ETML-ES-SLO/PRJ_2126_AffichageMatriciel/doc/Rapports/PPT/2126_AffichageMatricielNomEtudiant_PresentationPreEtude.pptx

## Pré-étude

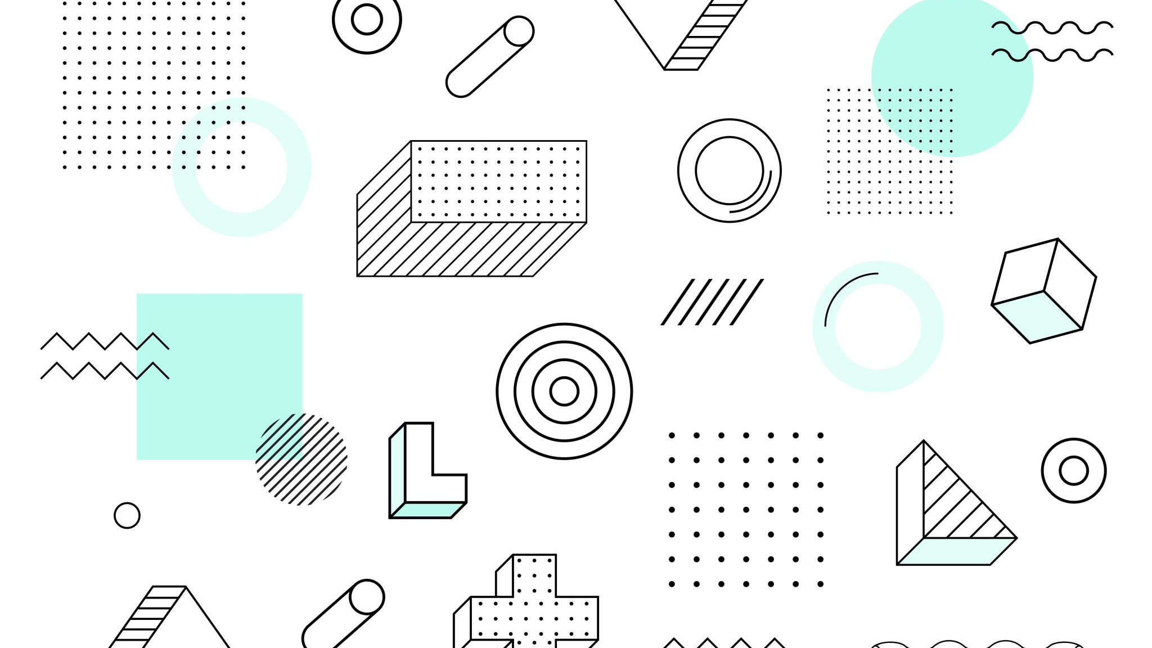
[picture p2: figure]

Projet n°2126
Affichage Matriciel Nom Etudiant

Ricardo Crespo

15 décembre 2021

## Table des matières

- But
- Schémas bloc
- Choix des technologies
- Estimation des coûts
- Conclusion
- Questions

## But du projet

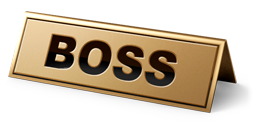
[picture p3: figure]
Download Boss Thank You Letter Templates | Text | Word | PDF

- Afficher le nom des élèves de première année
- Affichage connecté avec juste un câble USB
- Détection du nom automatique avec le compte de l’élève
- Contraintes de consommation

## Schéma bloc général

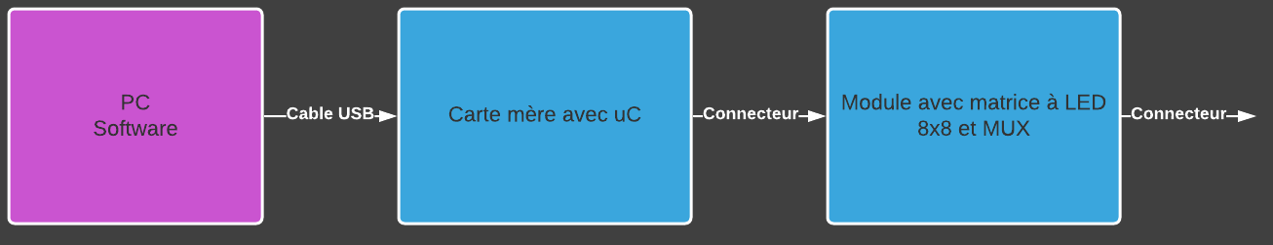
[picture p4: figure]
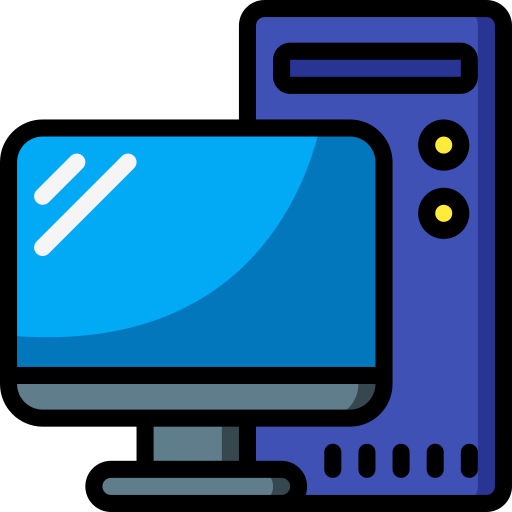
[picture p5: figure]
Pc free icon
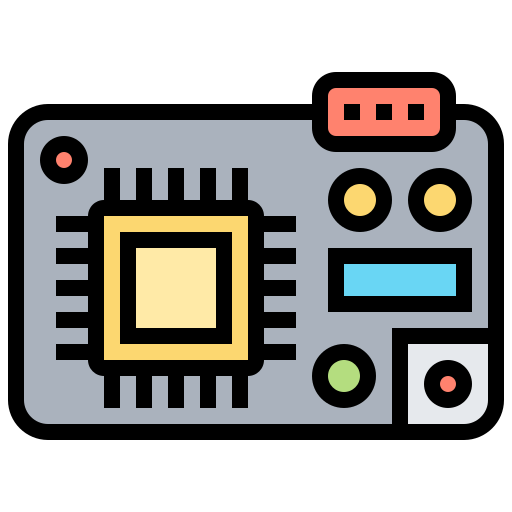
[picture p6: figure]
Microcontroller - Free electronics icons
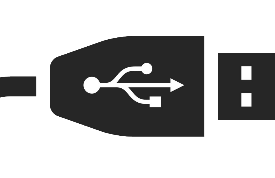
[picture p7: figure]
Computer, pc, ports, usb icon | Icon search engine
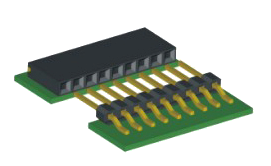
[picture p8: figure]
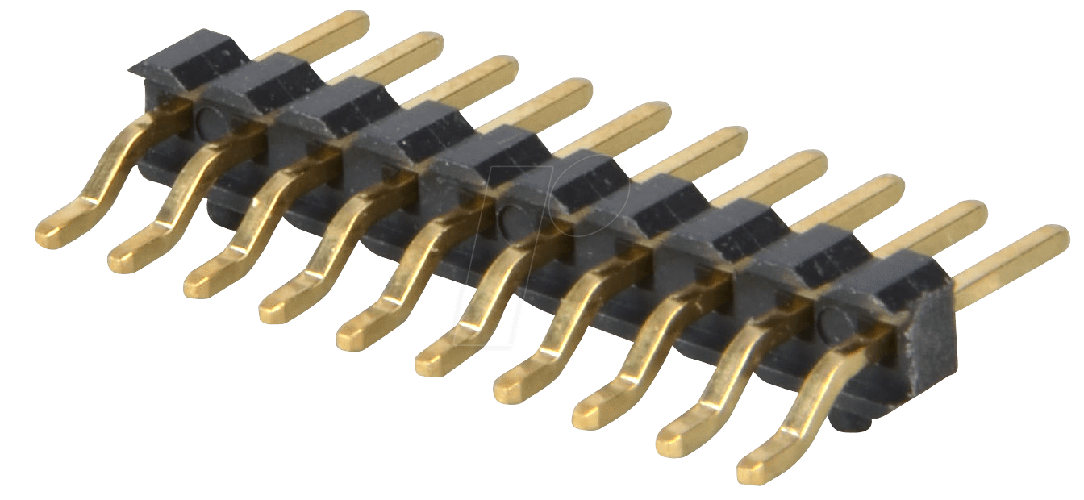
[picture p9: figure]
SL 1X10W SMD2,54: 10-pin SMD pin header, angled, pitch 2.54 at reichelt elektronik

## Schéma bloc général

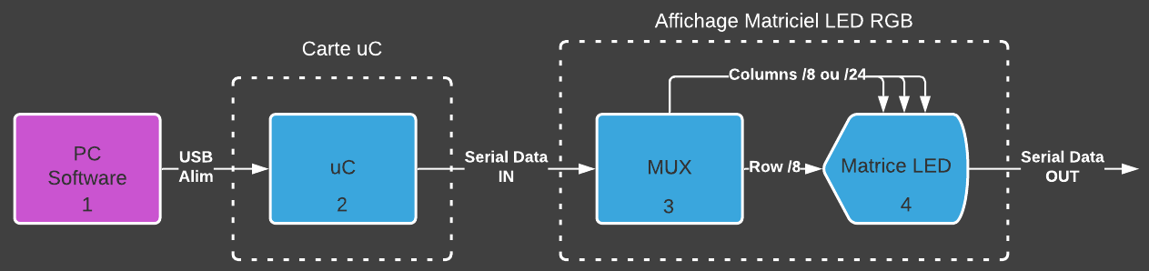
[picture p10: figure]

## Choix des technologies

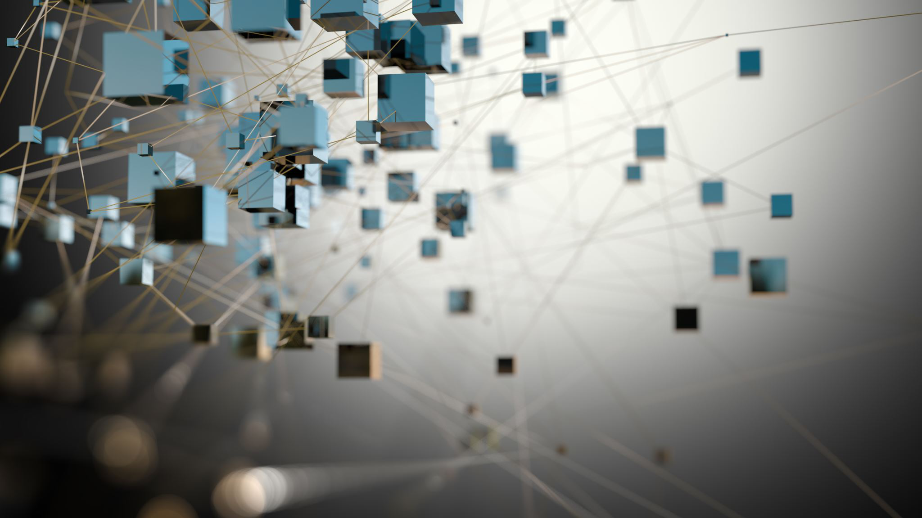
[picture p11: figure]
illustration d’un cube de cube bleu et or abstrait 3D

## LEDs

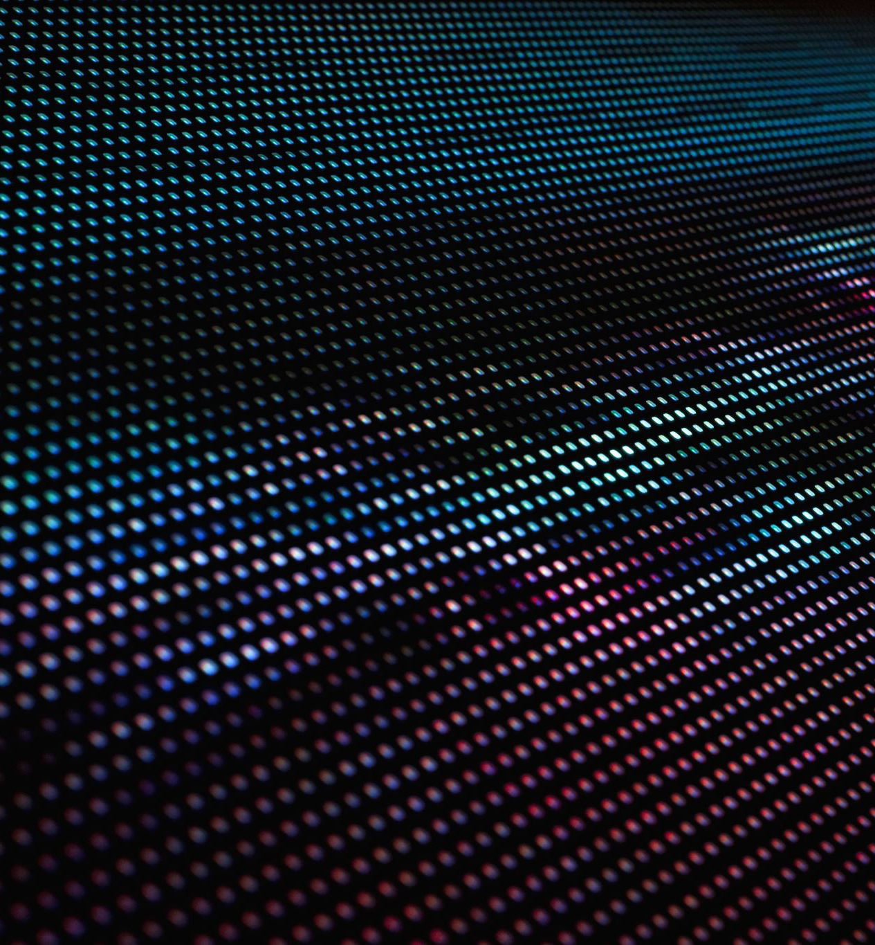
[picture p12: figure]
Vollbild-Nahaufnahme einer LED-Anzeige
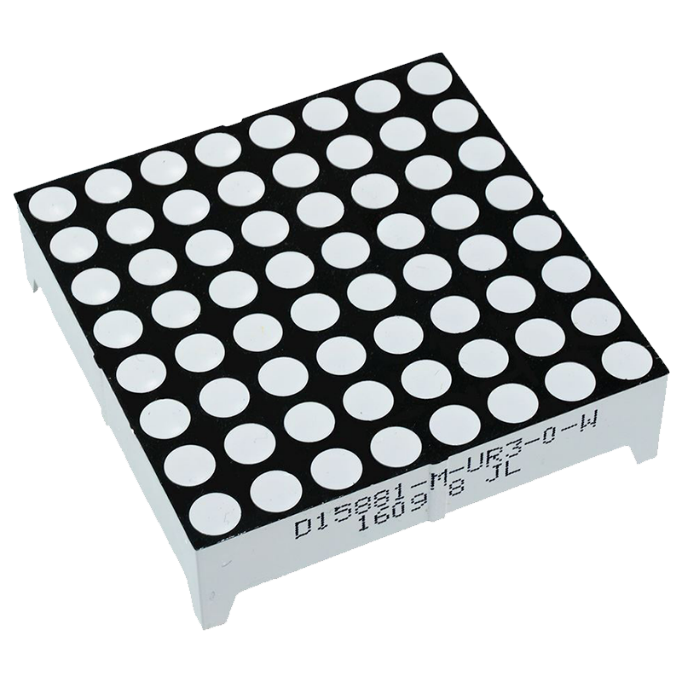
[picture p13: figure]
8X8 Mini Dot Matrix LED Display - Olelectronics

320mA

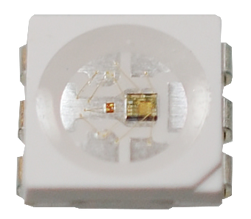
[picture p14: figure]
SML-LXR/SMD-LXR RGB Surface-Mount LEDs - Lumex | Mouser
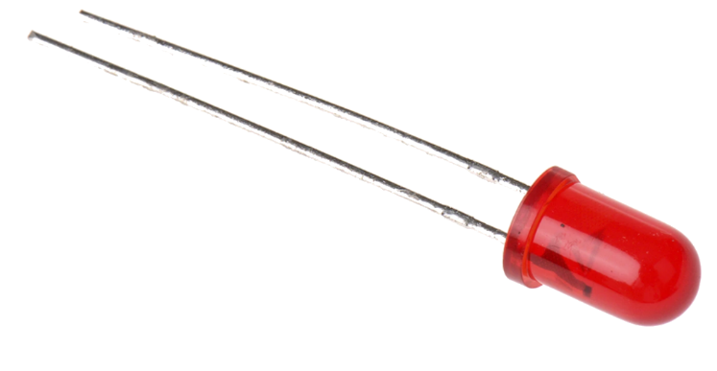
[picture p15: figure]

128mA

## Multiplexing

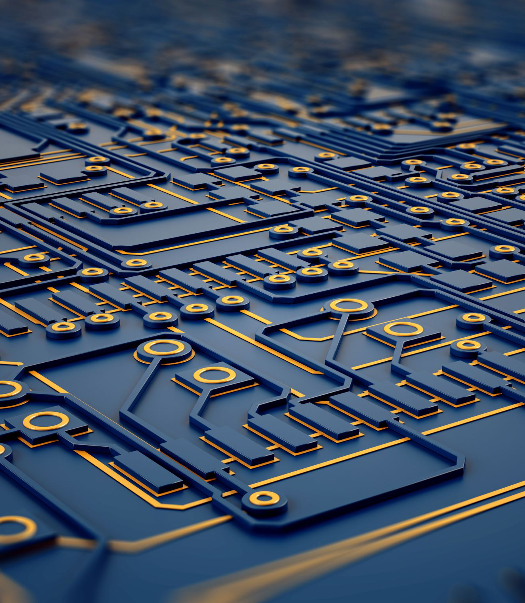
[picture p16: figure]
Microchips on a circuit board
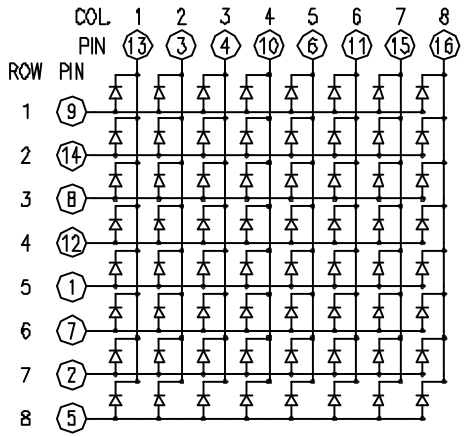
[picture p17: figure]
아두이노 &gt; Row-columm Scanning to control an 8x8 LED Matrix | Basic4MCU.com
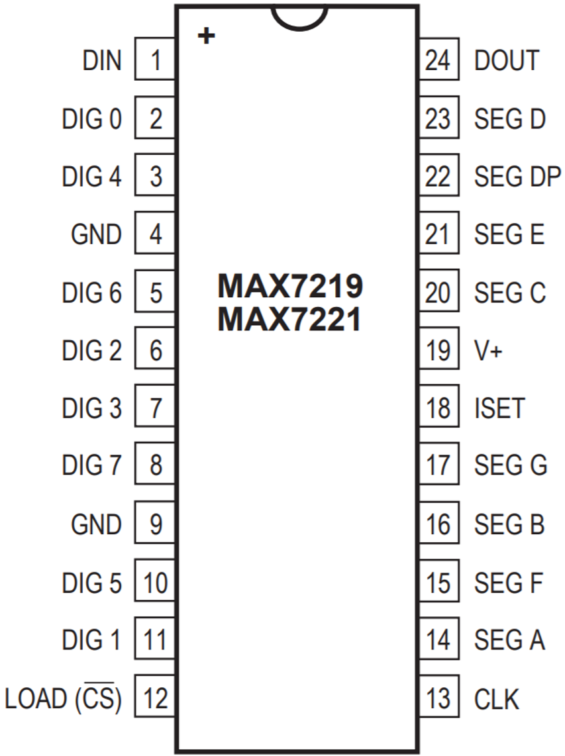
[picture p18: figure]

## Slide 9

PIC32MK0512MFC064

MCU

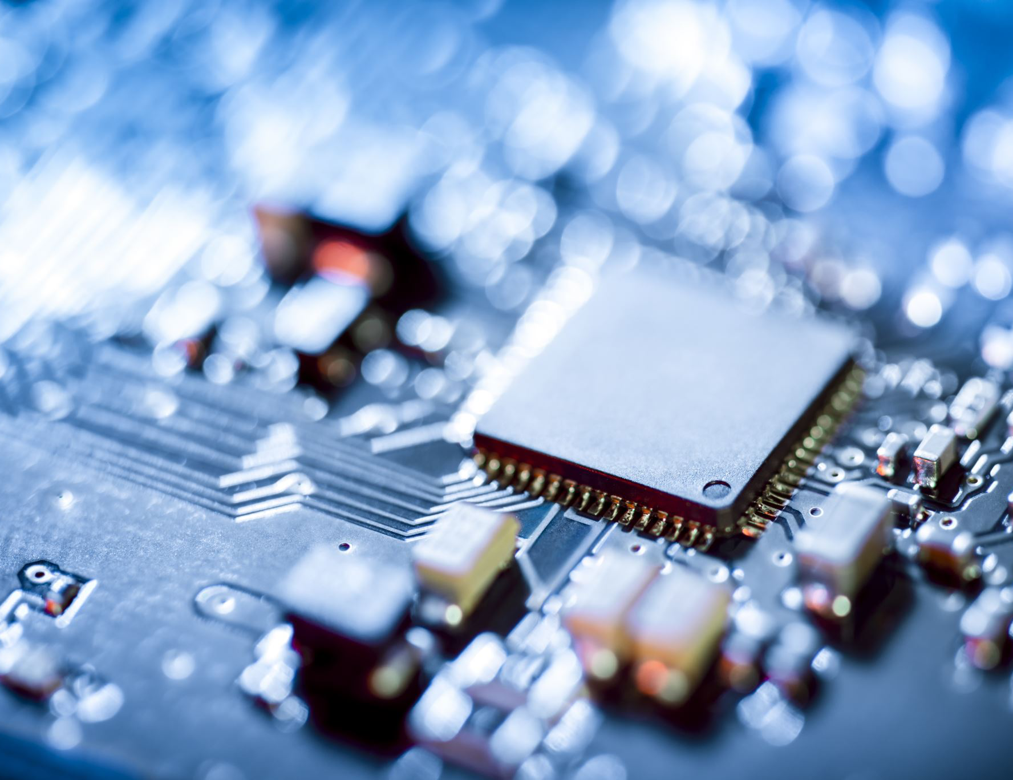
[picture p19: figure]
Circuit board
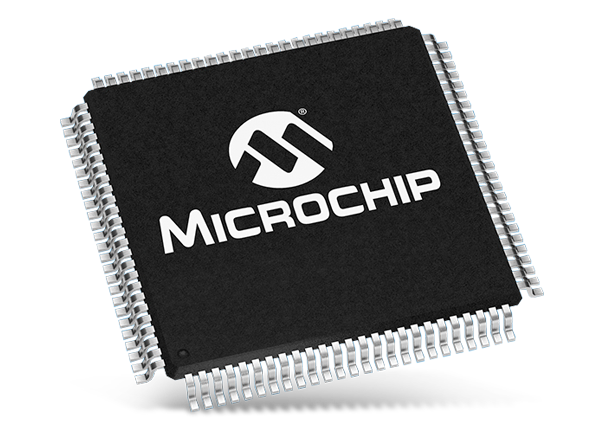
[picture p20: figure]
Microcontrôleurs 32 bits PIC32MZ - Microchip Technology | Mouser

## Estimation des coûts

UNIE | Quantité | Description | Supplier | Price unit | CHF | Price | CHF
| 144 | MAX7221 Serially Interfaced, 8-Digit LED Display Drivers | Aliexpress | 0,67 | CHF | 96,48 | CHF
| 10000 | LED RED DIFFUSED 5MM T/H | DigiKey | 0,10323 | CHF | 1032,3 | CHF
| 18 | PIC32MK0512MCF064T-I/PT | DigiKey | 7,79 | CHF | 140,22 | CHF
| 144 | PCB Matrix | Eurocircuit | 3 | CHF | 432 | CHF
| 18 | PCB MainBoard uC | Eurocircuit | 4 | CHF | 72 | CHF
| | | | Total | | 1773 | CHF
| | | | Unitaire | | 98,5 | CHF

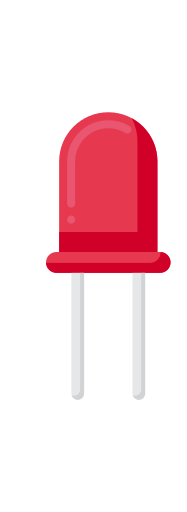
[picture p21: figure]
Rgb free icon
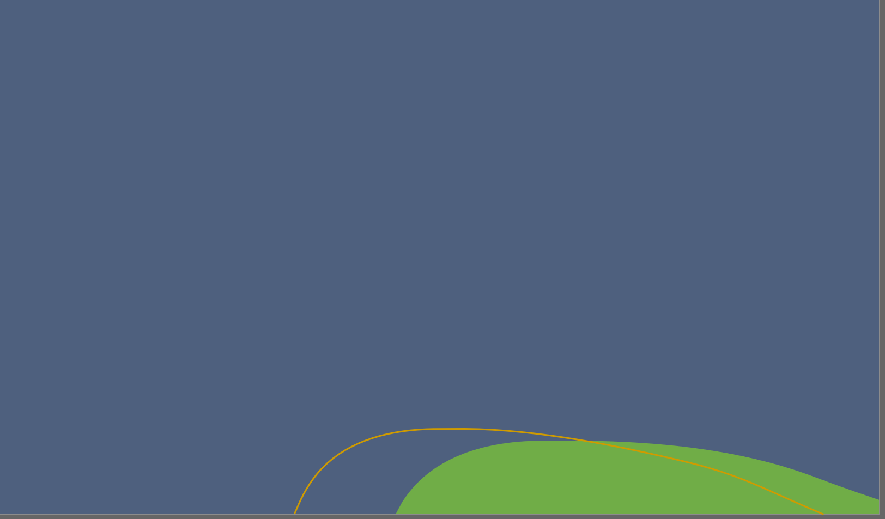
[picture p22: figure]

RGB | Quantité | Description | Supplier | Price unit | CHF | Price | CHF
| 432 | MAX7221 Serially Interfaced, 8-Digit LED Display Drivers | Aliexpress | 0,67 | CHF | 289,44 | CHF
| 10000 | LED standard - CMS RGB LED OSIRE E3635 | Mouser | 0,172 | CHF | 1720 | CHF
| 18 | PIC32MK0512MCF064T-I/PT | DigiKey | 7,79 | CHF | 140,22 | CHF
| 144 | PCB Matrix | Eurocircuit | 3 | CHF | 432 | CHF
| 18 | PCB MainBoard uC | Eurocircuit | 4 | CHF | 72 | CHF
| | | | Total | | 2653,66 | CHF
| | | | Unitaire | | 147,43 | CHF

880,66 CHF

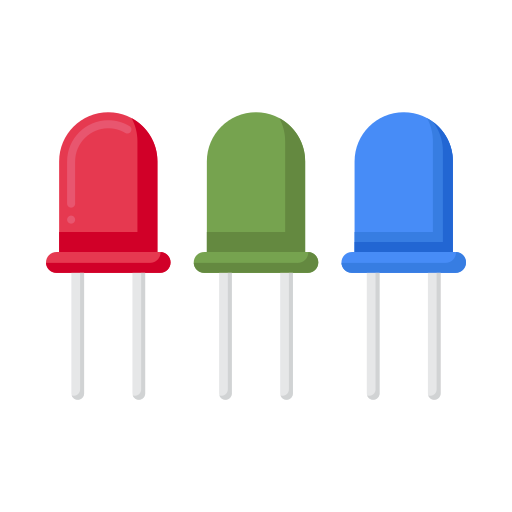
[picture p23: figure]
Rgb free icon

## Conclusion

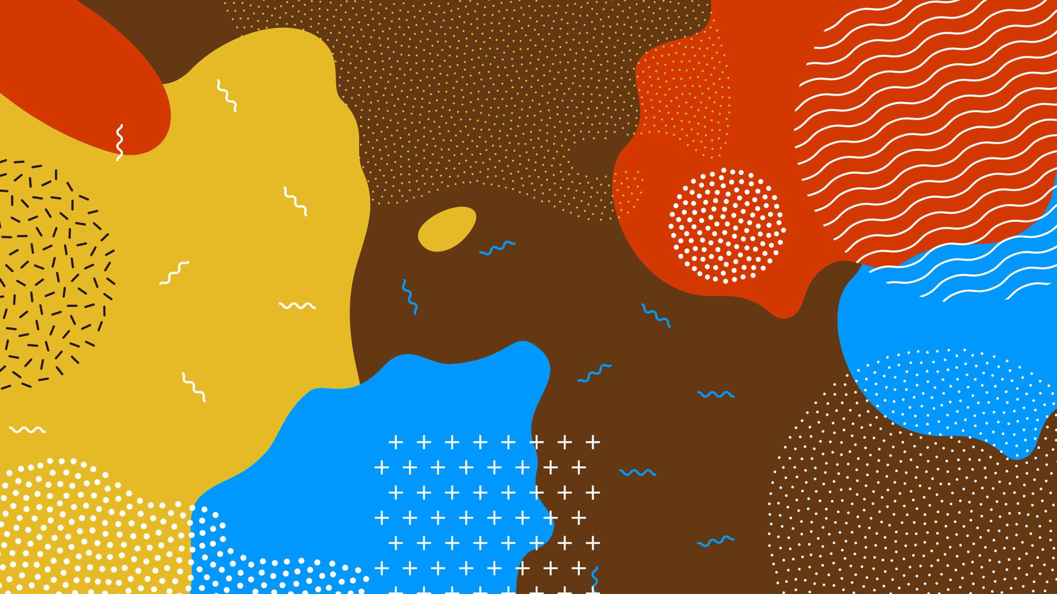
[picture p24: figure]

## Questions ?

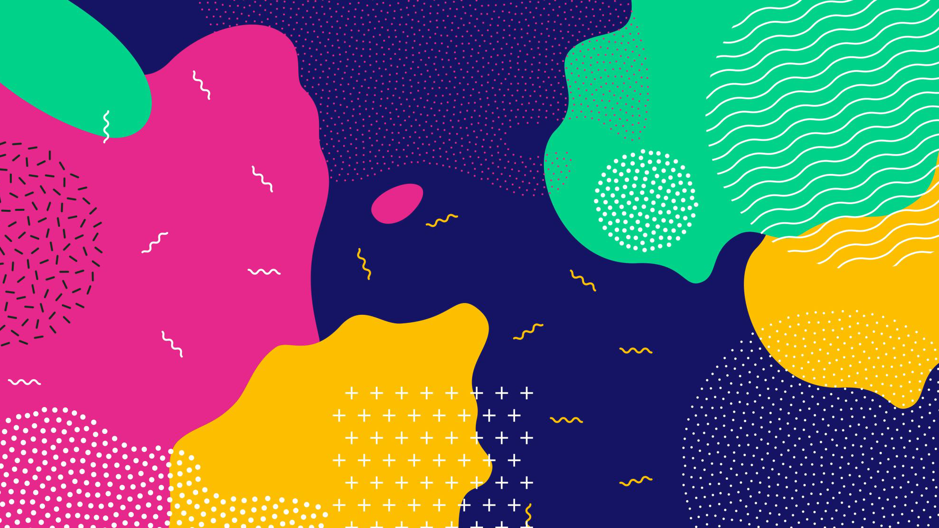
[picture p25: figure]

## Sources

https://www.flaticon.com/free-icon/pc_2292038?related_id=2292038&origin=search
https://icon-library.com/icon/usb-port-icon-0.html
https://www.flaticon.com/free-icon/microcontroller_2752878
https://usefulicons.com/useful/dot-matrix-display
https://www.alibaba.com/product-detail/8-position-90-180-degree-male_60619529074.html
https://www.reichelt.com/de/en/10-pin-smd-pin-header-angled-pitch-2-54-sl-1x10w-smd2-54-p51754.html
https://wikidownload.com/wiki/boss-thank-you-letter-templates/
https://www.olelectronics.in/product/88-mini-dot-matrix-led-display/
https://www.digikey.ch/fr/products/detail/vishay-semiconductor-opto-division/TLLR5401/4074719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
https://www.mouser.ch/new/lumex/lumex-sml-lx-smd-lx-leds/
https://www.tertiaryrobotics.com/led-bulbs.html
https://www.google.com/url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
https://www.flaticon.com/free-icon/rgb_4727120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
https://www.mouser.ch/new/microchip/microchip-pic32mz-mcus/
