ETML-ES-SLO/PRJ_2126_AffichageMatriciel/doc/ModeEmploi/ModedEmploi_2126.docx

Rapport de laboratoire

Ecole supérieure

Électronique

PROJ

SLO2

# Mode d’emploi

# 2126 Affichage Matriciel Nom Etudiant

Réalisé par :

Ricardo Crespo

A l’attention de :

Toute personne utilisant le projet

Dates :

Début : 16 juin 2022

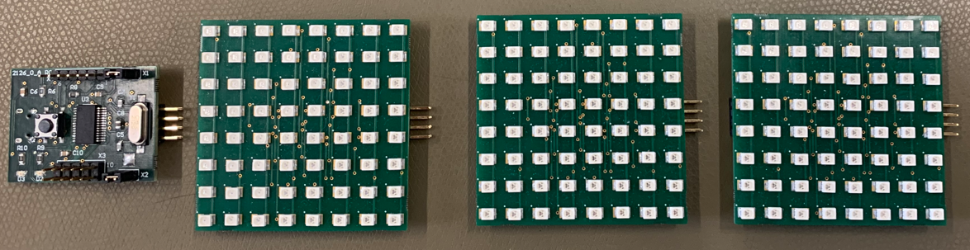
[picture p67: figure]

Commencez par choisir la configuration que vous voulez, et interconnecter le nombre de matrices que vous voulez.

Figure 1 Configuration avec trois Matrix

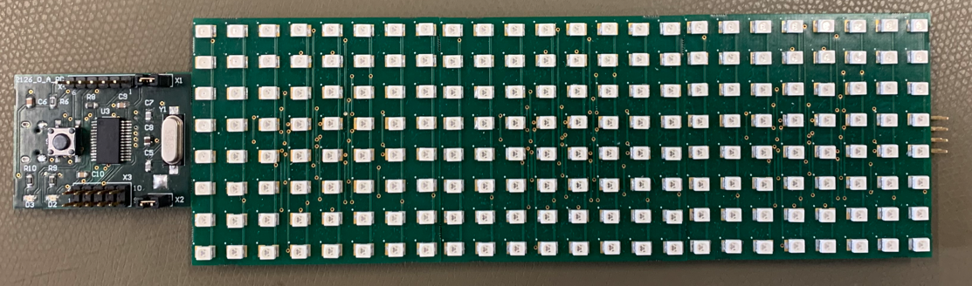
[picture p68: figure]

Puis connectés la Matrix entre elles, et celle de gauche à la MainBoard.

Figure 2 Trois Matrix connectées à la MainBoard

Puis il vous faudra compléter le tout en insérant le jumper de rebouclement.

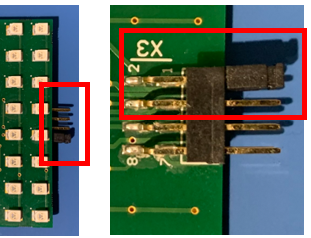
[picture p69: figure]

Figure 3 Connection du jumpet vue de dessus et de dessous

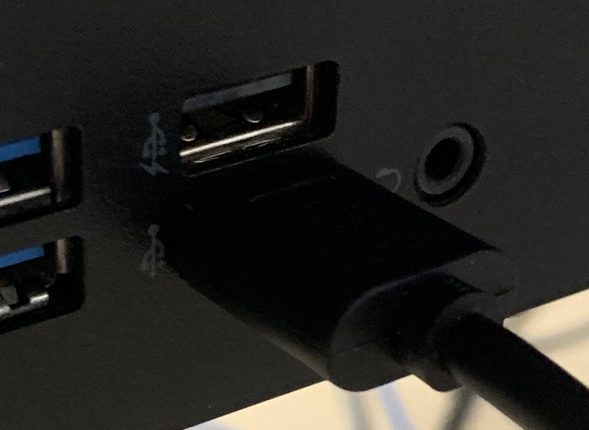
[picture p70: figure]
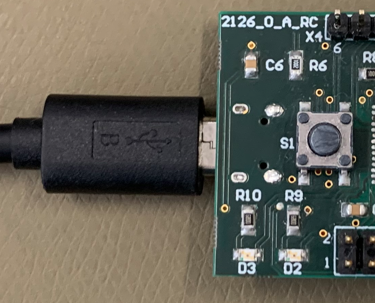
[picture p71: figure]

Enfin il ne vous reste plus qu’à connecter la system au PC via un câble micro-USB vers USB.

Figure 4 Connection USB au PC

Figure 5 Connection micro-USB à la MainBoard

La dernière étape qui vous reste à faire, est de lancer l’application sur le PC, via une session loguée.

Ricardo Crespo 2 | 2

Mode d’emploi PROJ
