ETML-ES-SLO/PRJ_2126_AffichageMatriciel/doc/Rapports/PDF/Plannification.pdf

ETML | Annexe 1 : Plannification | DIPLOME

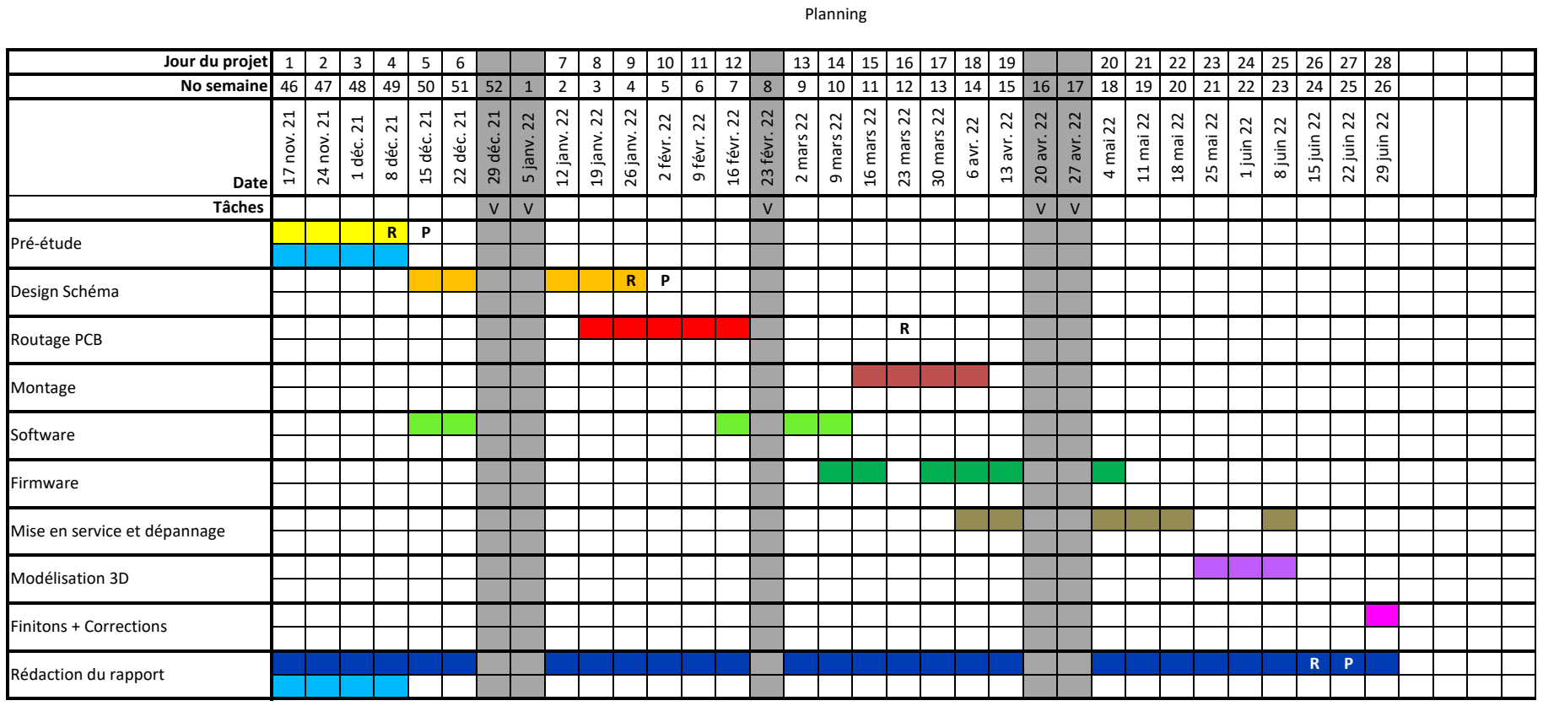
[picture p75: figure]
Jour du projet; No semaine; Date; 17 nov. 21; 24 nov. 21; 1 déc. 21; 8 déc. 21; 15 déc. 21; 22 déc. 21; 29 déc. 21; 5 janv. 22; 12 janv. 22; 19 janv. 22; 26 janv. 22; 2 févr. 22; 9 févr. 22; 16 févr. 22; 23 févr. 22; 2 mars 22; 9 mars 22; 16 mars 22; 23 mars 22; 30 mars 22; 6 avr. 22; 13 avr. 22; 20 avr. 22; 27 avr. 22; 4 mai 22; 11 mai 22; 18 mai 22; 25 mai 22; 1 juin 22; 8 juin 22; 15 juin 22; 22 juin 22; 29 juin 22; Tâches; Pré-étude; Rédaction du rapport; Modélisation 3D; Planning; Finitons + Corrections; Mise en service et dépannage; Design Schéma; Montage; Routage PCB; Software; Firmware

11.12.2021 | 1/1 | Dimitrijevic Nikola
