ETML-ES-SLO/PRJ_2126_AffichageMatriciel/doc/Rapports/EXCEL/Plannification.xlsx

 | Planning
Jour du projet | 1 | 2 | 3 | 4 | 5 | 6 |  |  | 7 | 8 | 9 | 10 | 11 | 12 |  | 13 | 14 | 15 | 16 | 17 | 18 | 19 |  |  | 20 | 21 | 22 | 23 | 24 | 25 | 26 | 27 | 28
No semaine | 46 | 47 | 48 | 49 | 50 | 51 | 52 | 1 | 2 | 3 | 4 | 5 | 6 | 7 | 8 | 9 | 10 | 11 | 12 | 13 | 14 | 15 | 16 | 17 | 18 | 19 | 20 | 21 | 22 | 23 | 24 | 25 | 26
Date | 2021-11-17 | 2021-11-24 | 2021-12-01 | 2021-12-08 | 2021-12-15 | 2021-12-22 | 2021-12-29 | 2022-01-05 | 2022-01-12 | 2022-01-19 | 2022-01-26 | 2022-02-02 | 2022-02-09 | 2022-02-16 | 2022-02-23 | 2022-03-02 | 2022-03-09 | 2022-03-16 | 2022-03-23 | 2022-03-30 | 2022-04-06 | 2022-04-13 | 2022-04-20 | 2022-04-27 | 2022-05-04 | 2022-05-11 | 2022-05-18 | 2022-05-25 | 2022-06-01 | 2022-06-08 | 2022-06-15 | 2022-06-22 | 2022-06-29
Tâches |  |  |  |  |  |  | V | V |  |  |  |  |  |  | V |  |  |  |  |  |  |  | V | V
Pré-étude |  |  |  | R | P
Design Schéma |  |  |  |  |  |  |  |  |  |  | R | P
Routage PCB |  |  |  |  |  |  |  |  |  |  |  |  |  |  |  |  |  |  | R
Montage
Software
Firmware
Mise en service et dépannage
Boitier
Finitons + Corrections
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
