ETML-ES-SLO/PRJ_2126_AffichageMatriciel/doc/Captures/Firmware/AppData.png

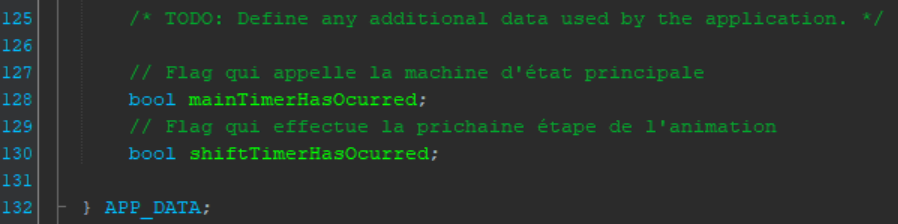
doc/Captures/Firmware/AppData.png
