ETML-ES-SLO/PRJ_2126_AffichageMatriciel/doc/Captures/Firmware/CallBacks.png

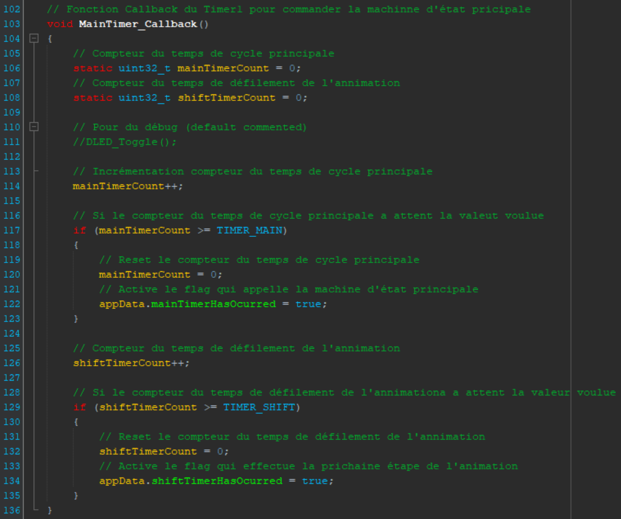
doc/Captures/Firmware/CallBacks.png
