ETML-ES-SLO/PRJ_2126_AffichageMatriciel/doc/Captures/Firmware/CanShifAnim.png

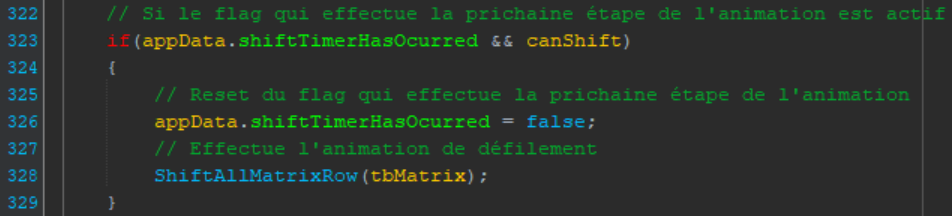
doc/Captures/Firmware/CanShifAnim.png
