ETML-ES-SLO/PRJ_2126_AffichageMatriciel/doc/Captures/Firmware/EndOfAddCharacter.png

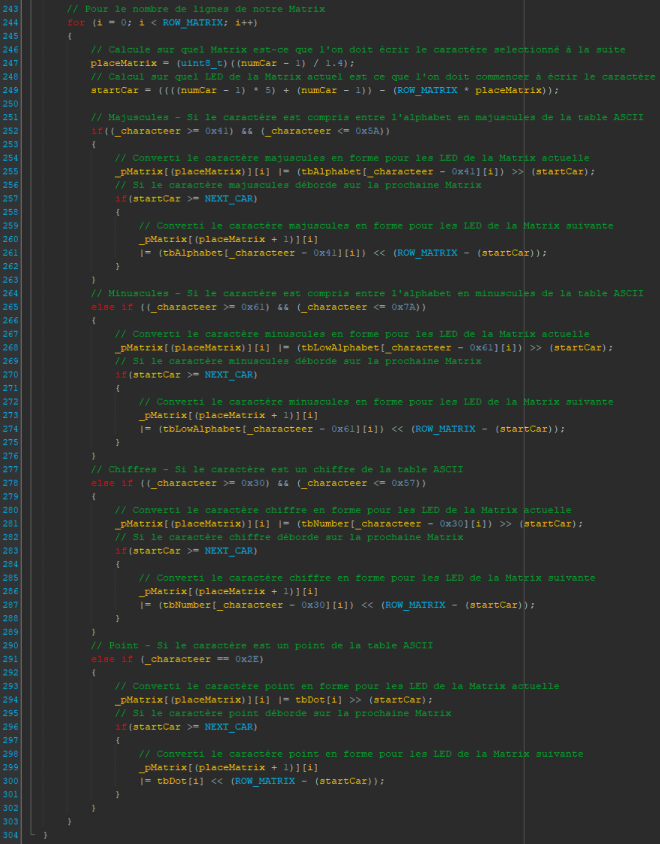
doc/Captures/Firmware/EndOfAddCharacter.png
