ETML-ES-SLO/PRJ_2126_AffichageMatriciel/doc/Captures/Firmware/EnvoyCle.png

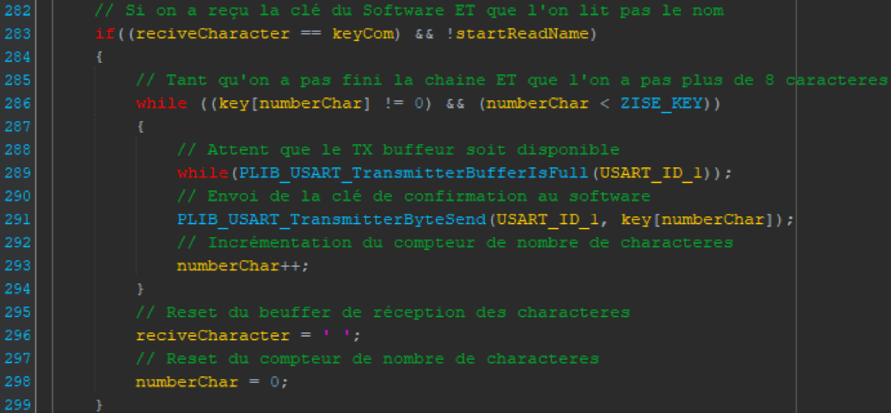
doc/Captures/Firmware/EnvoyCle.png
