ETML-ES-SLO/PRJ_2126_AffichageMatriciel/doc/Captures/Firmware/FoncReceptionUART.png

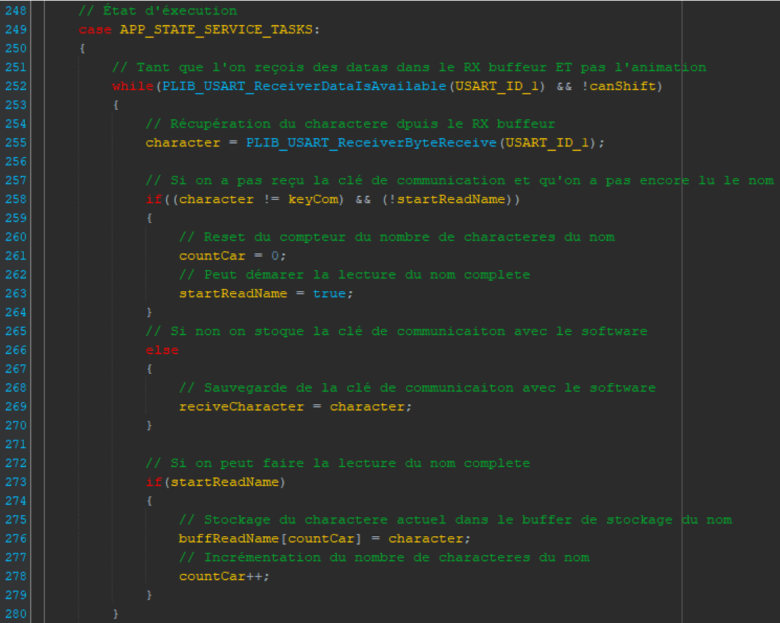
doc/Captures/Firmware/FoncReceptionUART.png
