ETML-ES-SLO/PRJ_2126_AffichageMatriciel/doc/Captures/Firmware/FoncSendAllMatrix.png

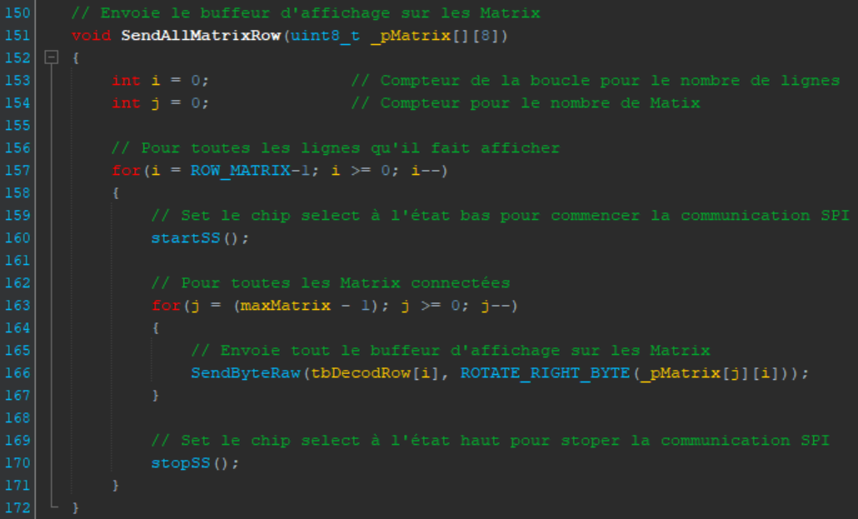
doc/Captures/Firmware/FoncSendAllMatrix.png
