ETML-ES-SLO/PRJ_2126_AffichageMatriciel/doc/Captures/Firmware/FonctionDetectionNumberMatrix.png

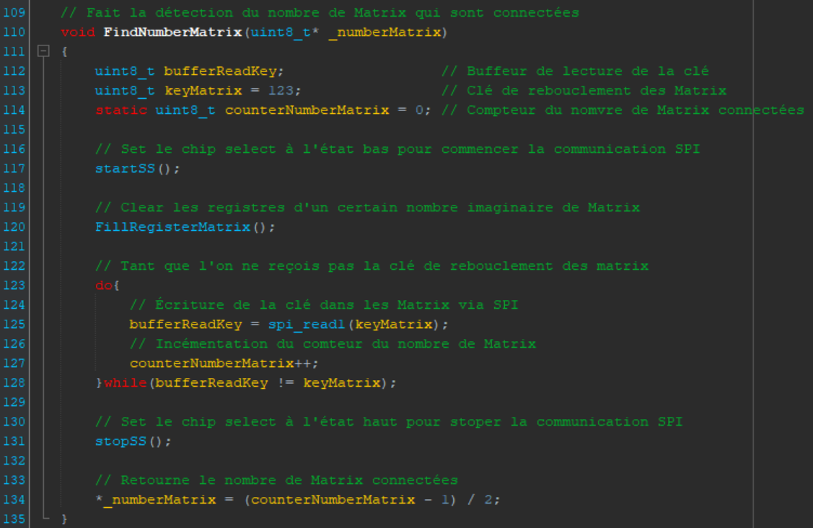
doc/Captures/Firmware/FonctionDetectionNumberMatrix.png
