ETML-ES-SLO/PRJ_2126_AffichageMatriciel/doc/Captures/Firmware/InitMatrix.png

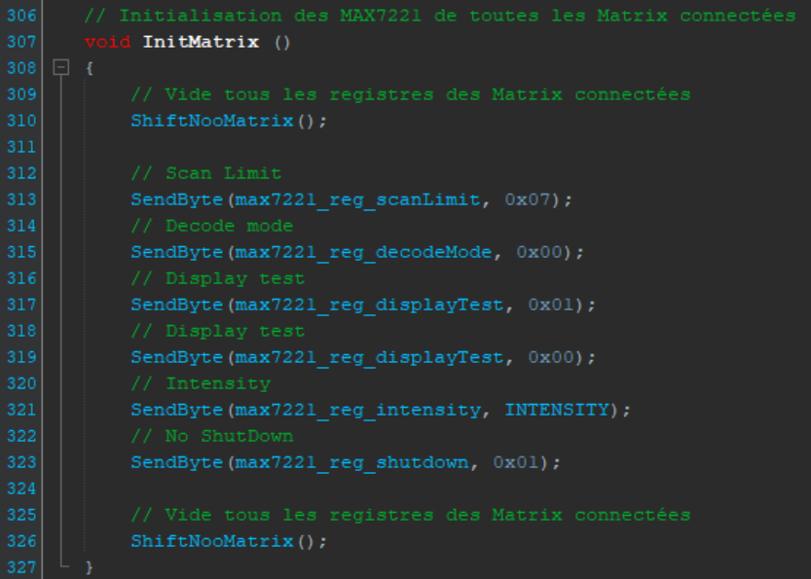
doc/Captures/Firmware/InitMatrix.png
