ETML-ES-SLO/PRJ_2126_AffichageMatriciel/doc/Captures/Firmware/ISRTimer1.png

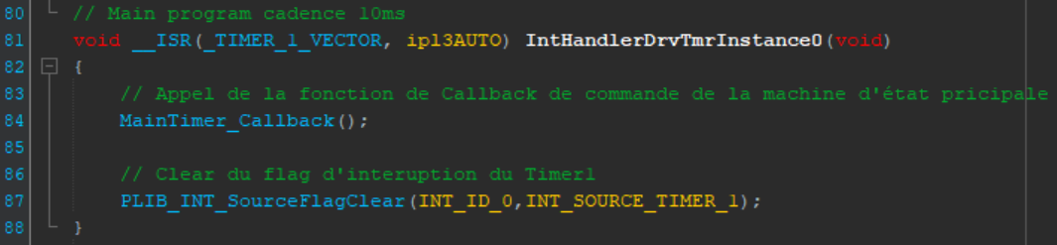
doc/Captures/Firmware/ISRTimer1.png
