ETML-ES-SLO/PRJ_2126_AffichageMatriciel/doc/Captures/Firmware/SendByte.png

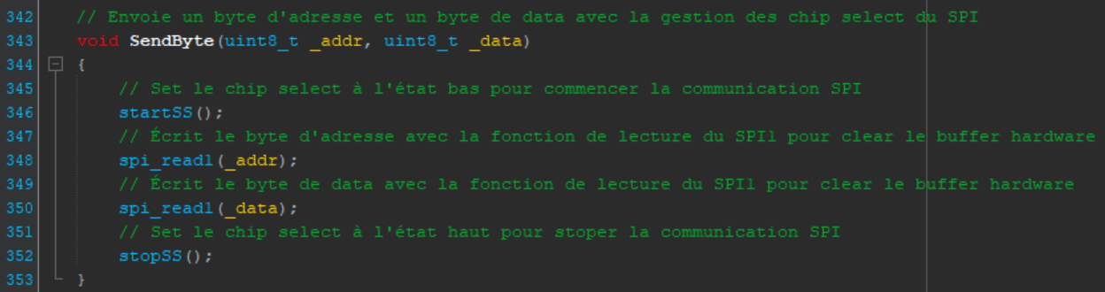
doc/Captures/Firmware/SendByte.png
