ETML-ES-SLO/PRJ_2126_AffichageMatriciel/doc/Captures/Firmware/SendText.png

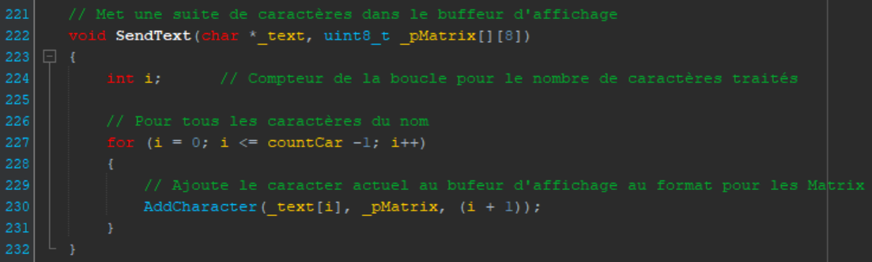
doc/Captures/Firmware/SendText.png
