ETML-ES-SLO/PRJ_2126_AffichageMatriciel/doc/Captures/Firmware/ShiftAnimation.png

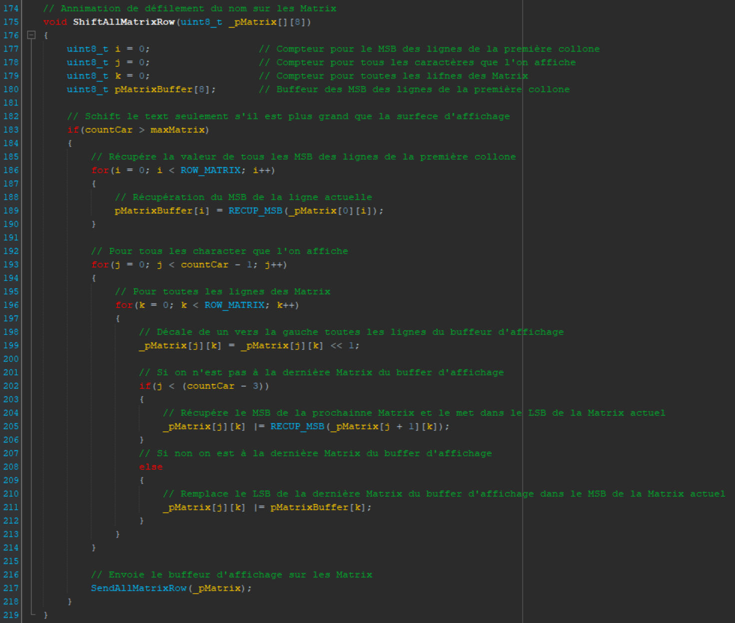
doc/Captures/Firmware/ShiftAnimation.png
