ETML-ES-SLO/PRJ_2126_AffichageMatriciel/doc/Captures/Firmware/SPI.png

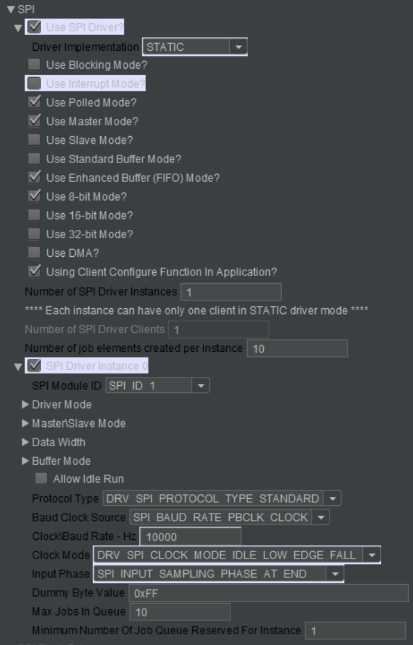
doc/Captures/Firmware/SPI.png
