ETML-ES-SLO/PRJ_2126_AffichageMatriciel/doc/Captures/Firmware/StartOfAddCharacter.png

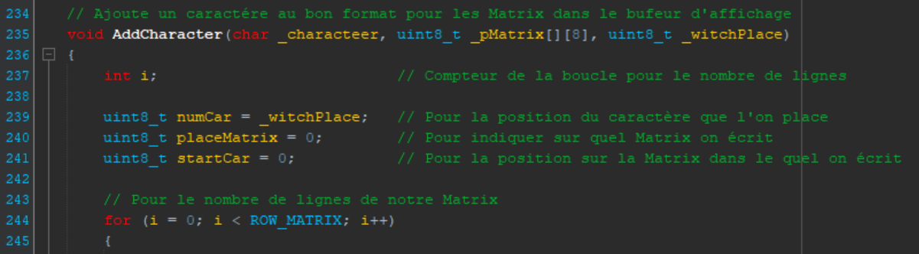
doc/Captures/Firmware/StartOfAddCharacter.png
