ETML-ES-SLO/PRJ_2126_AffichageMatriciel/doc/Captures/Firmware/Timer1.png

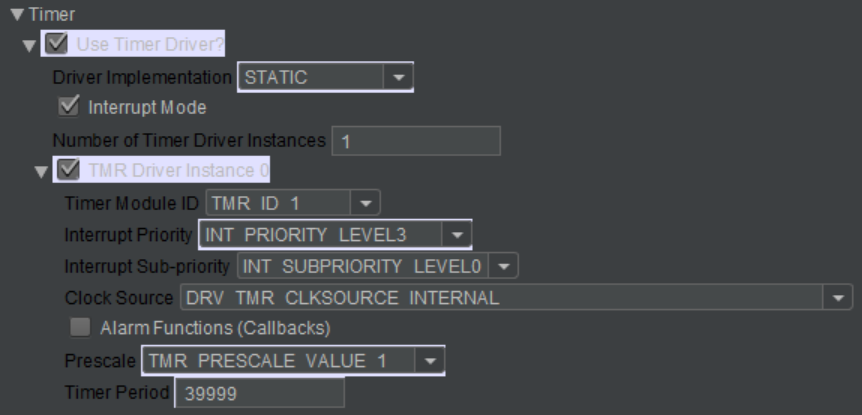
doc/Captures/Firmware/Timer1.png
