ETML-ES-SLO/PRJ_2126_AffichageMatriciel/doc/Captures/Firmware/TraitementNom.png

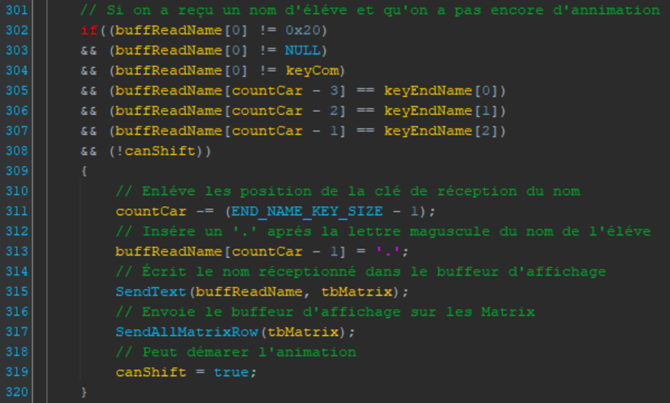
doc/Captures/Firmware/TraitementNom.png
