ETML-ES-SLO/PRJ_2126_AffichageMatriciel/doc/Captures/Firmware/UART.png

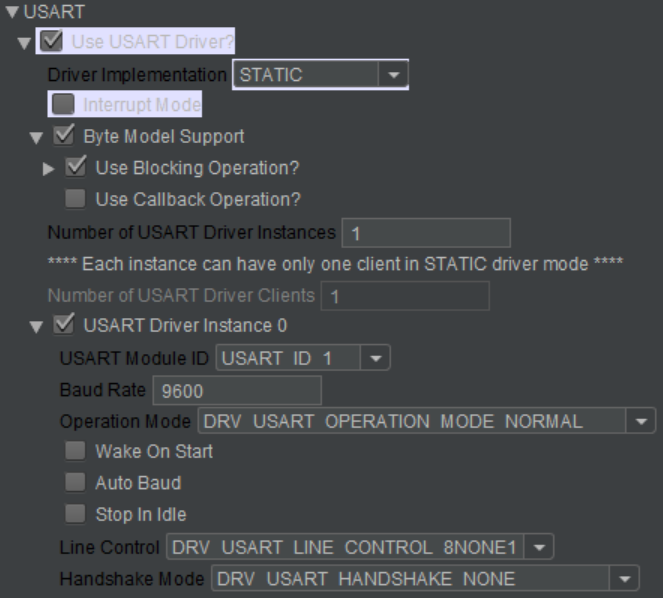
doc/Captures/Firmware/UART.png
