ETML-ES-SLO/PRJ_2126_AffichageMatriciel/doc/Captures/IMG_2670.jpg

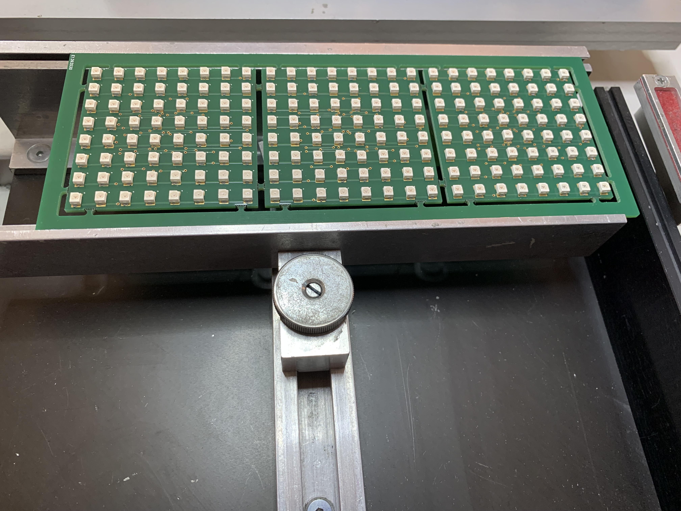
doc/Captures/IMG_2670.jpg
