ETML-ES-SLO/PRJ_2126_AffichageMatriciel/doc/Captures/IMG_3377.jpg

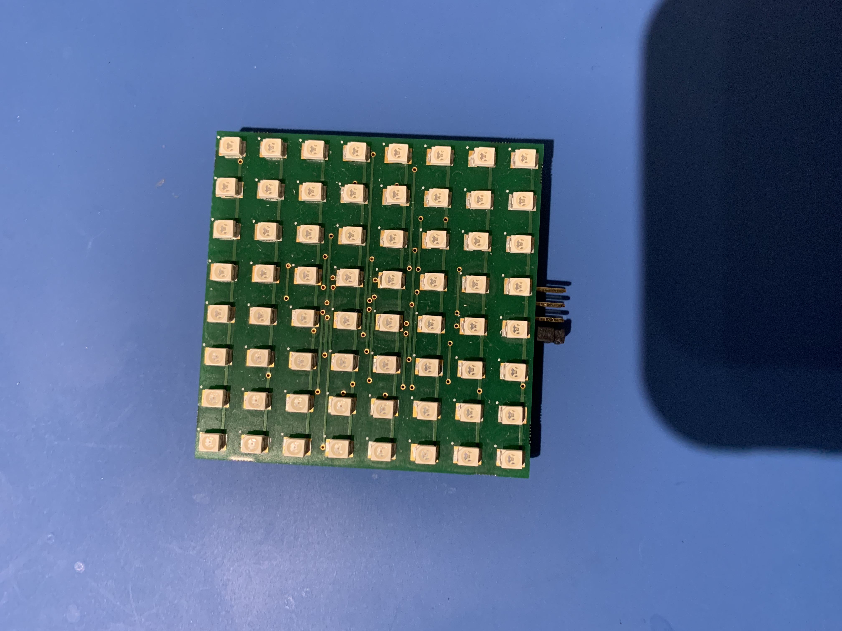
doc/Captures/IMG_3377.jpg
