ETML-ES-SLO/PRJ_2126_AffichageMatriciel/doc/Captures/IMG_3378.jpg

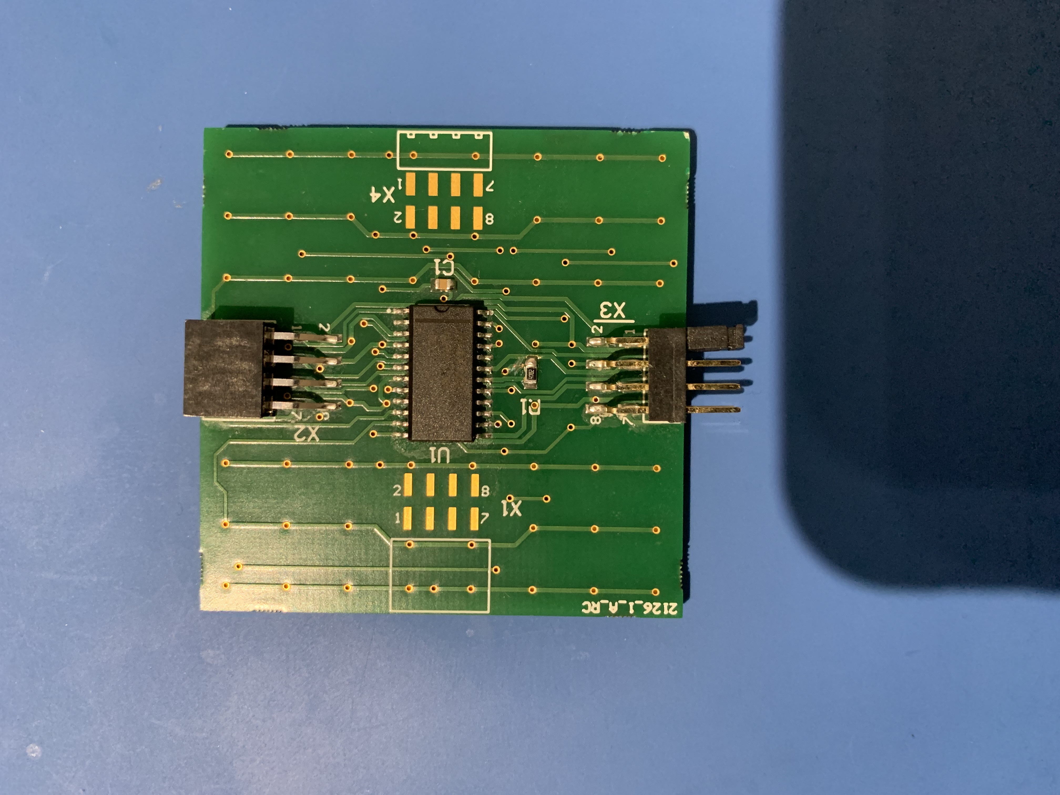
doc/Captures/IMG_3378.jpg
