ETML-ES-SLO/PRJ_2126_AffichageMatriciel/doc/Captures/IMG_3405.jpg

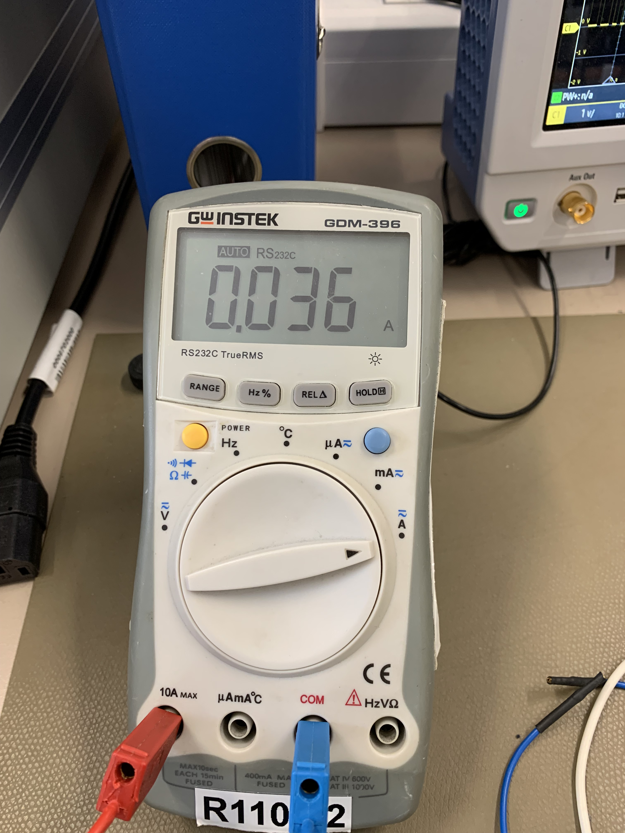
doc/Captures/IMG_3405.jpg
