ETML-ES-SLO/PRJ_2126_AffichageMatriciel/doc/Captures/Software/EndTryCom.png

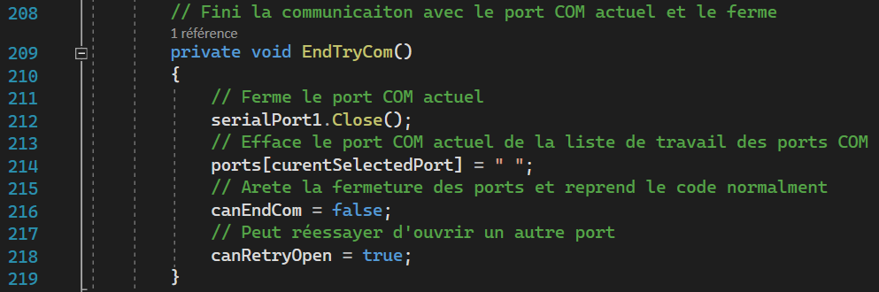
doc/Captures/Software/EndTryCom.png
