ETML-ES-SLO/PRJ_2126_AffichageMatriciel/doc/Captures/Software/EventTImer1.png

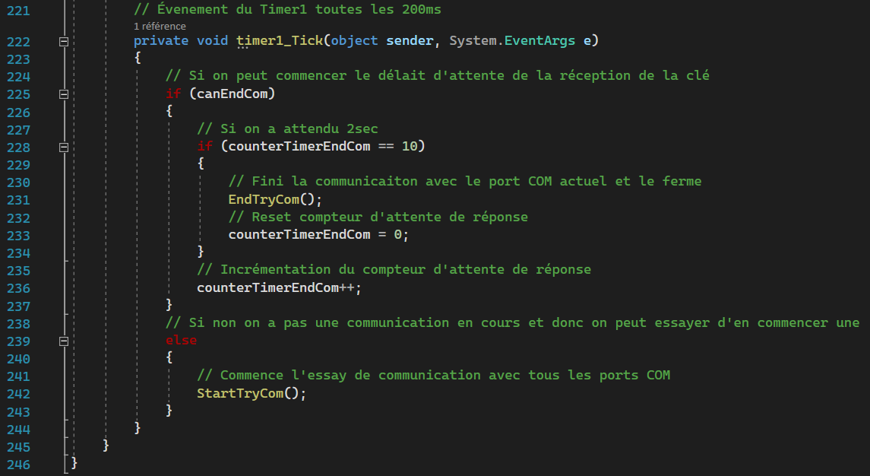
doc/Captures/Software/EventTImer1.png
