ETML-ES-SLO/PRJ_2126_AffichageMatriciel/doc/Captures/Software/Inits.png

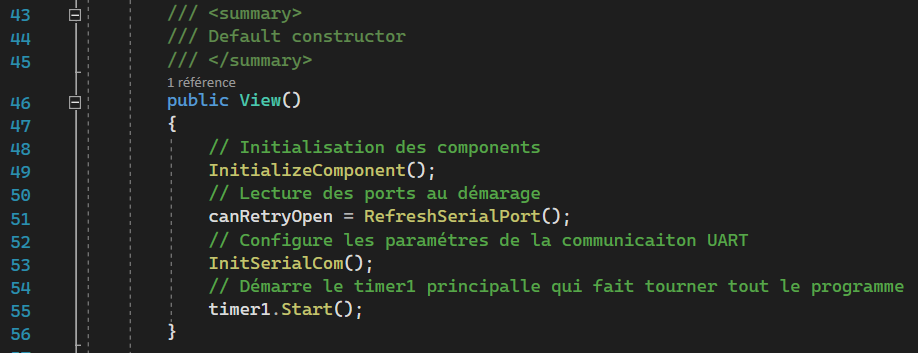
doc/Captures/Software/Inits.png
