ETML-ES-SLO/PRJ_2126_AffichageMatriciel/doc/Captures/Software/Refresh.png

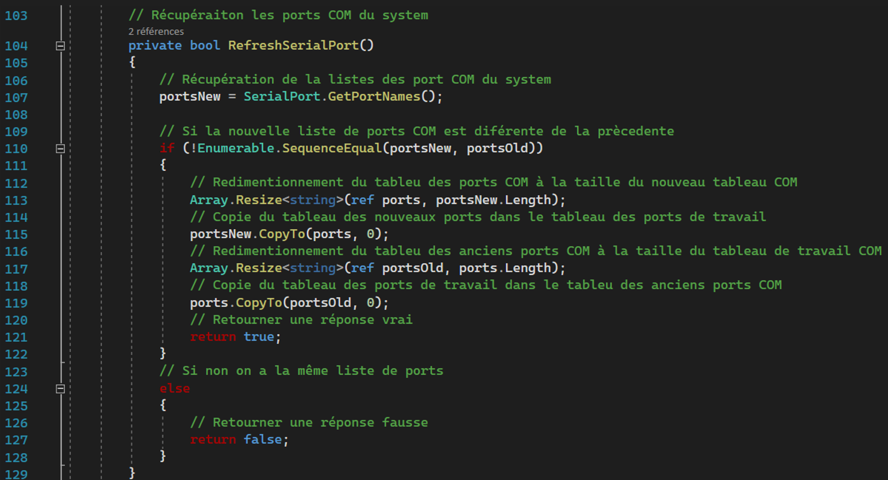
doc/Captures/Software/Refresh.png
