ETML-ES-SLO/PRJ_2126_AffichageMatriciel/doc/Captures/Software/SendMesageCom.png

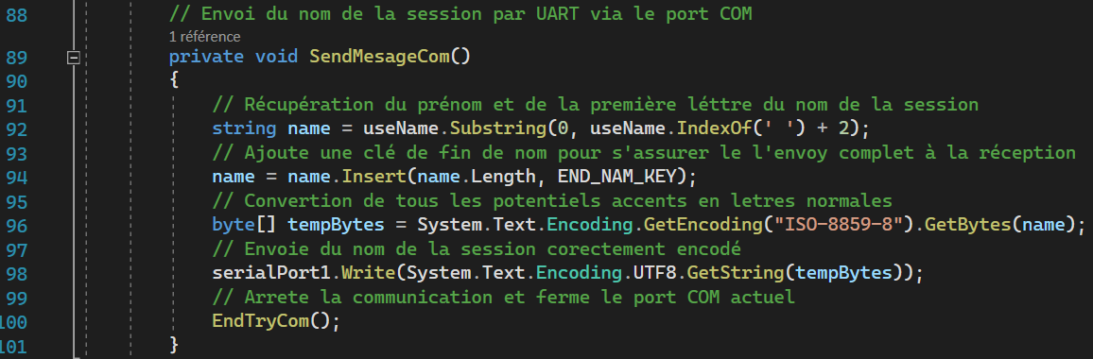
doc/Captures/Software/SendMesageCom.png
