ETML-ES-SLO/PRJ_2126_AffichageMatriciel/doc/Captures/Software/StartTryConnection.png

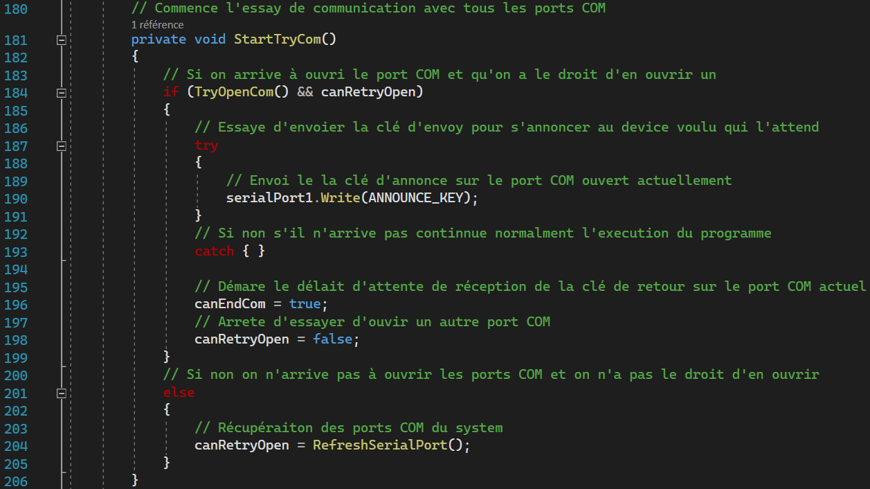
doc/Captures/Software/StartTryConnection.png
