ETML-ES-SLO/PRJ_2126_AffichageMatriciel/doc/Captures/Software/TryOpenCom.png

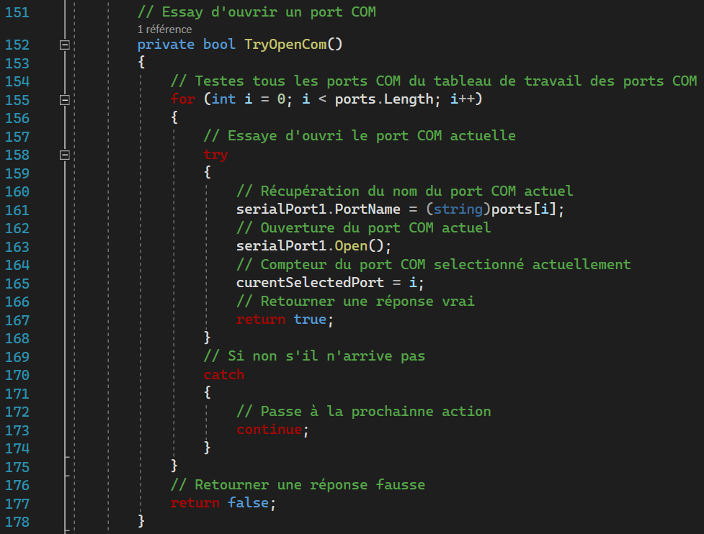
doc/Captures/Software/TryOpenCom.png
