ETML-ES-SLO/PRJ_2126_AffichageMatriciel/doc/Mesures/SPI/AnimationDisplay.png

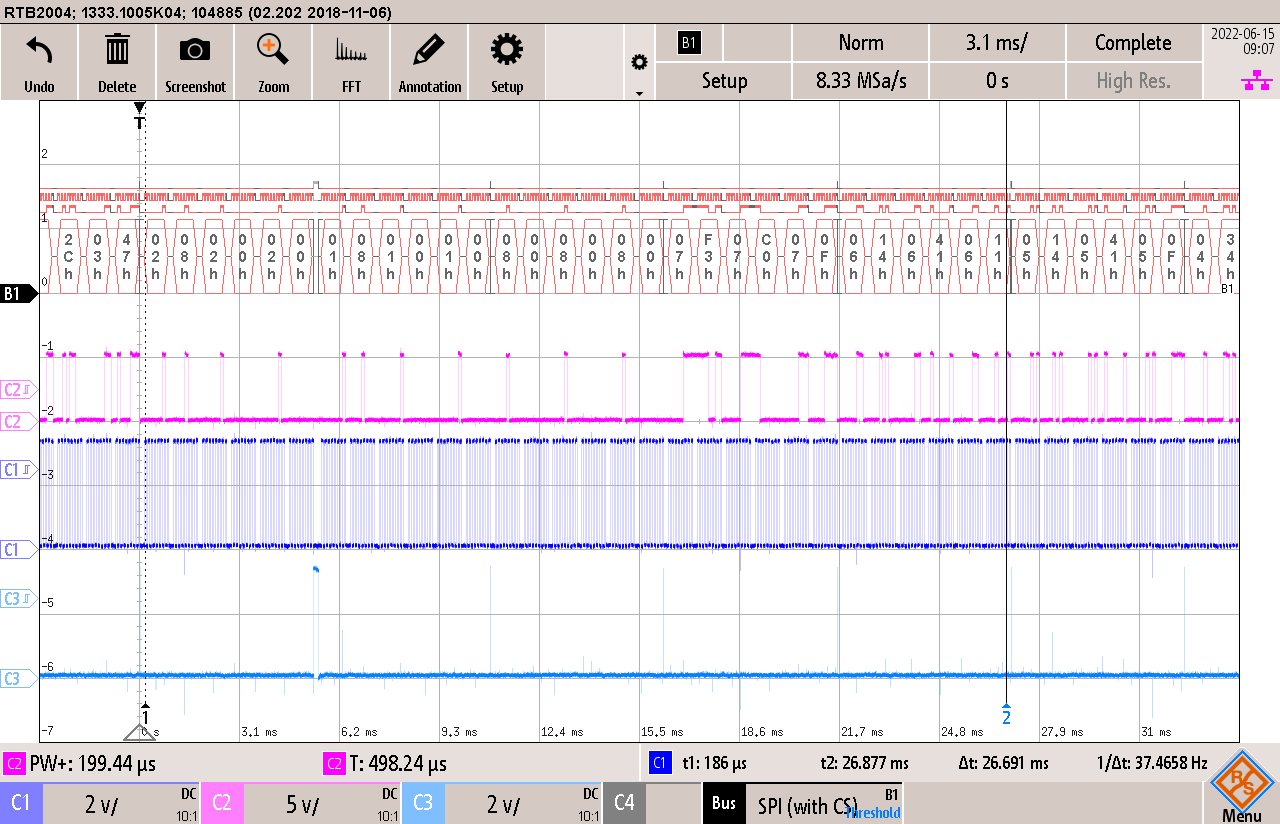
doc/Mesures/SPI/AnimationDisplay.png
