ETML-ES-SLO/PRJ_2126_AffichageMatriciel/doc/Mesures/SPI/Config1.png

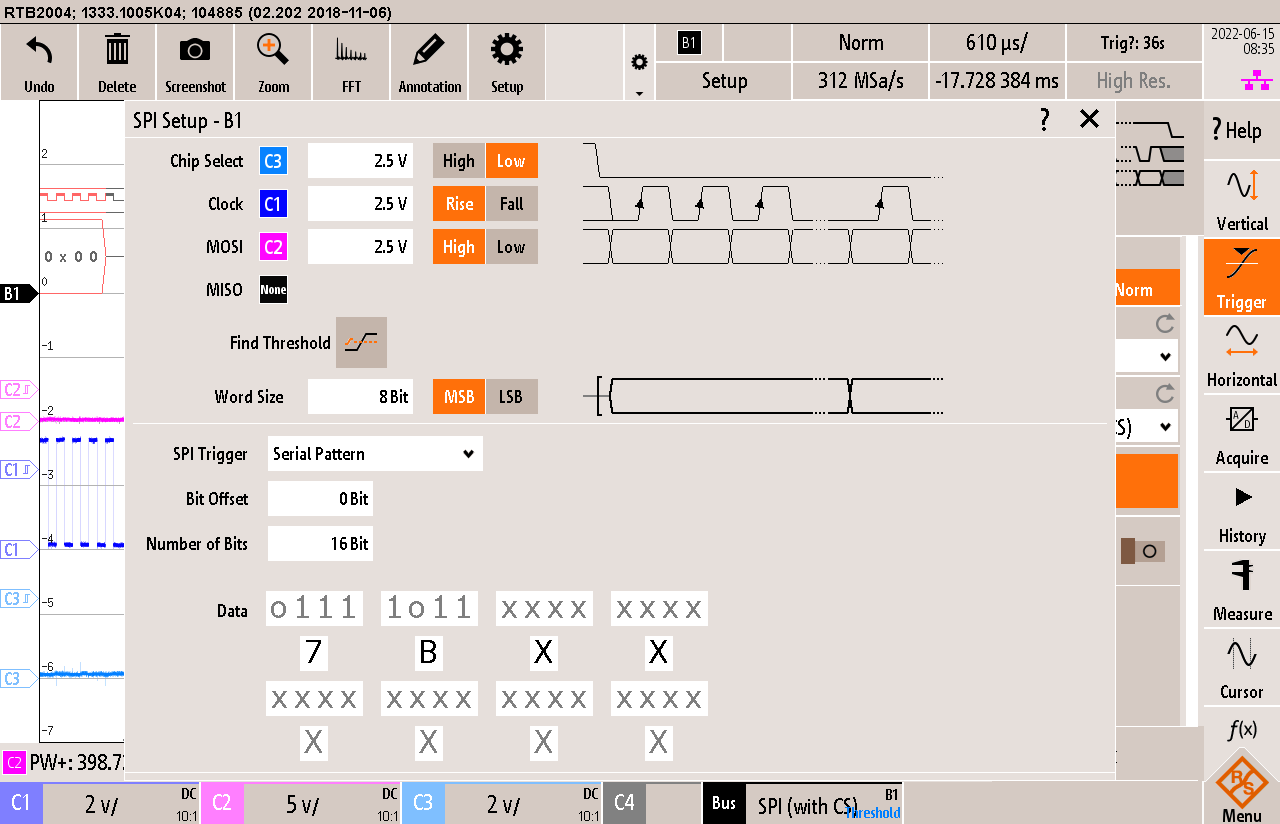
doc/Mesures/SPI/Config1.png
