ETML-ES-SLO/PRJ_2126_AffichageMatriciel/doc/Mesures/SPI/ConfigAnim.png

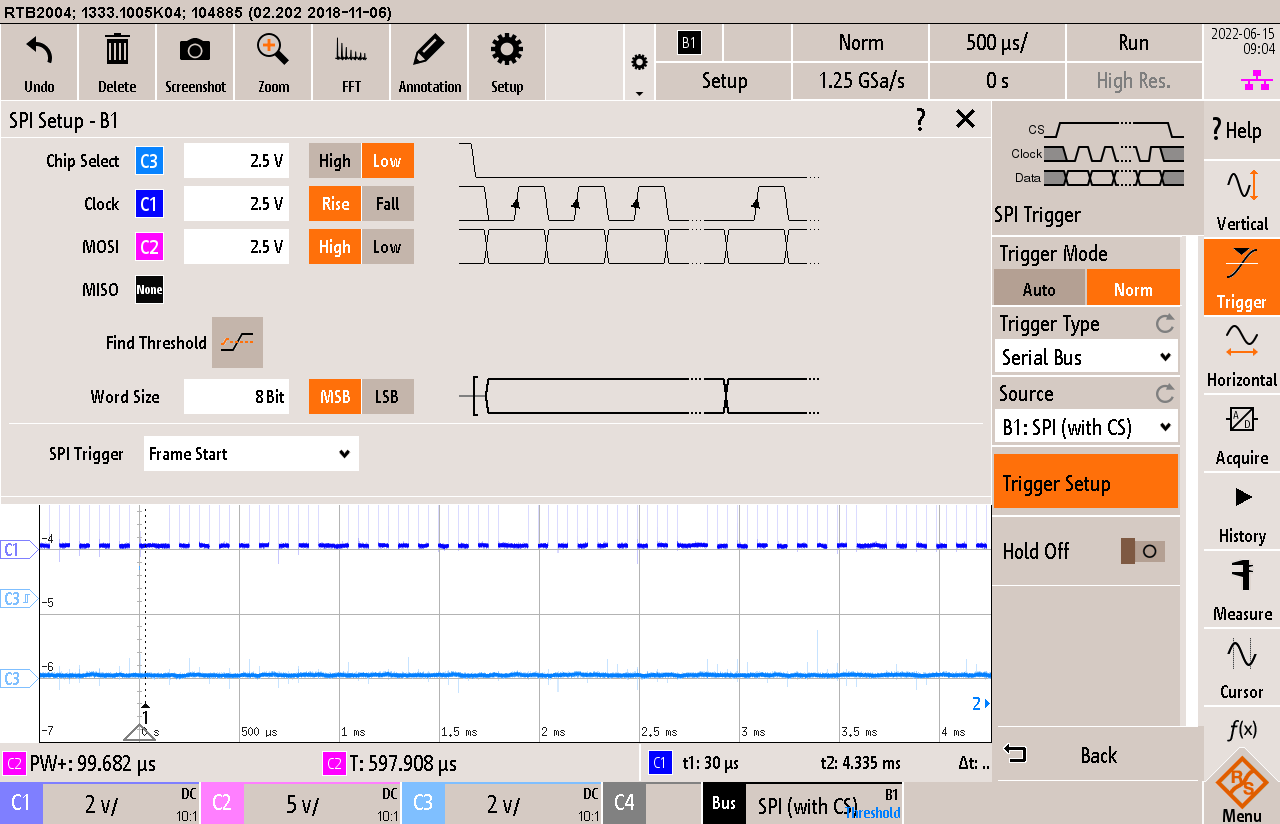
doc/Mesures/SPI/ConfigAnim.png
