ETML-ES-SLO/PRJ_2126_AffichageMatriciel/doc/Mesures/SPI/DebutName.png

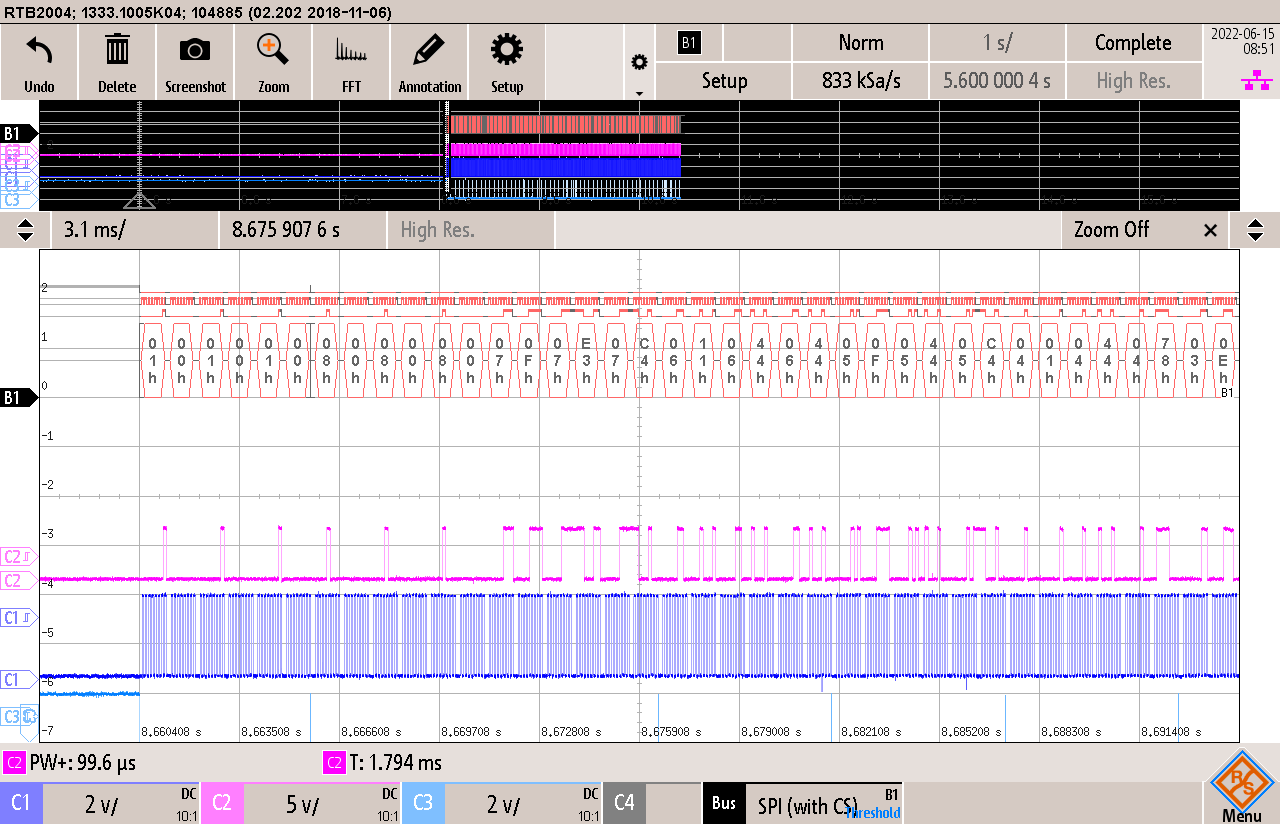
doc/Mesures/SPI/DebutName.png
