ETML-ES-SLO/PRJ_2126_AffichageMatriciel/doc/Mesures/SPI/DisplayLED.png

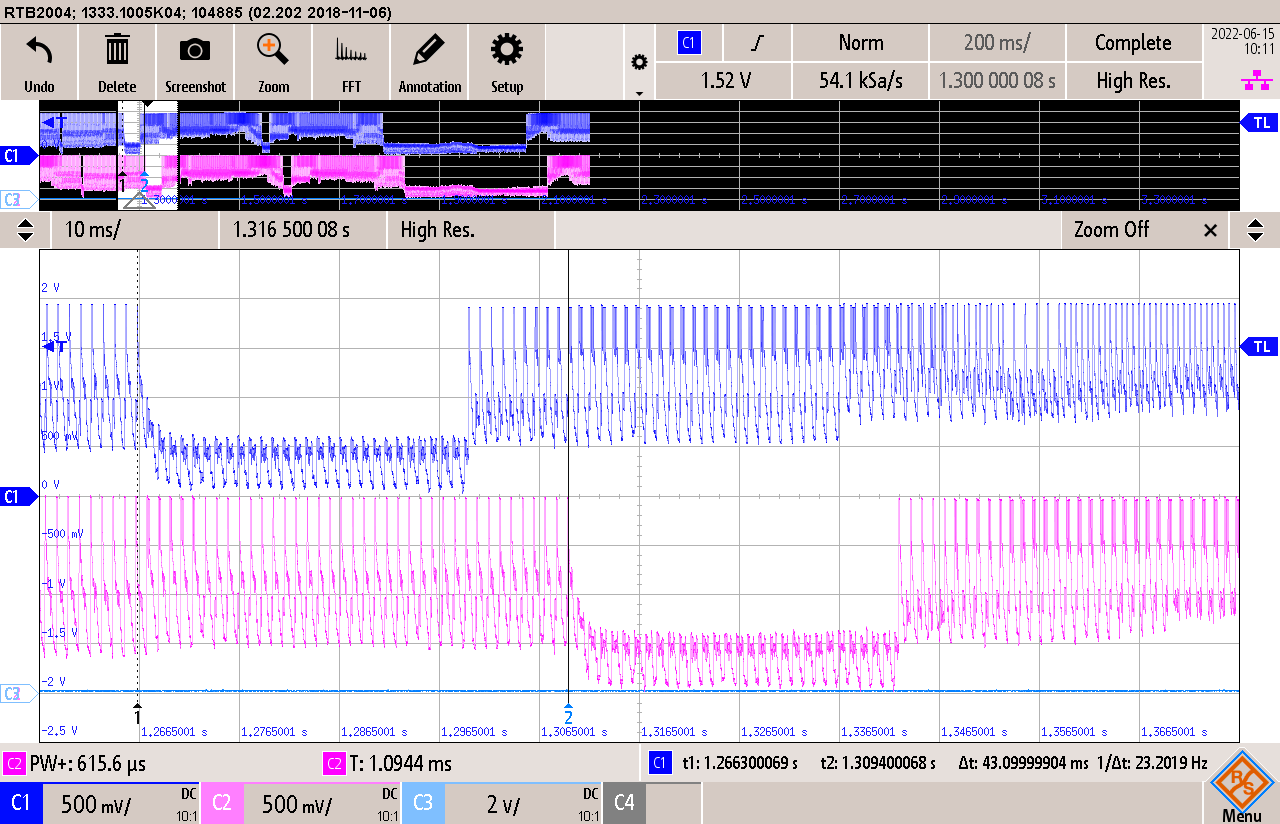
doc/Mesures/SPI/DisplayLED.png
