ETML-ES-SLO/PRJ_2126_AffichageMatriciel/doc/Mesures/SPI/InitMaxSPI.png

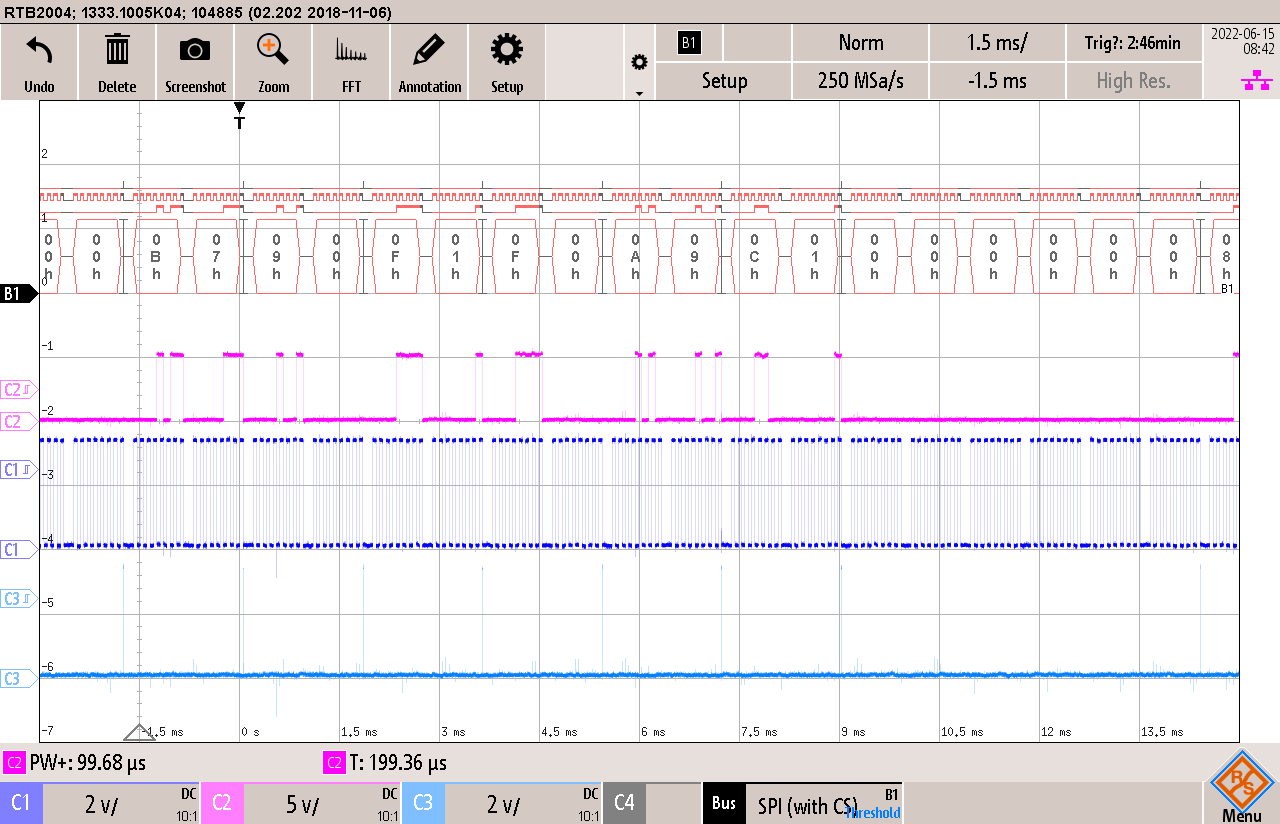
doc/Mesures/SPI/InitMaxSPI.png
