ETML-ES-SLO/PRJ_2126_AffichageMatriciel/doc/Mesures/SPI/KeyRebouclementSPIMatrix.png

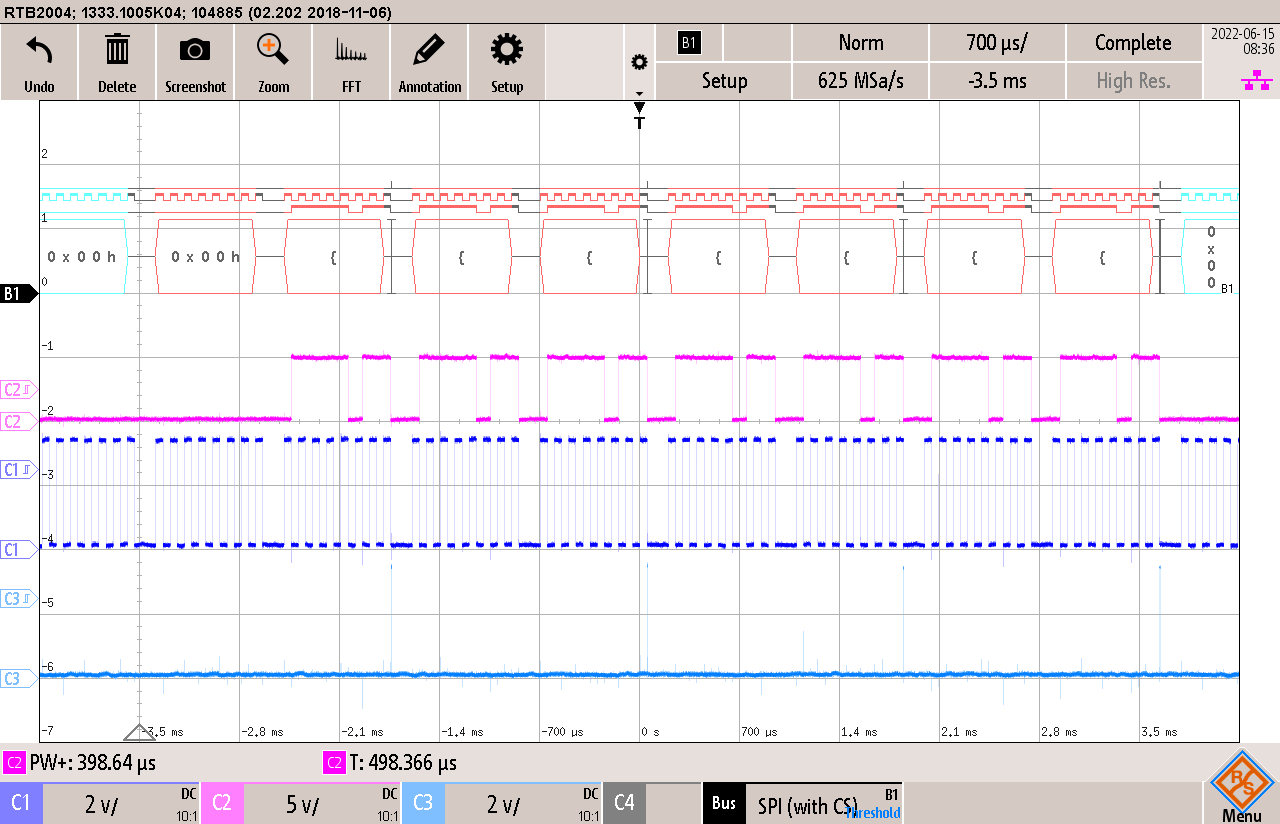
doc/Mesures/SPI/KeyRebouclementSPIMatrix.png
