ETML-ES-SLO/PRJ_2126_AffichageMatriciel/doc/Mesures/SPI/TimeRequestAndDisplayName.png

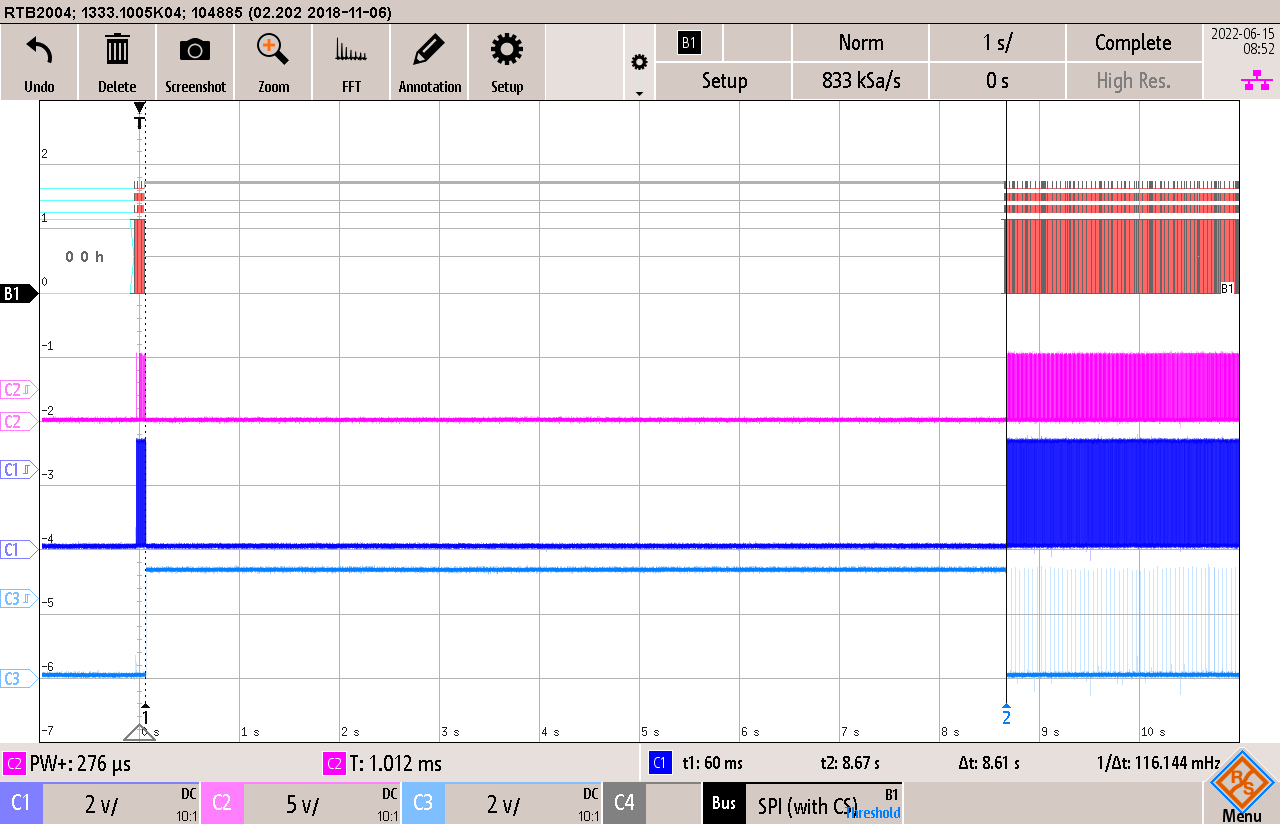
doc/Mesures/SPI/TimeRequestAndDisplayName.png
