ETML-ES-SLO/PRJ_2126_AffichageMatriciel/doc/Mesures/Timer/WhilleSPI.png

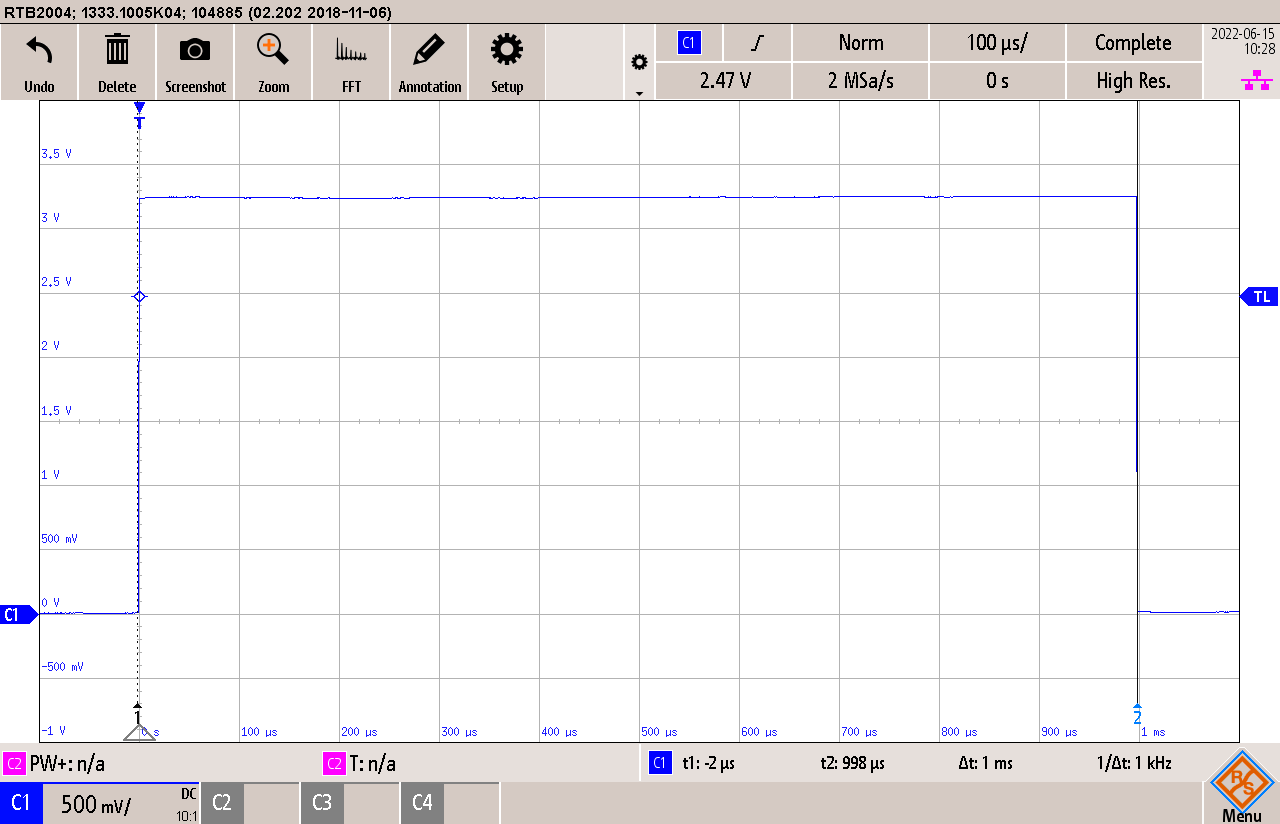
doc/Mesures/Timer/WhilleSPI.png
