ETML-ES-SLO/PRJ_2126_AffichageMatriciel/doc/Mesures/UART/Config1ET2.png

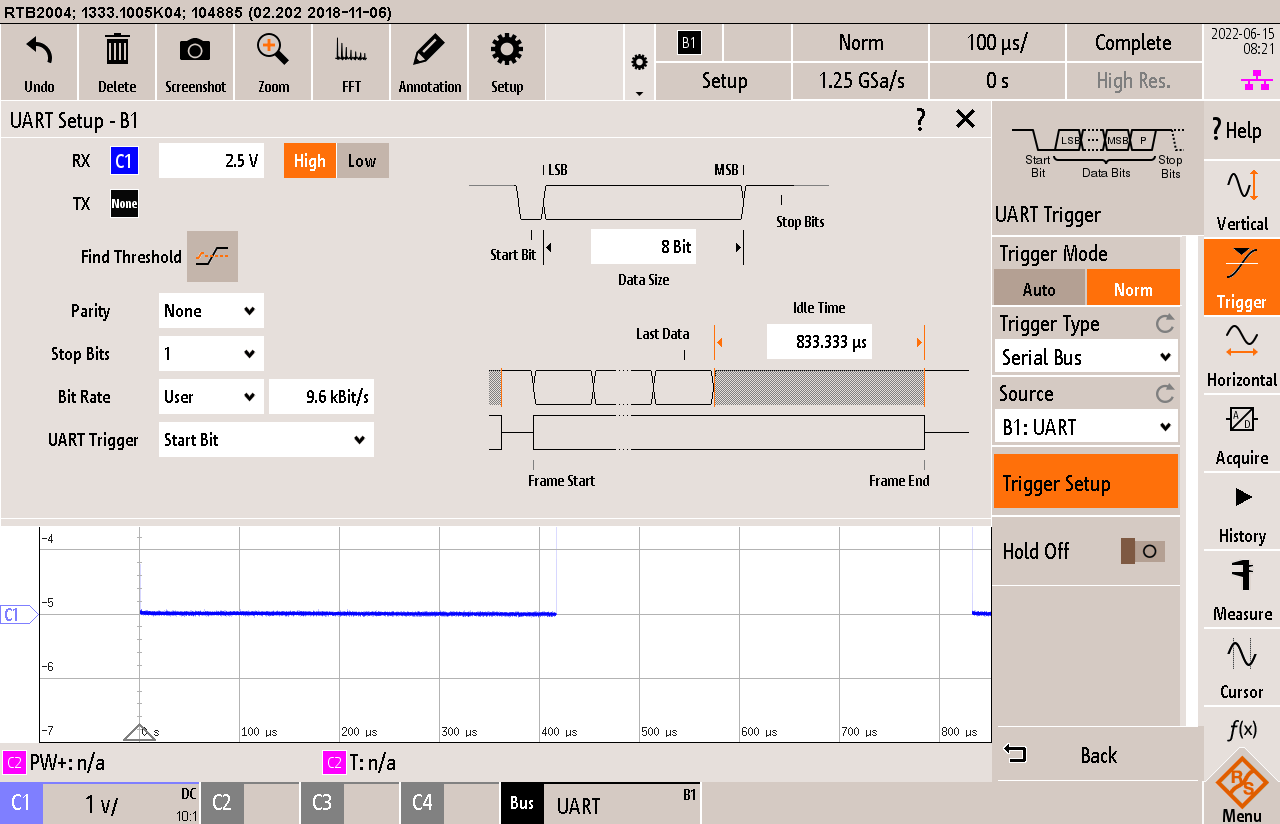
doc/Mesures/UART/Config1ET2.png
