ETML-ES-SLO/PRJ_2126_AffichageMatriciel/doc/Mesures/UART/Config3.png

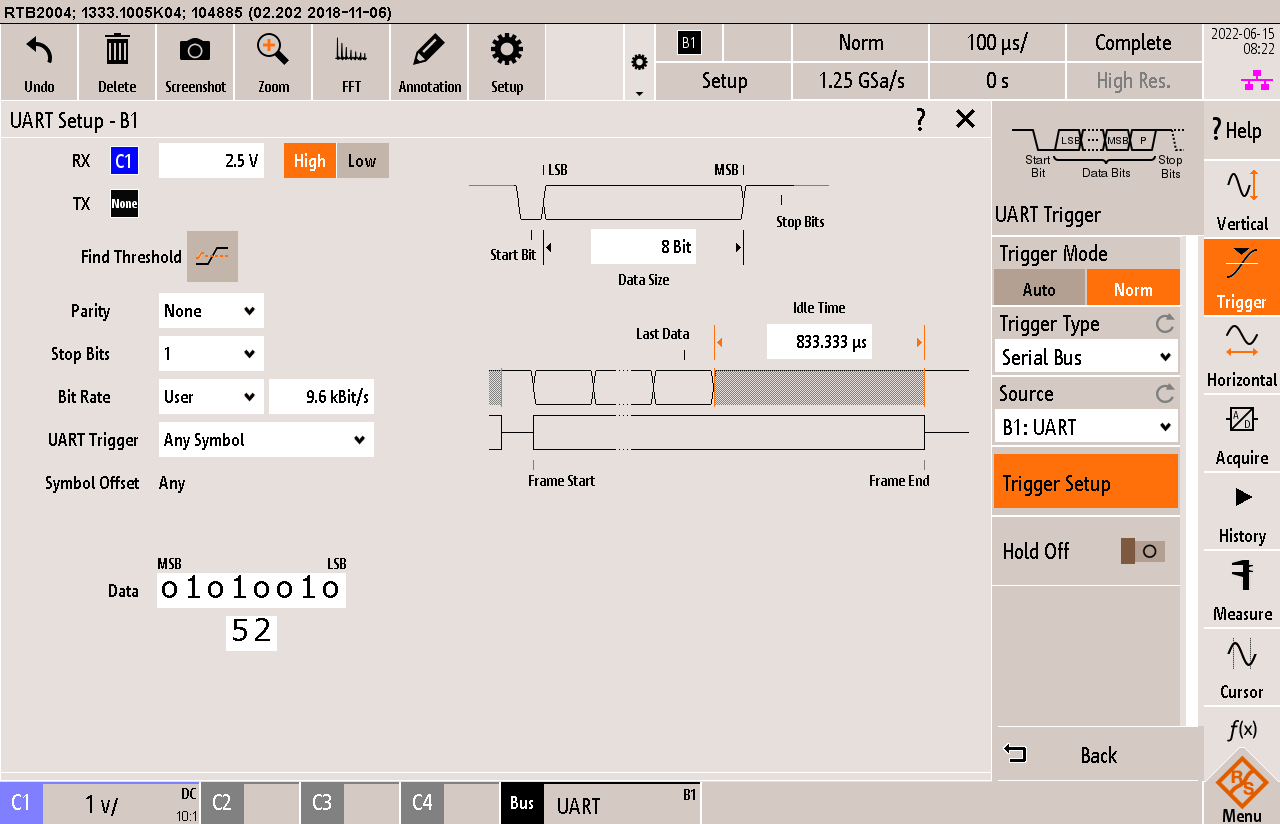
doc/Mesures/UART/Config3.png
