ETML-ES-SLO/PRJ_2126_AffichageMatriciel/doc/Mesures/UART/Cpin7.png

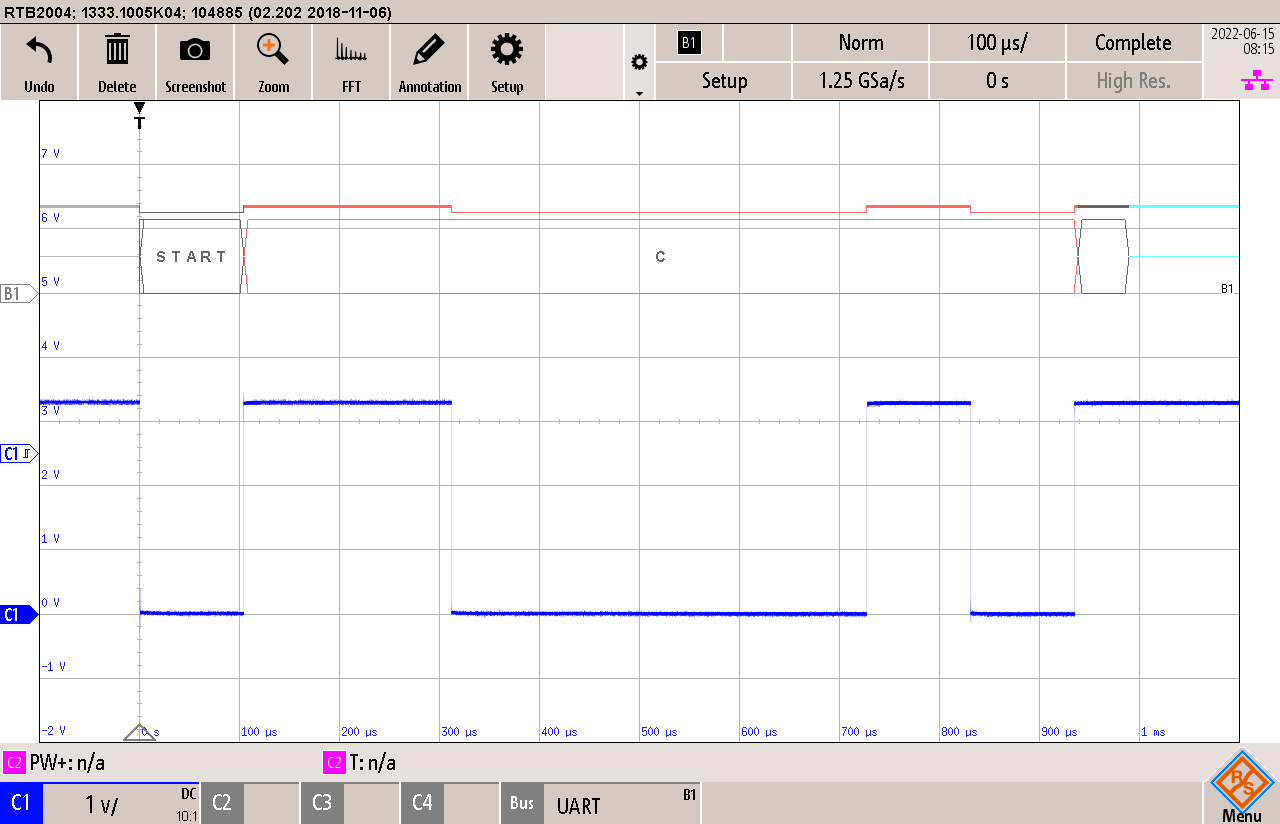
doc/Mesures/UART/Cpin7.png
