ETML-ES-SLO/PRJ_2126_AffichageMatriciel/doc/Mesures/UART/NamePin6.png

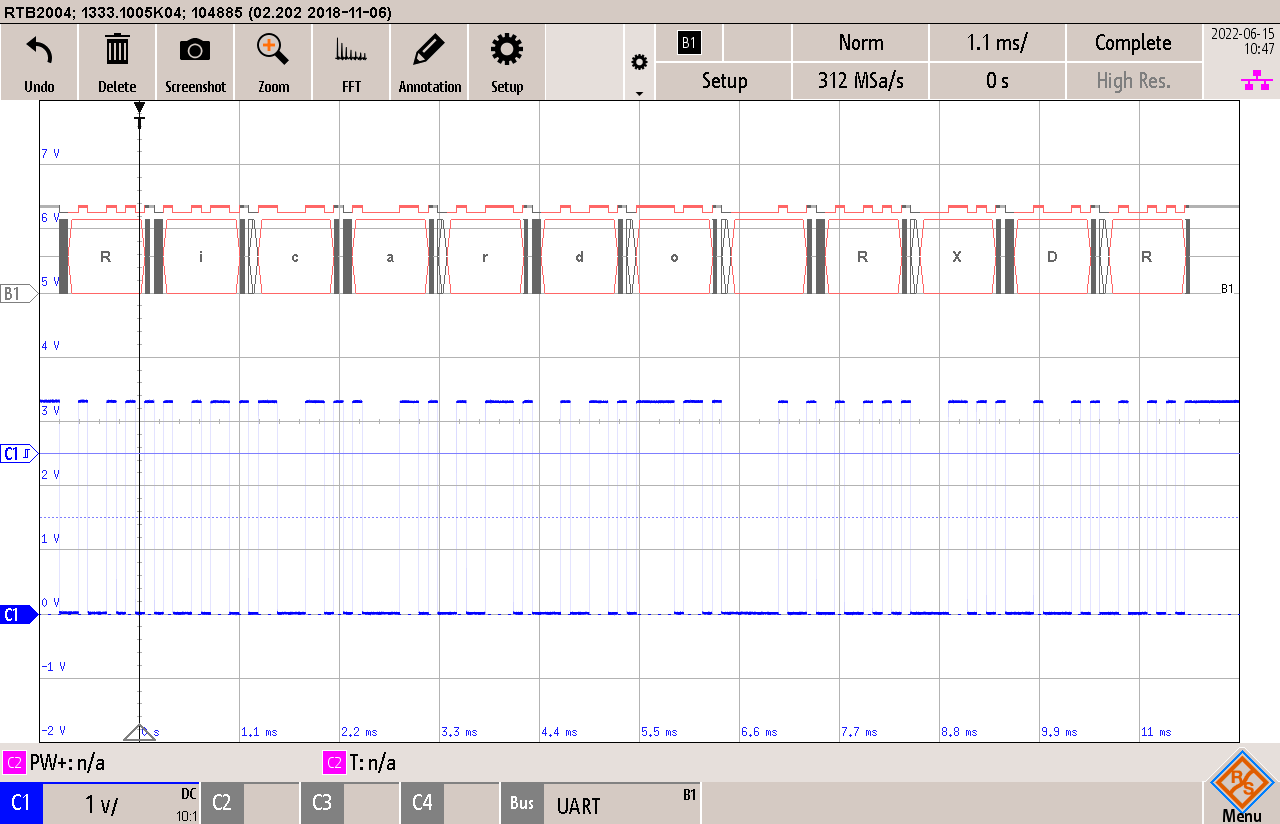
doc/Mesures/UART/NamePin6.png
