ETML-ES-SLO/PRJ_2126_AffichageMatriciel/doc/Mesures/UART/xPin6.png

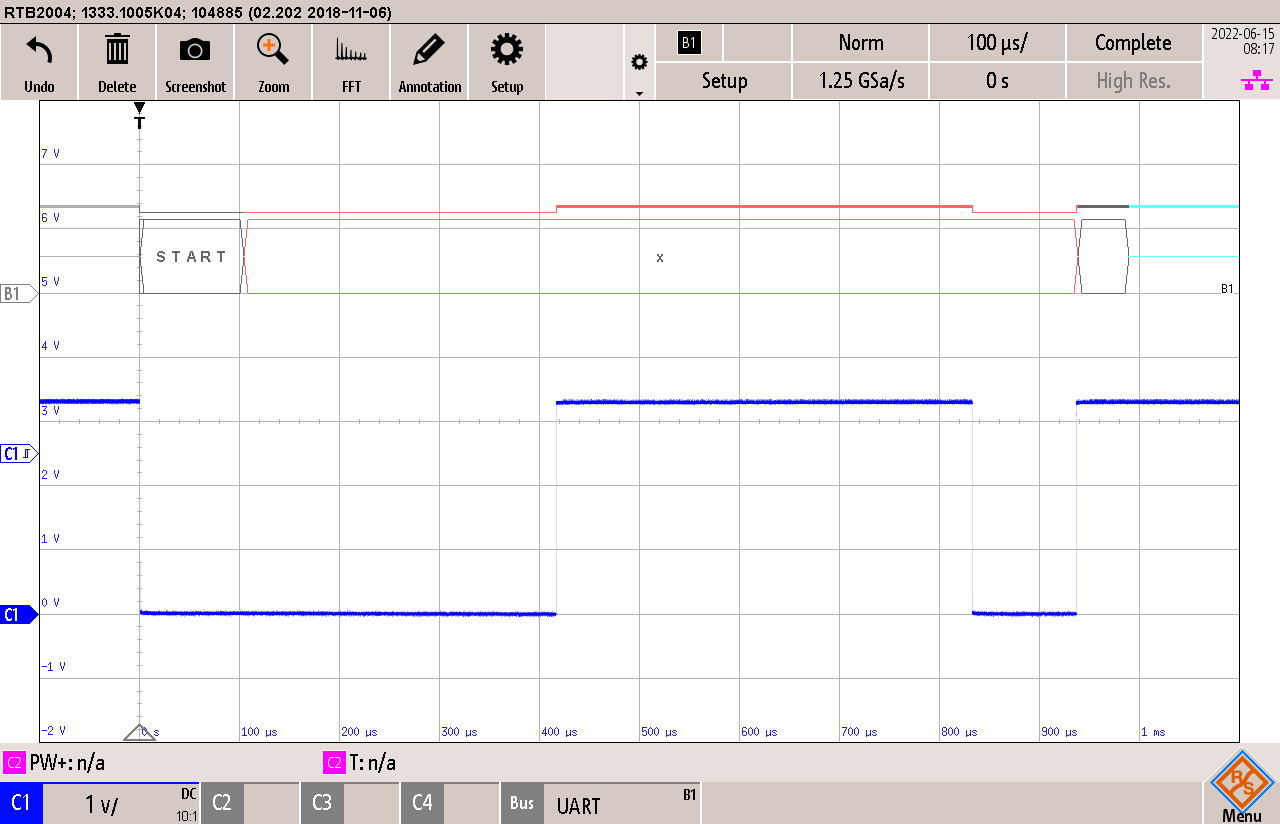
doc/Mesures/UART/xPin6.png
