ETML-ES-SLO/PRJ_2126_AffichageMatriciel/doc/supp/Font.png

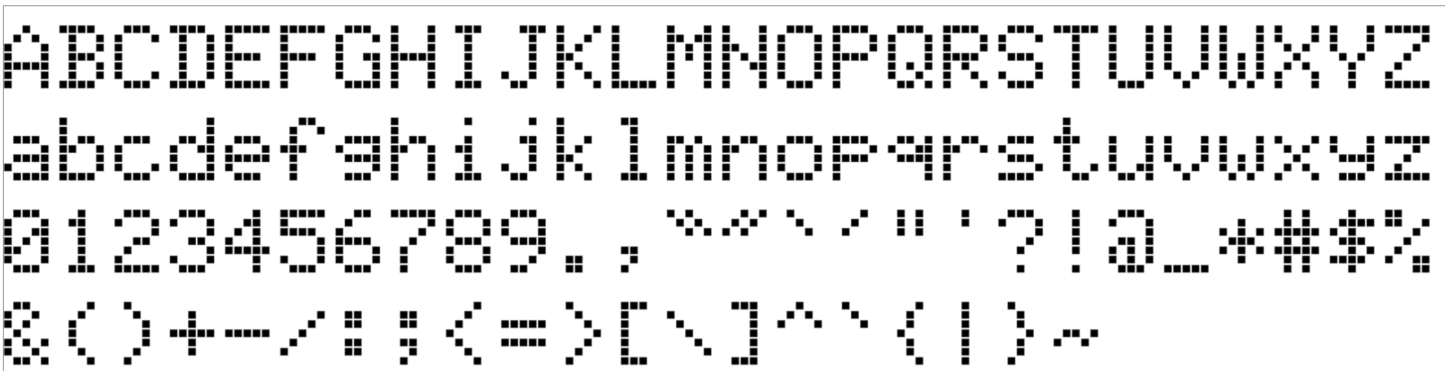
doc/supp/Font.png
