ETML-ES-SLO/PRJ_2126_AffichageMatriciel/doc/supp/Other/AllConfig.png

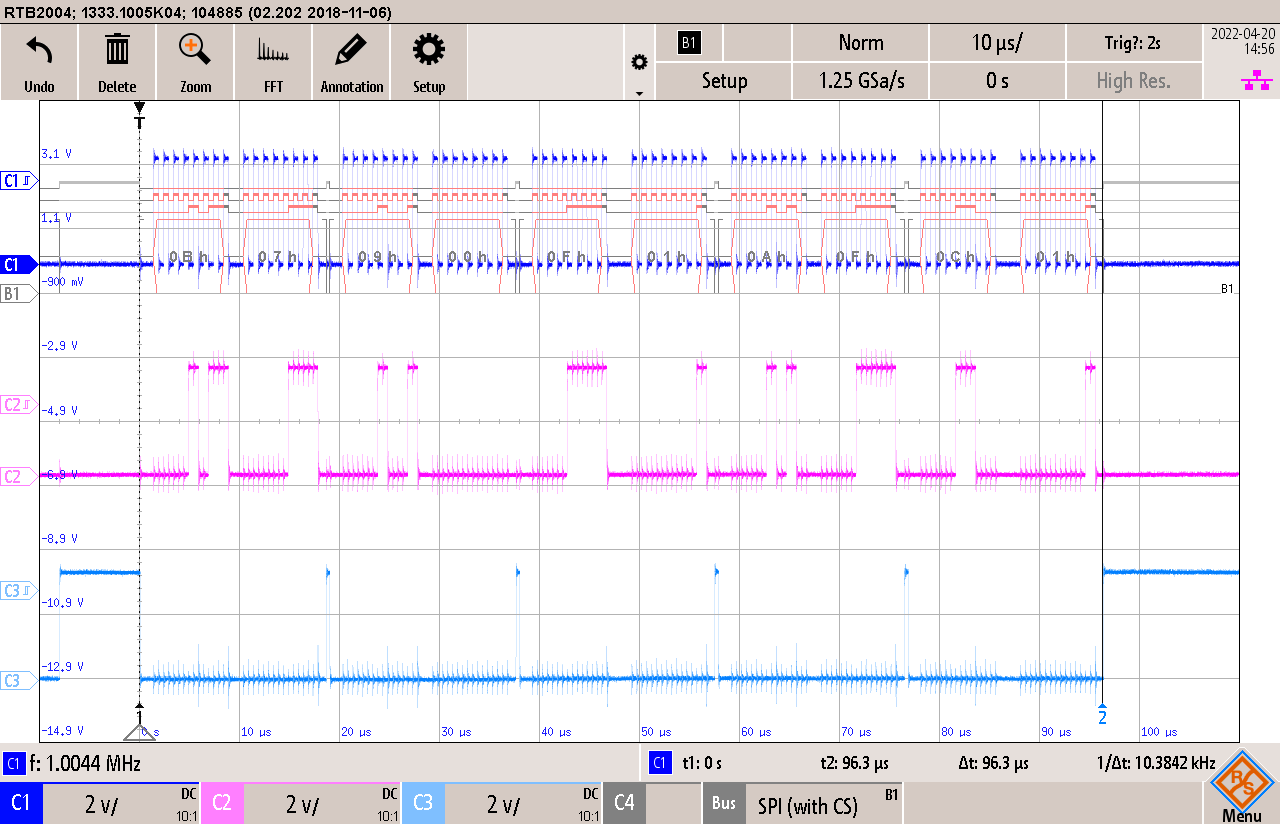
doc/supp/Other/AllConfig.png
