ETML-ES-SLO/PRJ_2126_AffichageMatriciel/doc/supp/Other/BreakBtwTwoChipSelec.png

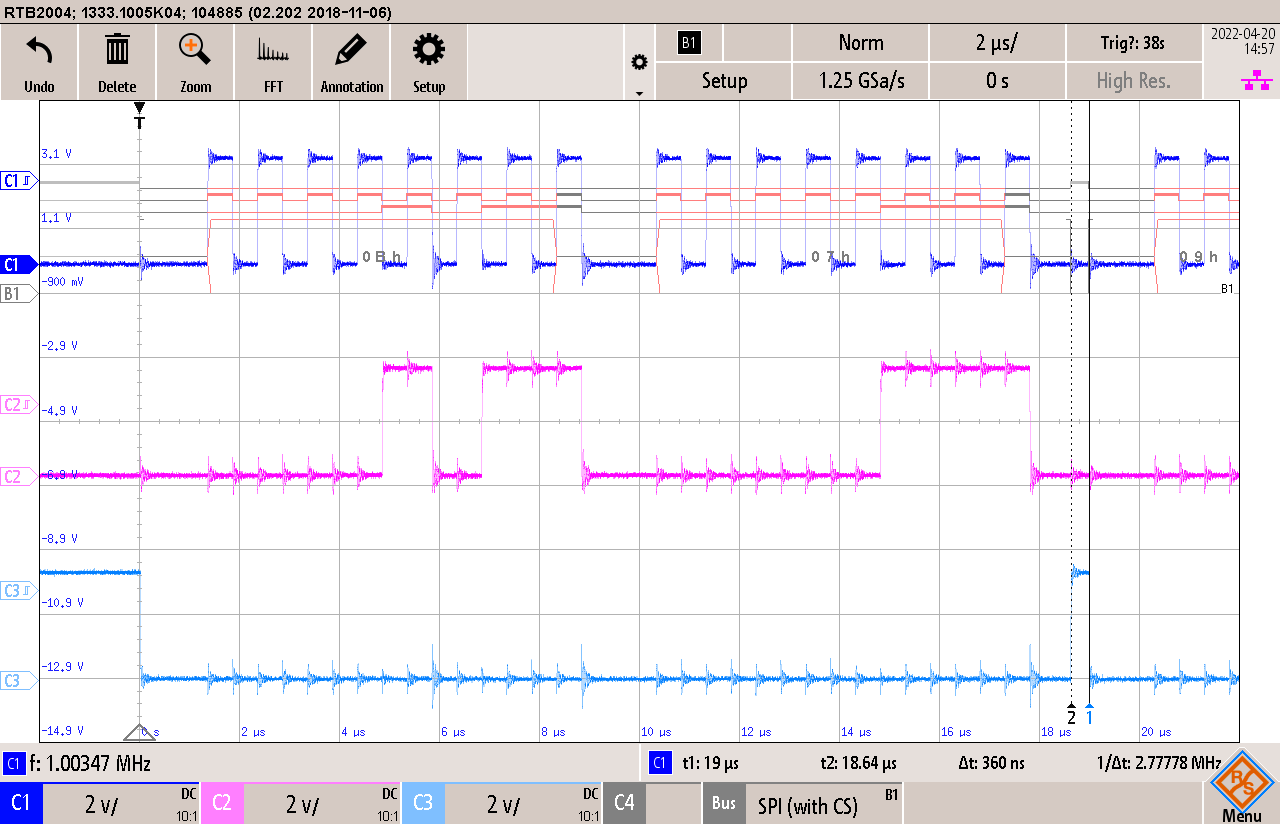
doc/supp/Other/BreakBtwTwoChipSelec.png
