ETML-ES-SLO/PRJ_2126_AffichageMatriciel/doc/supp/Other/FinalyWork.jpg

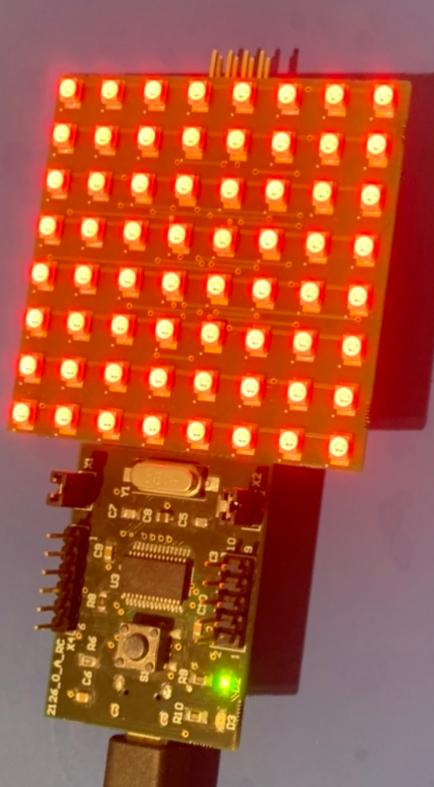
doc/supp/Other/FinalyWork.jpg
