ETML-ES-SLO/PRJ_2126_AffichageMatriciel/doc/supp/Other/OneBit.png

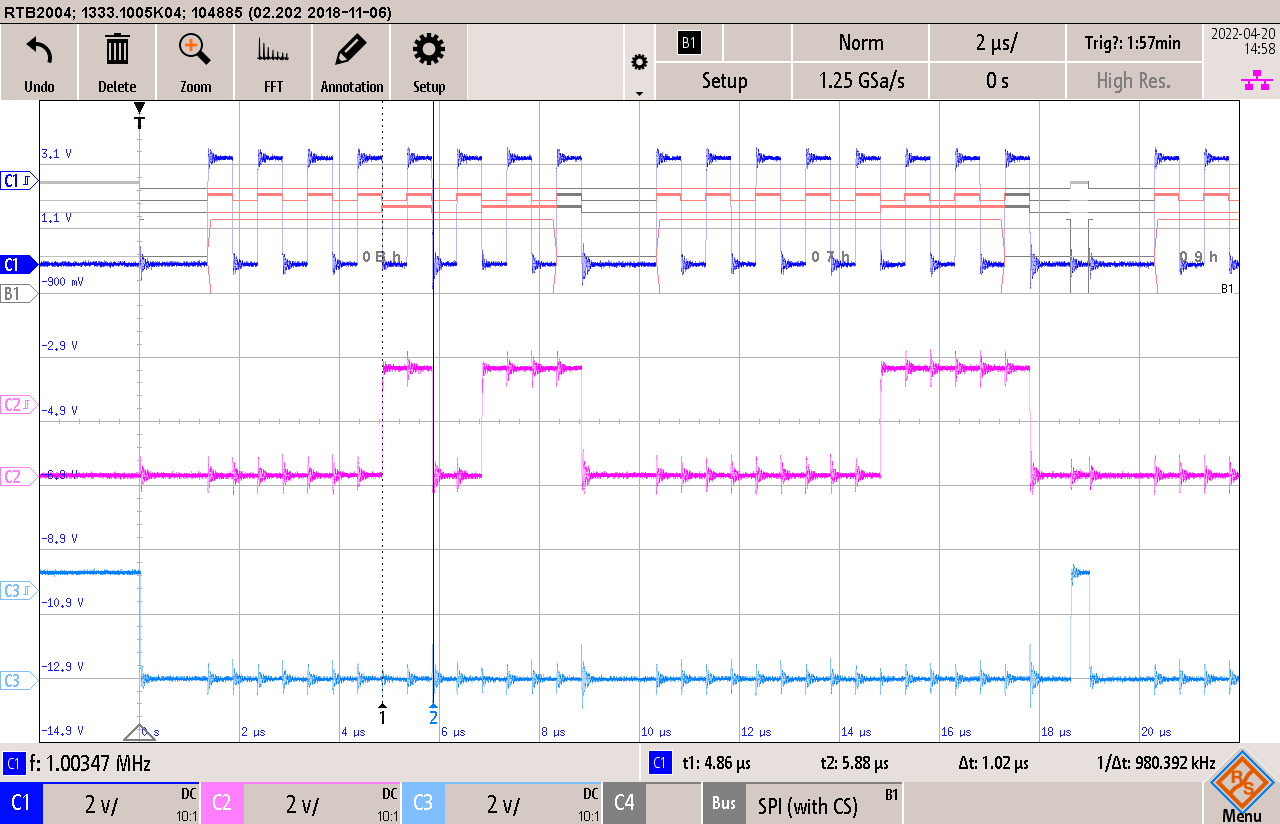
doc/supp/Other/OneBit.png
