ETML-ES-SLO/PRJ_2126_AffichageMatriciel/doc/supp/Other/OneByte.png

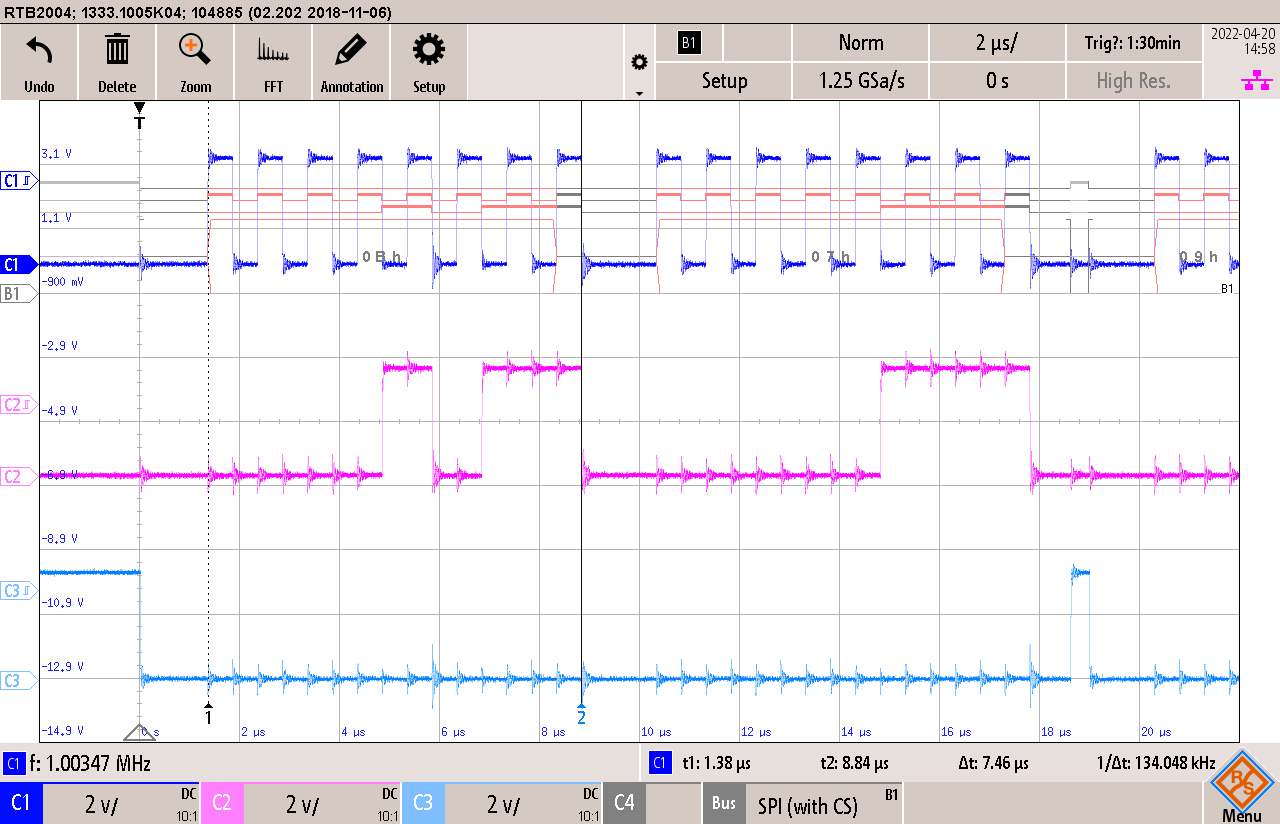
doc/supp/Other/OneByte.png
