ETML-ES-SLO/PRJ_2126_AffichageMatriciel/doc/supp/Other/scrprint.png

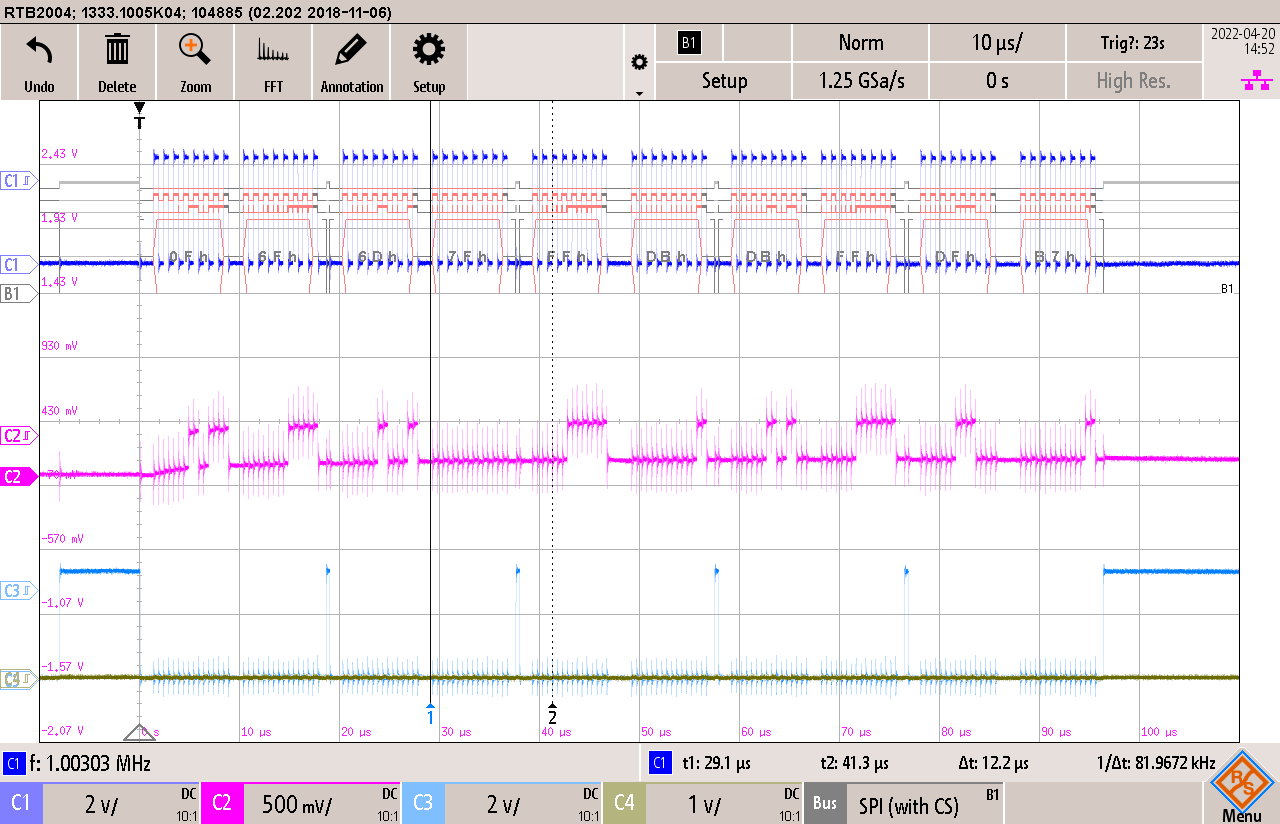
doc/supp/Other/scrprint.png
