ETML-ES-SLO/PRJ_2126_AffichageMatriciel/soft/SW Windows/UserRetrieval_main_v02/src/UserRetrieval/UserRetrieval/Images/Attention.jpg

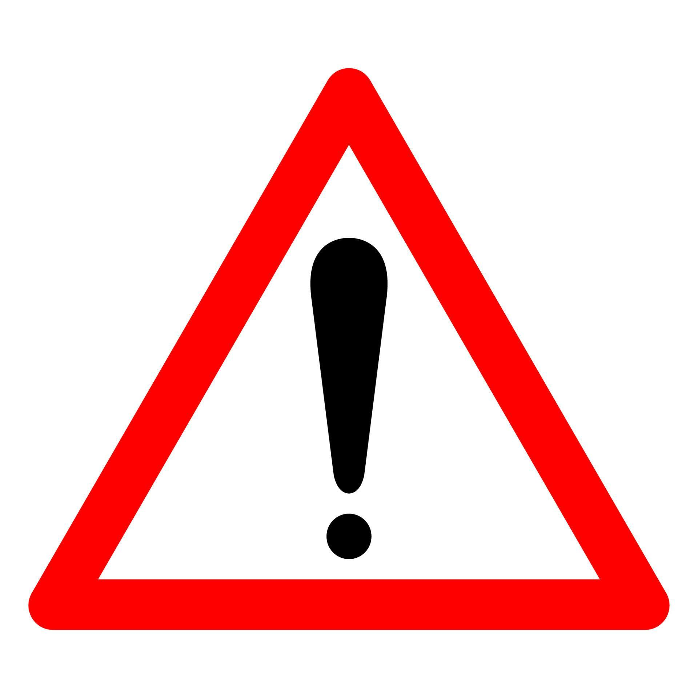
soft/SW Windows/UserRetrieval_main_v02/src/UserRetrieval/UserRetrieval/Images/Attention.jpg
