ETML-ES-SLO/PRJ_2126_AffichageMatriciel/hard/2126_MainBoard_AffichageMatriciel_BOM.xlsx

Sheet: 2126_MainBoard_AffichageMatrici
Quantity | Designator | Comment | Description | Footprint | LibRef | Unit Price | CHF | Price | CHF | URL | Référence
2 | C1, C4 | 6.8uF | VJ0805Y104KNAAT | CAPC2013X145X48NL20T23 | CMP-2007-03167-1 | 0.5 | CHF | 1 | CHF
1 | C2 | 10nF | VJ0805Y104KNAAT | CAPC2013X145X48NL20T23 | CMP-2007-03167-1 | 0.5 | CHF | 0.5 | CHF
1 | C3 | 4.7uF | VJ0805Y104KNAAT | CAPC2013X145X48NL20T23 | CMP-2007-03167-1 | 0.5 | CHF | 0.5 | CHF
1 | C5 | 10uF | VJ0805Y104KNAAT | CAPC2013X145X48NL20T23 | CMP-2007-03167-1 | 0.5 | CHF | 0.5 | CHF
2 | C7, C8 | 22pF/15V | VJ0805Y104KNAAT | CAPC2013X145X48NL20T23 | CMP-2007-03167-1 | 0.5 | CHF | 1 | CHF
4 | C6, C9, C10, C11 | 100nF | VJ0805Y104KNAAT | CAPC2013X145X48NL20T23 | CMP-2007-03167-1 | 0.5 | CHF | 2 | CHF
1 | D1 | BAS40 | Silicon Schottky Diode, -55 to 150 degC, SOT23, Reel, Green | INF-SOT23_N | CMP-1182-00023-1 | 0.223 | CHF | 0.223 | CHF
2 | D2, D3 | GREN 1.9V | WL-TMRC THT Mono-color Round Color, size 3mm, Bright Green, 2.1V, 40deg | LED_0805 | 151031VS04000_G | 0.57 | CHF | 1.14 | CHF | Digikey (https://www.digikey.ch/en/products/detail/bivar-inc/SM0805GCL/3095527?s=N4IgTCBcDaIAQGUCyAGAHCgrAcQMIBkQBdAXyA) | 492-2525-1-ND | Mouser (https://www.mouser.ch/ProductDetail/Bivar/SM0805GCL?qs=jaLxTFIJCitl%252Bw30syUp6A%3D%3D)
2 | FB1, FB2 | 600Ohm, 2A | WE-CBF SMT EMI Suppression Ferrite Bead, size 1206, 600Ohm, 2A | WE-CBF_1206_High Speed | 74279218 | 0.22 | CHF | 0.44 | CHF | Digikey (https://www.digikey.ch/en/products/detail/würth-elektronik/742792118/4310390?s=N4IgTCBcDaIARwOwBYyIJxgIxYBwgF0BfIA) | 732-4653-1-ND | Mouser (https://www.mouser.ch/ProductDetail/Wurth-Elektronik/742792118?qs=Wn16VcyqZWoXSdqZp32%252b5g==)
1 | J1 | micro-USB | WR-COM_USB_Micro Type B_Horizontal_SMT | 629105150521 | 629105150521 | 1.98 | CHF | 1.98 | CHF | Digikey (https://www.digikey.ch/de/products/detail/w-rth-elektronik/629105150521/5047555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) | 629105150521 | Mouser (https://www.mouser.ch/ProductDetail/Wurth-Elektronik/629105150521?qs=a9WhcLg8qCzXiH7kZP8GRQ==)
2 | R1, R6 | 10k | 10K 0.125W 1% 0805 (2012 Metric) SMD | RESC2013X70X40ML20T20 | CMP-1013-00623-1 | 0.5 | CHF | 1 | CHF
1 | R2 | 20k | 10K 0.125W 1% 0805 (2012 Metric) SMD | RESC2013X70X40ML20T20 | CMP-1013-00623-1 | 0.5 | CHF | 0.5 | CHF
2 | R3, R4 | 24R | 10K 0.125W 1% 0805 (2012 Metric) SMD | RESC2013X70X40ML20T20 | CMP-1013-00623-1 | 0.5 | CHF | 1 | CHF
2 | R5, R8 | 1k | 10K 0.125W 1% 0805 (2012 Metric) SMD | RESC2013X70X40ML20T20 | CMP-1013-00623-1 | 0.5 | CHF | 1 | CHF
1 | R7 | 100R | 10K 0.125W 1% 0805 (2012 Metric) SMD | RESC2013X70X40ML20T20 | CMP-1013-00623-1 | 0.5 | CHF | 0.5 | CHF
2 | R9, R10 | 680R | 10K 0.125W 1% 0805 (2012 Metric) SMD | RESC2013X70X40ML20T20 | CMP-1013-00623-1 | 0.5 | CHF | 1 | CHF
1 | S1 | RND 210-00204 |  | PushButton | PushBtn | 0.33 | CHF | 0.33 | CHF
1 | U1 | MAX1793EUE33+ | IC REG LIN POS ADJ 1A 16TSSOP | TSOP65P640X110_HS-17N | MAX1793EUE33+ | 3.75 | CHF | 3.75 | CHF | Digikey (https://www.digikey.ch/fr/products/detail/analog-devices-inc-maxim-integrated/MAX1793EUE33/1513120) | MAX1793EUE33+ | Mouser (https://www.mouser.ch/ProductDetail/Maxim-Integrated/MAX1793EUE33+?qs=1THa7WoU59Fz7xqCd4dBkA==)
1 | U2 | CY7C64225-28PVXC | USB-to-UART Bridge Controller, 3 to 5.25 V, 0 to 70 degC, 28-Pin SSOP (PVX28), Tape and Reel | CYP-PVX28_N | CY7C64225-28PVXC | 5.15 | CHF | 5.15 | CHF | Digikey (https://www.digikey.ch/de/products/detail/cypress-semiconductor-corp/CY7C64225-28PVXC/3507932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) | 428-3158-ND
1 | U3 | PIC32MX130F064B-I/SS | 32-bit Microcontroller with Audio and Graphics Interface, USB and Advanced Analog, 40 MHz, 21 I/O, PMP, -40 to 85 degC, 28-pin SSOP (SS28), Tube | MCHP-SSOP-SS28_N | PIC32MX130F064B-I/SS | 3.02 | CHF | 3.02 | CHF |  |  | Mouser (https://www.mouser.ch/ProductDetail/Microchip-Technology/PIC32MX130F064B-I-SS?qs=hort8UWU32o0X62MWTu1mA%3D%3D)
2 | X1, X2 | Jumper |  | 61300211121 | Jumper | 0.12 | CHF | 0.24 | CHF
1 | X3 | 61301021121 | WR-PHD Pin Header, THT, pitch 2.54mm, Dual Row, Vertical, 10p | 61301021121 | 61301021121 | 1 | CHF | 1 | CHF
1 | X4 | JTAG 61300611121 | WR-PHD Pin Header, THT, pitch 2.54mm, Single Row, Vertical, 6p | 61300611121 | JTAG 61300611121 | 0.3 | CHF | 0.3 | CHF
1 | X5 | 610108249121 | WR-PHD Pin Header, THT, pitch 2.54mm, Dual Row, Angled, 8p | 610108249121 | 610108249121 | 1.62 | CHF | 1.62 | CHF | Digikey (https://www.digikey.ch/de/products/detail/w-rth-elektronik/610108249121/5047533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) | 732-6068-1-ND | Mouser (https://www.mouser.ch/ProductDetail/Wurth-Elektronik/610108249121?qs=a9WhcLg8qCxbQITPUuHU7A==)
1 | Y1 | 8MHZ | Crystal or Oscillator | LFXTAL003151REEL | LFXTAL003151REEL | 0.6 | CHF | 0.6 | CHF | Digikey (https://www.digikey.ch/fr/products/detail/cardinal-components-inc/CSM4Z-A2B3C3-60-8-0D18/3749205) | 370-1165-1-ND
Quantity | Designator | Comment | Description | Footprint | LibRef
1 | C1 | 100nF | VJ0805Y104KNAAT | CAPC2013X145X48NL20T23 | CMP-2007-03167-1 | 0.5 | CHF | 0.5 | CHF
64 | D1, D2, D3, D4, D5, D6, D7, D8, D9, D10, D11, D12, D13, D14, D15, D16, D17, D18, D19, D20, D21, D22, D23, D24, D25, D26, D27, D28, D29, D30, D31, D32, D33, D34, D35, D36, D37, D38, D39, D40, D41, D42, D43, D44, D45, D46, D47, D48, D49, D50, D51, D52, D53, D54, D55, D56, D57, D58, D59, D60, D61, D62, D63, D64 | RED | WL-TMRC THT Mono-color Round Color, size 3mm, Bright Green, 2.1V, 40deg | SODFL350X210-2N | 151031VS04000 | 0.121 | CHF | 7.744 | CHF | Mouser (https://www.mouser.ch/ProductDetail/ams-OSRAM/LS-T67K-K1L2-1-0-2-R18-Z?qs=w%2Fv1CP2dgqoL7AK6LRHrUQ%3D%3D)
1 | R1 | 43k | 10K 0.125W 1% 0805 (2012 Metric) SMD | RESC2013X70X40ML20T20 | CMP-1013-00623-1 | 0.5 | CHF | 0.5 | CHF
1 | U1 | MAX7221CWG+ | IC DRVR 7 SEGMNT 8 DIGIT 24SOIC | FP-W24-1-IPC_B | CMP-05718-000002-1 | 9.91 | CHF | 9.91 | CHF | Digikey (https://www.digikey.ch/fr/products/detail/analog-devices-inc-maxim-integrated/MAX7221CWG-T/5405867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) | MAX7221CWG+T
2 | X1, X2 | M20-7920442R | WR-PHD Socket Header, THT, pitch 2.54mm, Dual Row, Angled, 8p | 610108249221 | 610108249221 | 1.17 | CHF | 2.34 | CHF | Mouser (https://www.mouser.ch/ProductDetail/Harwin/M20-7920442R?qs=k41KVqW3ymousPi4j6j9Sw%3D%3D) | M20-7920442R
2 | X3, X4 | 610108249121 | WR-PHD Pin Header, THT, pitch 2.54mm, Dual Row, Angled, 8p | 610108249121 | 610108249121 | 1.62 | CHF | 3.24 | CHF | Digikey (https://www.digikey.ch/de/products/detail/w-rth-elektronik/610108249121/5047533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) | 610108249121 | Mouser (https://www.mouser.ch/ProductDetail/Wurth-Elektronik/610108249121?qs=a9WhcLg8qCxbQITPUuHU7A==)
 |  |  |  |  |  | All |  | 54.527 | CHF | 37.914 | CHF
 |  |  |  |  |  | Main |  | 30.293 | CHF | 14.68 | CHF
 |  |  |  |  |  | Matrix |  | 24.234 | CHF | 23.234 | CHF

Sheet: Feuil1
Quantity | Designator | Comment | Description | Footprint | LibRef | Unit Price | CHF | Price | CHF
2 | C1, C4 | 6.8uF | VJ0805Y104KNAAT | CAPC2013X145X48NL20T23 | CMP-2007-03167-1 | 0.5 | CHF | 1 | CHF
1 | C2 | 10nF | VJ0805Y104KNAAT | CAPC2013X145X48NL20T23 | CMP-2007-03167-1 | 0.5 | CHF | 0.5 | CHF
1 | C3 | 100pF | VJ0805Y104KNAAT | CAPC2013X145X48NL20T23 | CMP-2007-03167-1 | 0.5 | CHF | 0.5 | CHF
1 | C5 | 10uF | VJ0805Y104KNAAT | CAPC2013X145X48NL20T23 | CMP-2007-03167-1 | 0.5 | CHF | 0.5 | CHF
1 | C6 | 100nF | VJ0805Y104KNAAT | CAPC2013X145X48NL20T23 | CMP-2007-03167-1 | 0.5 | CHF | 0.5 | CHF
2 | C7, C8 | 22pF/15V | VJ0805Y104KNAAT | CAPC2013X145X48NL20T23 | CMP-2007-03167-1 | 0.5 | CHF | 1 | CHF
3 | C9, C10, C11 | 100n | VJ0805Y104KNAAT | CAPC2013X145X48NL20T23 | CMP-2007-03167-1 | 0.5 | CHF | 1.5 | CHF
1 | D1 | BAS40 | Silicon Schottky Diode, -55 to 150 degC, SOT23, Reel, Green | INF-SOT23_N | CMP-1182-00023-1 | 0.223 | CHF | 0.223 | CHF
2 | R1, R6 | 10k | 10K 0.125W 1% 0805 (2012 Metric) SMD | RESC2013X70X40ML20T20 | CMP-1013-00623-1 | 0.5 | CHF | 1 | CHF
1 | R2 | 20k | 10K 0.125W 1% 0805 (2012 Metric) SMD | RESC2013X70X40ML20T20 | CMP-1013-00623-1 | 0.5 | CHF | 0.5 | CHF
2 | R3, R4 | 24R | 10K 0.125W 1% 0805 (2012 Metric) SMD | RESC2013X70X40ML20T20 | CMP-1013-00623-1 | 0.5 | CHF | 1 | CHF
2 | R5, R8 | 1k | 10K 0.125W 1% 0805 (2012 Metric) SMD | RESC2013X70X40ML20T20 | CMP-1013-00623-1 | 0.5 | CHF | 1 | CHF
1 | R7 | 100R | 10K 0.125W 1% 0805 (2012 Metric) SMD | RESC2013X70X40ML20T20 | CMP-1013-00623-1 | 0.5 | CHF | 0.5 | CHF
2 | R9, R10 | 680R | 10K 0.125W 1% 0805 (2012 Metric) SMD | RESC2013X70X40ML20T20 | CMP-1013-00623-1 | 0.5 | CHF | 1 | CHF
1 | S1 | RND 210-00204 |  | PushButton | PushBtn | 0.33 | CHF | 0.33 | CHF
1 | U3 | PIC32MX130F064B-I/SS | 32-bit Microcontroller with Audio and Graphics Interface, USB and Advanced Analog, 40 MHz, 21 I/O, PMP, -40 to 85 degC, 28-pin SSOP (SS28), Tube | MCHP-SSOP-SS28_N | PIC32MX130F064B-I/SS | 3.02 | CHF | 3.02 | CHF
2 | X1, X2 | Jumper |  | 61300211121 | Jumper | 0.12 | CHF | 0.24 | CHF
1 | X3 | 61301021121 | WR-PHD Pin Header, THT, pitch 2.54mm, Dual Row, Vertical, 10p | 61301021121 | 61301021121 | 1 | CHF | 1 | CHF
1 | X4 | JTAG 61300611121 | WR-PHD Pin Header, THT, pitch 2.54mm, Single Row, Vertical, 6p | 61300611121 | JTAG 61300611121 | 0.3 | CHF | 0.3 | CHF
1 | C1 | 100n | VJ0805Y104KNAAT | CAPC2013X145X48NL20T23 | CMP-2007-03167-1 | 0.5 | CHF | 0.5 | CHF
1 | R1 | 43k | 10K 0.125W 1% 0805 (2012 Metric) SMD | RESC2013X70X40ML20T20 | CMP-1013-00623-1 | 0.5 | CHF | 0.5 | CHF
