ETML-ES-SLO/PRJ_2126_AffichageMatriciel/doc/Rapports/EXCEL/ListeMateriel.xlsx

 | Quantité | Description | Supplier | Price unit | CHF | Price | CHF | Conso | mA | Pulse | mA | Conso TOT | mA | Conso MAX | mA
 |  | OEM 16x16 Matrix R/G 60x60mm | Digitech (http://https/www.digitec.ch/fr/s1/product/oem-16x16-matrix-rotgruen-60x60mm-composants-electroniques-actifs-5998264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) | 16.9 | CHF | 0 | CHF |  | mA |  | mA |  | mA |  | mA
 |  | OEM 16x16 Matrix R/G 60x60mm (https://www.play-zone.ch/en/fileuploader/download/download/?d=1&file=custom%2Fupload%2FFile-1418926863.pdf) | Play-Zone (https://www.play-zone.ch/en/bauteile/led/segmente-matrix/16x16-matrix-rot-grun-60x60mm.html) | 14.9 | CHF | 0 | CHF | 20 | mA | 80 | mA | 0 | mA | 0 | mA | 4
 |  | MATRICE 8X8 LED ROUGE 20mm (https://cdn-shop.adafruit.com/datasheets/454datasheet.pdf) | semageek (https://boutique.semageek.com/fr/1080-matrice-8x8-led-rouge-20mm-3001881009479.html) | 3.95 | CHF | 0 | CHF | 20 | mA |  | mA | 0 | mA | 0 | mA | 8
 |  | RGB 8x8-LED Matrix 6cm * 6cm, Common Anode (https://www.play-zone.ch/en/fileuploader/download/download/?d=1&file=custom%2Fupload%2FFile-1369481639.pdf) | Play-Zone (https://www.play-zone.ch/en/bauteile/led/segmente-matrix/rgb-8x8-led-matrix-6cm-6cm-common-anode.html) | 20.9 | CHF | 0 | CHF | 20 | mA |  | mA | 0 | mA | 0 | mA
 |  |  |  |  | CHF | 0 | CHF
 |  |  |  |  | CHF | 0 | CHF
 |  | 64x32 RGB LED Matrix - 4mm pitch (https://cdn-shop.adafruit.com/product-files/2278/MI-T21P4RGBE-ADP4.pdf) | adafruit (https://www.adafruit.com/product/2278) | 39.95 | CHF | 0 | CHF
 |  | 64x32 RGB LED Matrix - 3mm pitch (https://cdn-shop.adafruit.com/product-files/2279/MI-T21P3RGBE-AB+p3.pdf) | adafruit (https://www.adafruit.com/product/2279) | 44.95 | CHF | 0 | CHF
 |  |  |  |  | CHF | 0 | CHF
 |  |  |  |  | CHF | 0 | CHF
 |  | Matrice flxible RGB 16x16 au métre (min 5m) (https://french.alibaba.com/product-detail/ws2812-panel-16-16-256-pixel-led-matrix-display-5v-5050-full-color-p10-flexible-led-matrix-display-panel-60626918626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) |  | 18 | CHF | 0 | CHF |  |  |  |  |  |  |  |  |  | 5
 |  |  |  | 24 | CHF | 0 | CHF |  |  |  |  |  |  |  |  |  | 5
 |  |  |  |  | CHF | 0 | CHF
 |  | OEM 5mm 8x8 3mm rgb LED Matrix 60*60mm Common Anode (https://www.alibaba.com/product-detail/OEM-ODM-5mm-8x8-3mm-rgb_62172525813.html) | Alibaba (https://www.alibaba.com/product-detail/OEM-ODM-5mm-8x8-3mm-rgb_62172525813.html) | 1.81 | CHF | 0 | CHF | 20 | mA |  | mA | 0 | mA | 0 | mA |  | 5
 |  |  |  |  | CHF | 0 | CHF | 20 | mA |  | mA | 0 | mA | 0 | mA |  | 64
 |  |  |  |  | CHF | 0 | CHF
 |  | LED 5mm, 3mm ecart, 8x8, 60x60mm RGB, Common Annode (https://www.electrokit.com/uploads/productfile/41016/2088RGB-5.pdf) | AliExpress (https://www.aliexpress.com/item/32978579374.html?pdp_ext_f=%7B%22sku_id%22%3A%2266726446085%22%7D) | 1.32 | CHF | 0 | CHF |  |  |  |  |  |  |  |  |  | 144
 |  |  |  |  | CHF | 0 | CHF
 |  | 1.6X1.6MM LC RGB FULL COLOR SMD | XZCMEDGCBD110W (https://www.digikey.ch/fr/products/detail/sunled/XZCMEDGCBD110W/10449780) |  | CHF | 0 | CHF
 |  |  |  |  | CHF | 0 | CHF
 |  |  |  |  | CHF | 0 | CHF
 |  | PIC32MX795F512H (https://ww1.microchip.com/downloads/en/DeviceDoc/PIC32MX5XX6XX7XX_Family)Datasheet_DS60001156K.pdf) | DigiKey (https://www.digikey.ch/en/products/detail/microchip-technology/PIC32MX795F512H-80V-PT/2712419) | 11.44 | CHF | 0 | CHF
 |  |  |  |  | CHF | 0 | CHF
 |  |  |  |  | CHF | 0 | CHF |  |  |  |  |  |  |  |  |  | 432
 |  | LED RED DIFFUSED 5MM T/H (https://www.vishay.com/docs/83030/tllg540.pdf) | DigiKey (https://www.digikey.ch/fr/products/detail/vishay-semiconductor-opto-division/TLLR5401/4074719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) | 0.10323 | CHF | 0 | CHF |  |  |  |  |  |  |  |  |  | 9300
 |  |  |  |  | CHF | 0 | CHF |  |  |  |  |  |  |  |  |  | 10000
 |  | Mux 24bit (https://www.mouser.ch/ProductDetail/NXP-Semiconductors/PCA9957HNMP?qs=Cb2nCFKsA8p1S9uEv3UAJg==) | Mouser (https://www.mouser.ch/ProductDetail/NXP-Semiconductors/PCA9957HNMP?qs=Cb2nCFKsA8p1S9uEv3UAJg==) | 2.19 | CHF | 0 | CHF |  |  |  |  |  |  |  |  |  | 8
 |  | Multiplexeur 16 chanels IC LED DRIVER LINEAR 45MA 24SSOP (https://www.ti.com/product/TLC59284?keyMatch=TLC59284DBQ&tisearch=search-everything&usecase=OPN) | DigiKey (https://www.digikey.ch/fr/products/detail/texas-instruments/TLC59284DBQ/3902366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) |  | CHF | 0 | CHF |  |  |  |  |  |  |  |  |  | 8
 |  |  |  |  | CHF | 0 | CHF
 |  |  |  |  | CHF | 0 | CHF
 |  | PIC32MX130F064B (http://ww1.microchip.com/downloads/en/DeviceDoc/PIC32MX1XX2XX-28-36-44-PIN-DS60001168K.pdf) | DigiKey (https://www.digikey.ch/fr/products/detail/microchip-technology/PIC32MX795F512H-80I-PT/2184448) | 10.88 | CHF | 0 | CHF
 |  | MAX1793 (https://www.maximintegrated.com/en/products/power/linear-regulators/MAX1793.html) | DigiKey (https://www.digikey.ch/fr/products/detail/analog-devices-inc-maxim-integrated/MAX1793EUE33/1513120) | 3.75 | CHF | 0 | CHF
 |  | MAX7221 Serially Interfaced, 8-Digit LED Display Drivers (https://www.maximintegrated.com/en/products/power/display-power-control/MAX7219.html) | Aliexpress (https://fr.aliexpress.com/item/4001241785987.html) | 0.67 | CHF | 0 | CHF
 |  | Quartz CSM4Z-A2B3C3-60-8.0D18 8MHz (https://www.cardinalxtal.com/uploads/files/csm4-csm5.pdf) | DigiKey (https://www.digikey.ch/fr/products/detail/cardinal-components-inc/CSM4Z-A2B3C3-60-8-0D18/3749205) | 0.93 | CHF | 0 | CHF | Footprint (https://www.mouser.ch/ProductDetail/IQD/LFXTAL003151Reel?qs=e4%2FAndAAwgKt40cosvhepA%3D%3D)
 |  | LED RED DIFFUSED 5MM T/H (https://www.vishay.com/docs/83030/tllg540.pdf) | DigiKey (https://www.digikey.ch/fr/products/detail/vishay-semiconductor-opto-division/TLLR5401/4074719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) | 0.23 | CHF | 0 | CHF | Footprint (https://uk.rs-online.com/web/p/leds/8187616)
 |  | LED GREEN DIFFUSED 5MM T/H (https://www.vishay.com/docs/83030/tllg540.pdf) | DigiKey (https://www.digikey.ch/fr/products/detail/vishay-semiconductor-opto-division/TLLG5401/4074714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) | 0.23 | CHF | 0 | CHF | Footprint (https://uk.rs-online.com/web/p/leds/8187616)
 |  | UST to UART CY7C64225-28PVXCT (https://www.infineon.com/dgdl/Infineon-CY7C64225_USB-to-UART_Bridge_Controller-DataSheet-v08_00-EN.pdf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) | Farnell (https://ch.farnell.com/cypress-semiconductor/cy7c64225-28pvxct/controleur-de-pont-usb-uart-0/dp/3259944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) | 4.51 | CHF | 0 | CHF
 |  | JTAG WE 6pin 61300611121 Male (https://www.we-online.com/catalog/en/PHD_2_54_THT_PIN_HEADER_6130XX11121) | DigiKey (https://www.digikey.ch/de/products/detail/w-rth-elektronik/61300611121/4846833?WT.z_cid=ref_oemstrade_standard) | 0.31 | CHF | 0 | CHF
 |  | Connector 6pin 2 row WE 61300621021 Male (https://www.we-online.com/catalog/en/PHD_2_54_THT_ANGLED_DUAL_PIN_HEADER_6130XX21021) | DigiKey (https://www.digikey.ch/de/products/detail/w-rth-elektronik/61300621021/4846834?WT.z_cid=ref_oemstrade_standard) | 0.67 | CHF | 0 | CHF |  |  |  |  |  |  |  |  | TOPLED OSRAM (https://www.osram.com/appsn/ProductSelector/?lang=en&query=TOPLED%20&page=1)
 |  | Connector 6pin 2 row WE 61300621021 Femal (https://www.we-online.com/catalog/en/PHD_2_54_ANGLED_DUAL_SOCKET_HEADER_6130XX243121) | RS comp (https://ch.rs-online.com/web/p/leiterplatten-buchsen/2053219?cm_mmc=aff-_-ch-_-oemstrade-_-2053219) | 0.761 | CHF | 0 | CHF
 |  | Connector 10pin 2 row WE 61301021121 Male | RD comp (https://ch.rs-online.com/web/p/leiterplatten-header/7636754?cm_mmc=aff-_-ch-_-oemstrade-_-7636754) | 0.99 | CHF | 0 | CHF
 |  | Connector 8pin 2row WE 610108249121 Male (https://www.we-online.com/catalog/datasheet/610108249121.pdf) | Mouser (https://eu.mouser.com/ProductDetail/Wurth-Elektronik/610108249121?qs=a9WhcLg8qCxbQITPUuHU7A==)
 |  | Connector 8pin 2row WE 610108249221 Femal (https://www.we-online.com/catalog/datasheet/610108249221.pdf) | Mouser (https://eu.mouser.com/ProductDetail/Wurth-Elektronik/610108249221?qs=a9WhcLg8qCz15Pj3mmPd4A==)
 |  | Connector 8pin 2row WE 610108249221 Femal (https://www.harwin.com/products/M20-7920442R/) | Mouser (https://www.mouser.ch/ProductDetail/Harwin/M20-7920442R?qs=k41KVqW3ymousPi4j6j9Sw%3D%3D) | 1.17 | CHF
 |  | Jumper 2p | DigiKey (https://www.digikey.ch/en/products/detail/sullins-connector-solutions/QPC02SXGN-RC/2618262) |  | CHF | 0 | CHF
 |  | Led de vie verte (https://www.mouser.ch/datasheet/2/50/BIVA_S_A0002778794_1-2538596.pdf) | Mouser (https://www.mouser.ch/ProductDetail/Bivar/SM0805GCL?qs=jaLxTFIJCitl%252Bw30syUp6A%3D%3D) | 0.464 | CHF | 0 | CHF | Footprint (https://app.ultralibrarian.com/details/91603E15-7C75-11EB-9033-0A34D6323D74/Osram/LGR971-KN-1) |  |  |  |  |  |  |  | Digikey LED (https://www.digikey.ch/fr/products/filter/voyant-led-discret/105?s=N4IgTCBcDaIDIGUAEAVAbAdgNIgLoF8g)
 |  | RED SMD LED (https://www.mouser.ch/datasheet/2/427/VISH_S_A0001809793_1-2567791.pdf) | Mouser (https://www.mouser.ch/ProductDetail/Vishay-Semiconductors/VLMT3100-GS08?qs=0a36Zf3k4G%252BVBROXbJBpfw%3D%3D) | 0.144 | CHF | 0 | CHF |  |  |  |  |  |  |  |  | Mouser LED (https://www.mouser.fr/c/?q=LS%20T67K)
 |  | LED OSRAM 18 mcd (https://www.osram.com/ecat/TOPLED®%20LS%20T67K/com/en/class_pim_web_catalog_103489/prd_pim_device_2191024/) | Mouser (https://www.mouser.fr/ProductDetail/ams-OSRAM/LS-T67K-K1L2-1-0-2-R18-Z?qs=w%2Fv1CP2dgqoL7AK6LRHrUQ%3D%3D) | 0.114 | CHF
 |  | LED Osram Green (https://www.osram.com/ecat/TOPLED®%20LG%20T67K/com/en/class_pim_web_catalog_103489/prd_pim_device_2191026/)
RGB | Quantité | Description | Supplier | Price unit | CHF | Price | CHF
 | 432 | MAX7221 Serially Interfaced, 8-Digit LED Display Drivers (https://www.maximintegrated.com/en/products/power/display-power-control/MAX7219.html) | Aliexpress (https://fr.aliexpress.com/item/4001241785987.html) | 0.67 | CHF | 289.44 | CHF
 | 10000 | LED standard - CMS RGB LED OSIRE E3635 (https://www.osram.com/ecat/OSIRE®%20E3635%20LRTBGVSR/com/en/class_pim_web_catalog_103489/prd_pim_device_5154412/) | Mouser (https://www.mouser.ch/ProductDetail/OSRAM-Opto-Semiconductors/LRTBGVSR-U4V2-JW%2bA6BB-D8%2bS2U2-7Z-20-S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) | 0.172 | CHF | 1720 | CHF
 | 18 | PIC32MK0512MCF064T-I/PT | DigiKey (https://www.digikey.ch/en/products/detail/microchip-technology/PIC32MK0512MCF064T-I-PT/7203759) | 7.79 | CHF | 140.22 | CHF
 | 144 | PCB Matrix | Eurocircuit | 3 | CHF | 432 | CHF
 | 18 | PCB MainBoard uC | Eurocircuit | 4 | CHF | 72 | CHF
 |  |  |  | Total |  | 2653.66 | CHF
 |  |  |  | Unitaire |  | 147.43 | CHF
UNI | Quantité | Description | Supplier | Price unit | CHF | Price | CHF
 | 144 | MAX7221 Serially Interfaced, 8-Digit LED Display Drivers (https://www.maximintegrated.com/en/products/power/display-power-control/MAX7219.html) | Aliexpress (https://fr.aliexpress.com/item/4001241785987.html) | 0.67 | CHF | 96.48 | CHF
 | 10000 | LED RED DIFFUSED 5MM T/H (https://www.vishay.com/docs/83030/tllg540.pdf) | DigiKey (https://www.digikey.ch/fr/products/detail/vishay-semiconductor-opto-division/TLLR5401/4074719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) | 0.10323 | CHF | 1032.3 | CHF
 | 18 | PIC32MK0512MCF064T-I/PT | DigiKey (https://www.digikey.ch/en/products/detail/microchip-technology/PIC32MK0512MCF064T-I-PT/7203759) | 7.79 | CHF | 140.22 | CHF
 | 144 | PCB Matrix | Eurocircuit | 3 | CHF | 432 | CHF
 | 18 | PCB MainBoard uC | Eurocircuit | 4 | CHF | 72 | CHF
 |  |  |  | Total |  | 1773 | CHF
 |  |  |  | Unitaire |  | 98.5 | CHF
 |  |  |  | nb led | mA | mA
 |  |  |  | 64 | 2 | 128
 |  |  | LED/Mat | 30
 |  |  | nb Mat | 8
 |  |  | 8x8 | 64 | x8 | 512 | *18 | 9216
 |  |  |  |  |  |  |  | 0.172 |  | 1585.152 | CHF
