ETML-ES-SLO/PRJ_2126_AffichageMatriciel/(threads)

Thread 4 (2024-06-18):

listing des améliorations

PBYetml, 2024-06-18:
- [ ] => changer le nom en live
- [ ] => gérer la vitesse de défilement depuis l'application
- [ ] => gestion des caractères spéciaux
- [ ] => lancement automatique
- [ ] => contrôler si la session s'éteint

Thread 10 (2025-02-24):

portage prj existant sur nouvelle version MPLABX

PBYetml, 2025-02-24:
- [ ] => implémenter le projet (firmware) sur une nouvelle version de MPLABX
- version de l'IDE -> actuel -> nouveau
- version de compilateur -> actuel -> nouveau
- autres ...
