ETML-ES-SLO/PRJ_2126_AffichageMatriciel/hard/2126_A_MatrixBoard_AffichageMatricielNomEtudiant/Project Outputs for 2126_MatrixBoard_AffichageMatricielNomEtudiant/DesignDocs/Bill of Materials.PDF

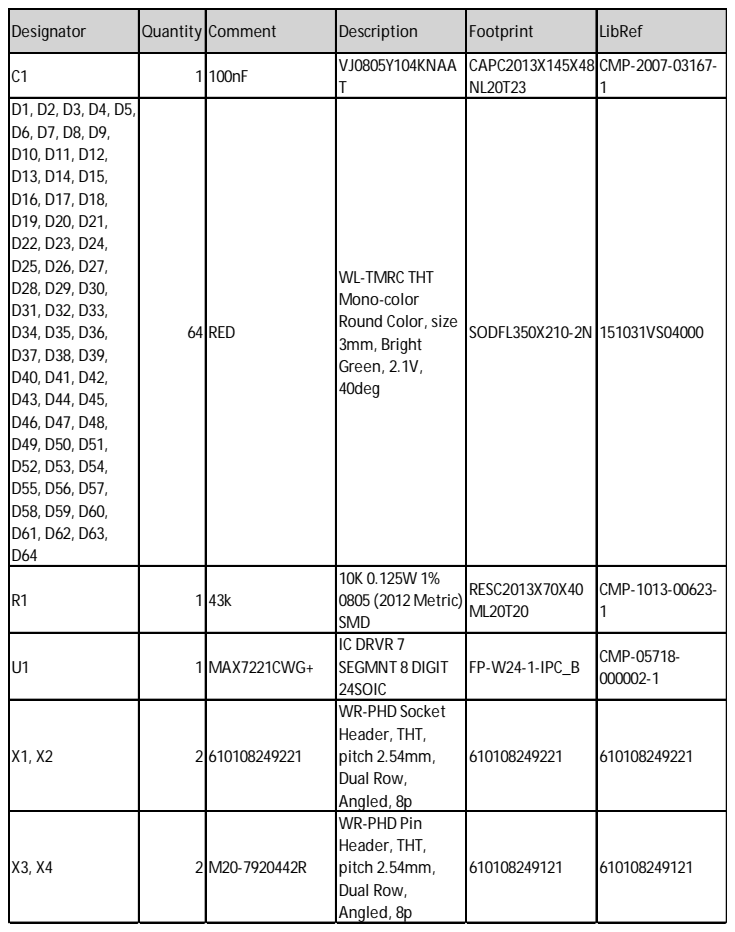
[picture p134: page 1]

Designator | Quantity | Comment | Description | Footprint | LibRef

C1 | 1 100nF | | VJ0805Y104KNAA T | CAPC2013X145X48 NL20T23 | CMP-2007-03167-1

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

X3, X4 | 2 M20-7920442R | WR-PHD Pin Header, THT, pitch 2.54mm, Dual Row, Angled, 8p | 610108249121 | 610108249121
