ETML-ES-SLO/PRJ_2126_AffichageMatriciel/mec/1457C801.pdf

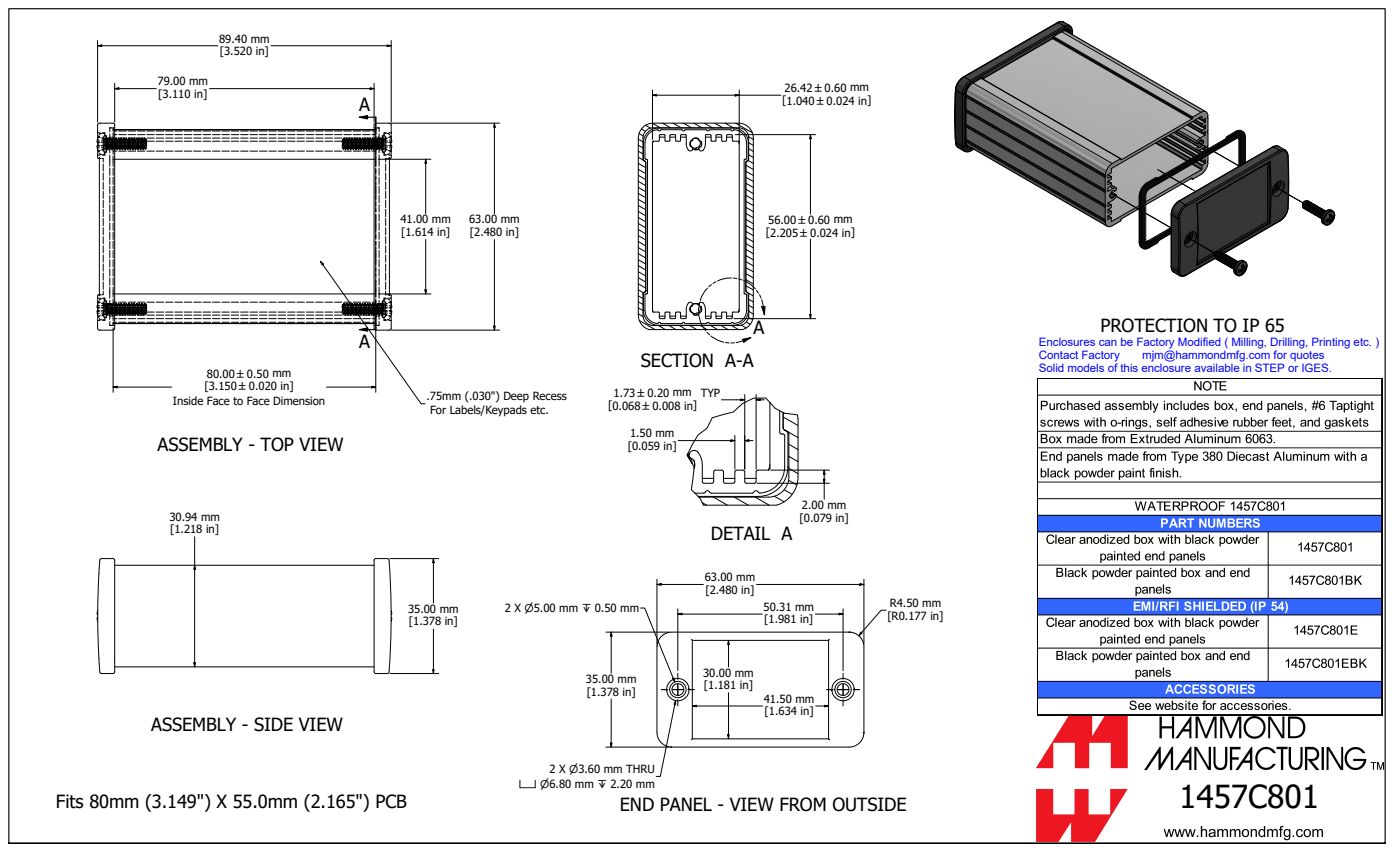
[picture p135: page 1]
SECTION A-A; DETAIL A; Contact Factory; mjm@hammondmfg.com for quotes; Fits 80mm (3.149") X 55.0mm (2.165") PCB

PROTECTION TO IP 65

Enclosures can be Factory Modified ( Milling, Drilling, Printing etc. )
Solid models of this enclosure available in STEP or IGES.

Inside Face to Face Dimension

.75mm (.030") Deep Recess
For Labels/Keypads etc.

ASSEMBLY - TOP VIEW

ASSEMBLY - SIDE VIEW

END PANEL - VIEW FROM OUTSIDE
