ETML-ES-SLO/PRJ_2126_AffichageMatriciel/doc/Rapports/Annexes/PDF/B_Schematic_2126_A_MainBoard.PDF

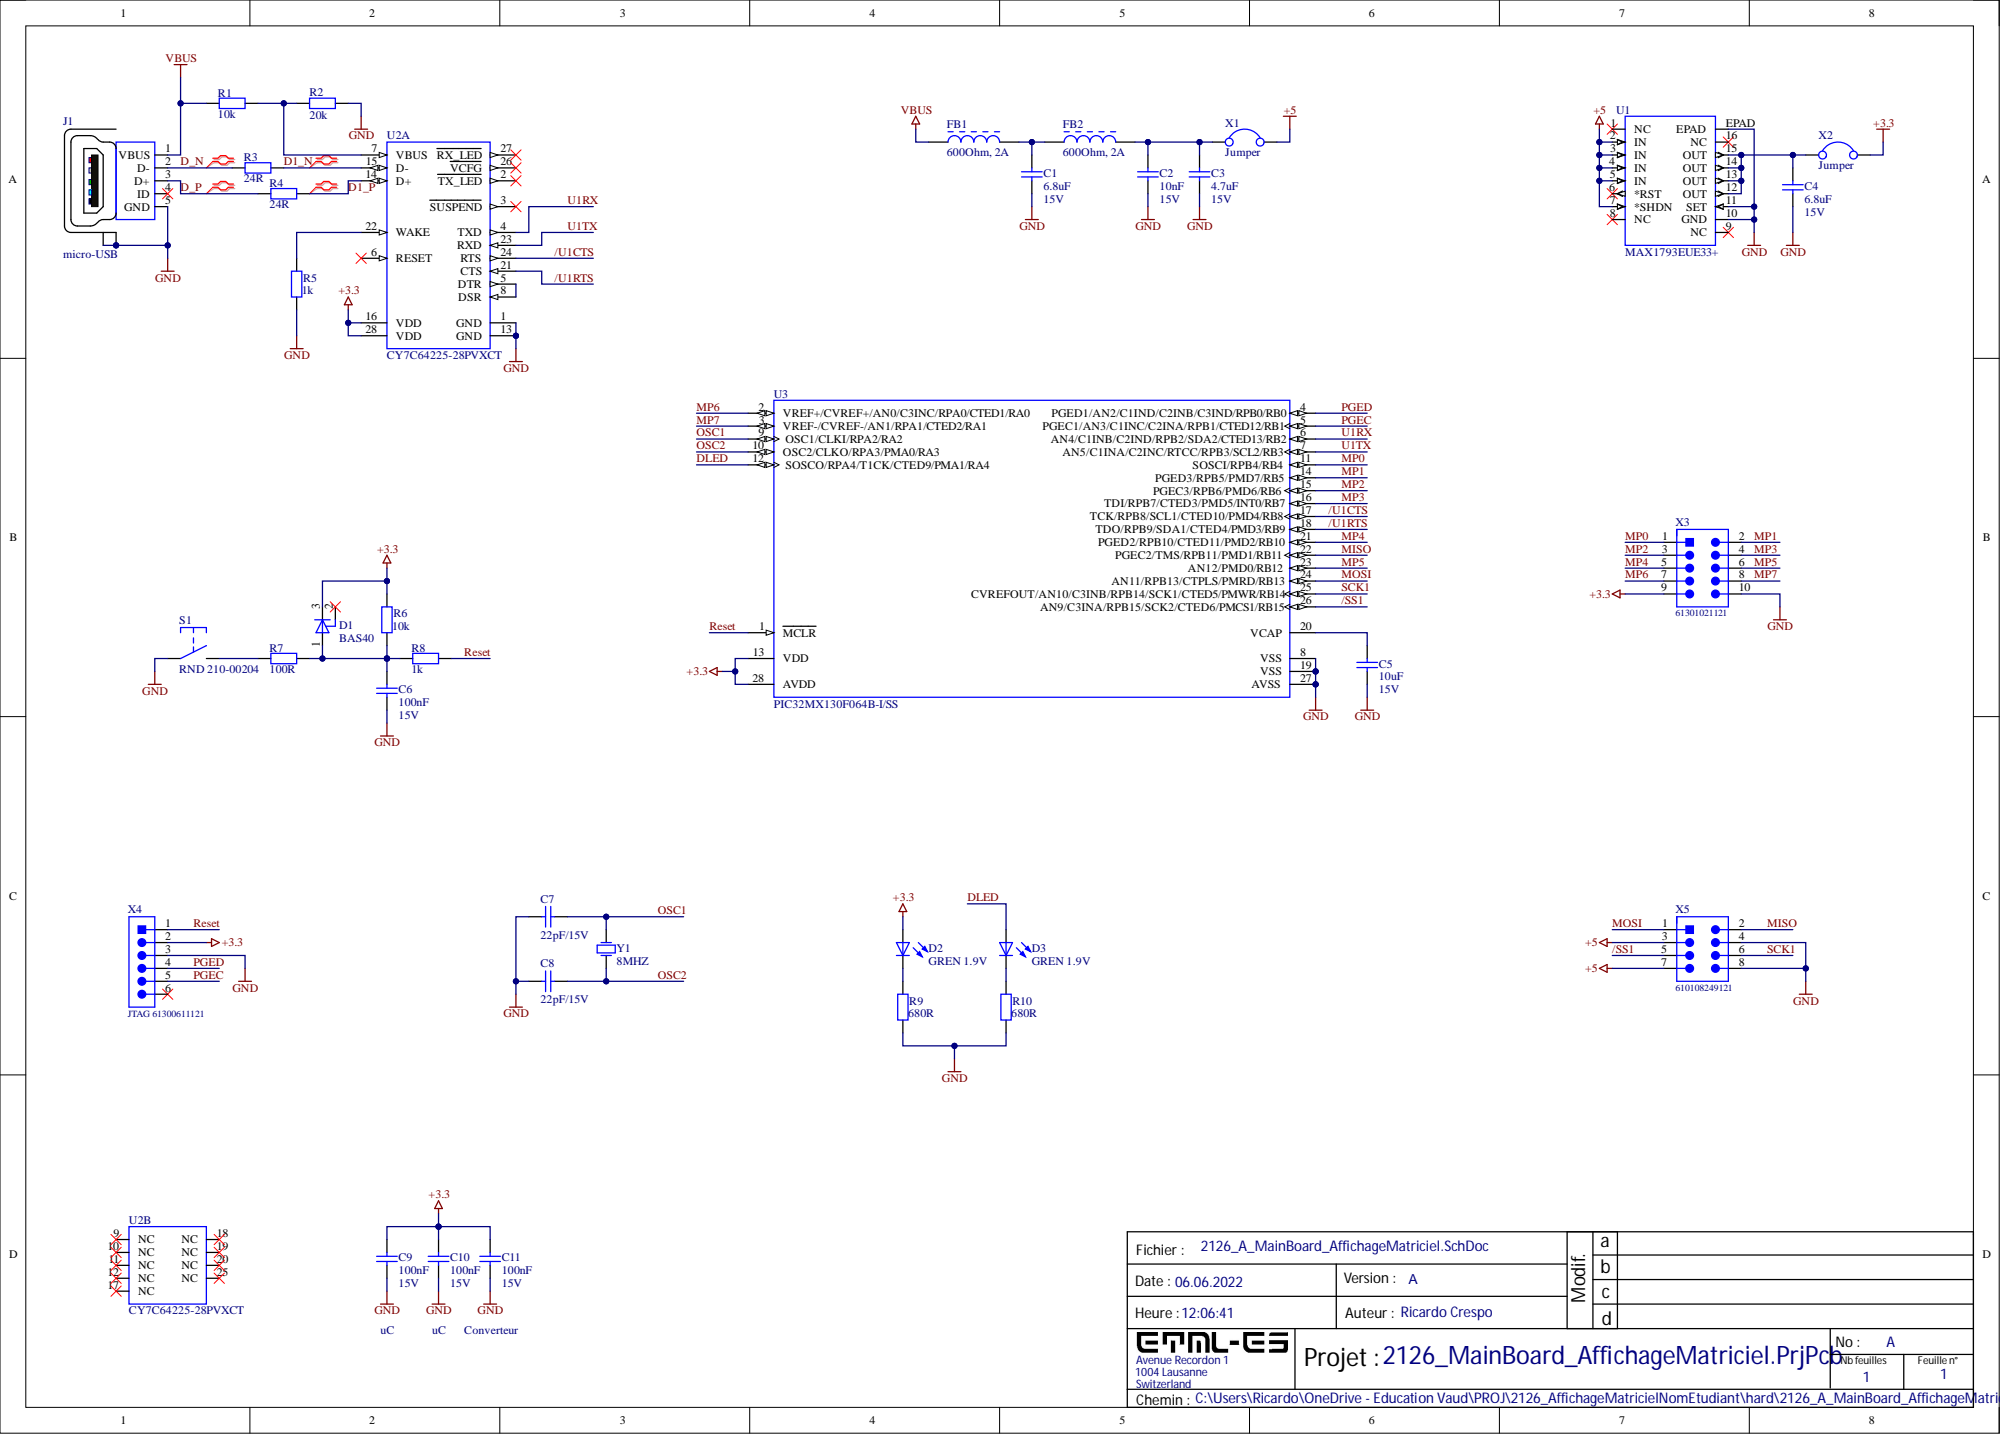
[picture p136: page 1]

RESET 6

VDD 28

Heure : 12:06:41 | Auteur : Ricardo Crespo

Avenue Recordon 1 1004 Lausanne Switzerland | | No : A

Nb feuilles 1 | Feuille n° 1

Chemin : C:\Users\Ricardo\OneDrive - Education Vaud\PROJ\2126_AffichageMatricielNomEtudiant\hard\2126_A_MainBoard_AffichageMatricielNomEtudiant\2126_A_MainBoard_AffichageMatriciel.SchDoc
