ETML-ES-SLO/PRJ_2126_AffichageMatriciel/doc/Rapports/Annexes/PDF/C_Schematic_2126_B_Matrix.PDF

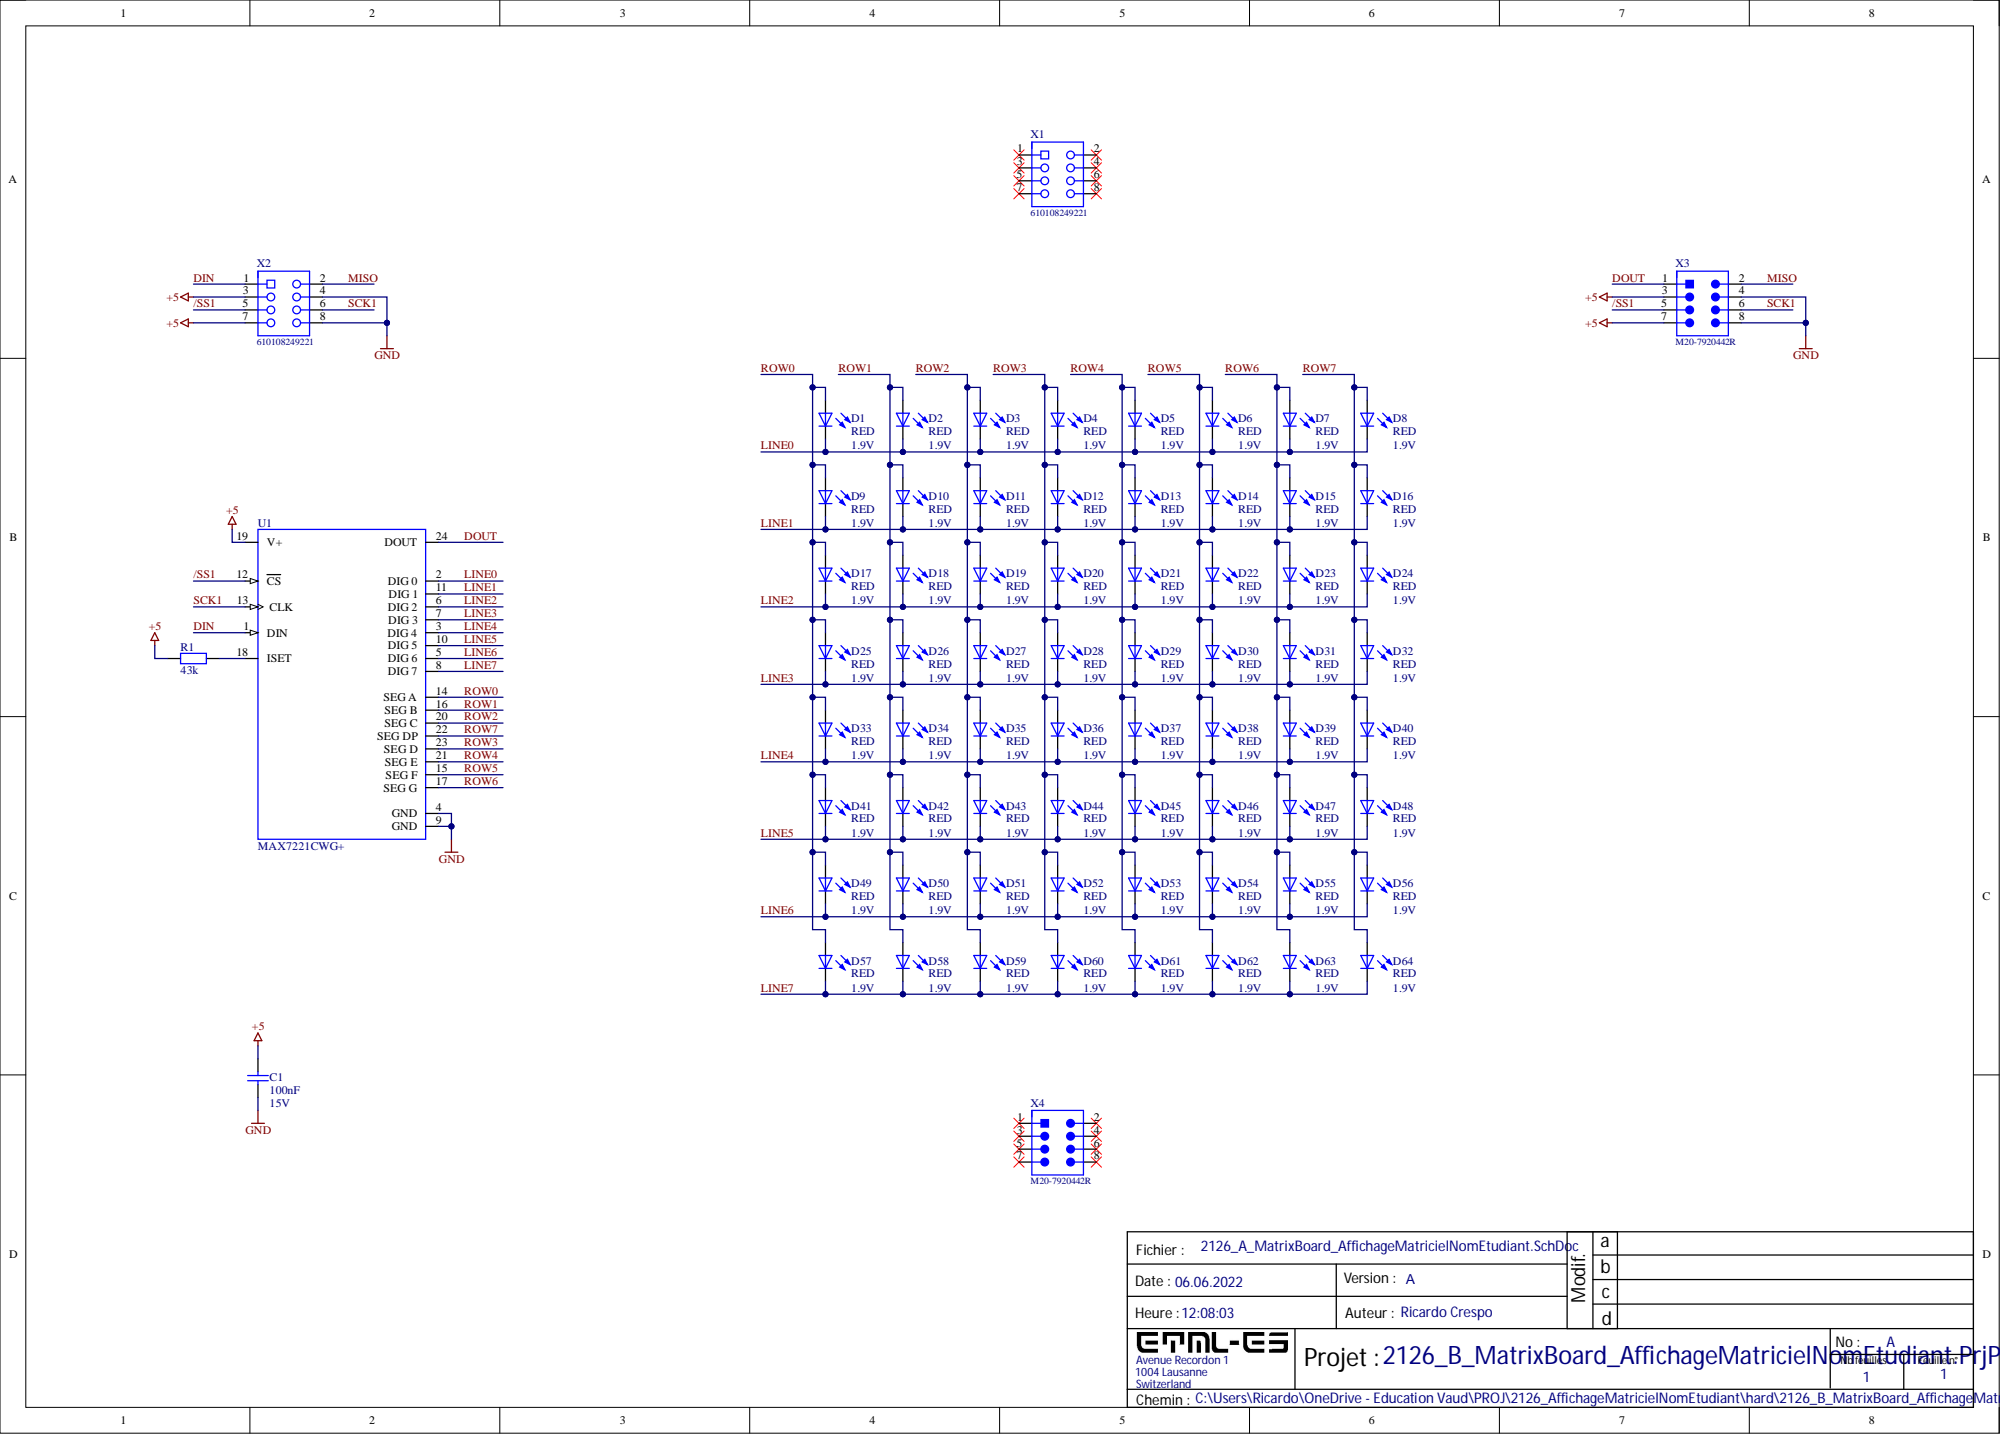
[picture p137: page 1]

2126_A_MatrixBoard_Affi chageMatricielNomE tudiant . SchDoc Fichier :

Date : 06.06.2022 | Version : A

Heure : 12:08:03 | Auteur :
Avenue Re cordon 1 1 004 Lausanne Switzerland | Projet | No : A

Nb feuille s 1 | F euille n° 1

Chemin : C:\Users\Ricardo\OneDrive - Education Vaud\P
