ETML-ES-SLO/PRJ_2126_AffichageMatriciel/hard/2126_A_MainBoard_AffichageMatricielNomEtudiant/Project Outputs for 2126_MainBoard_AffichageMatriciel/DesignDocs/Dimensional Drawings.PDF

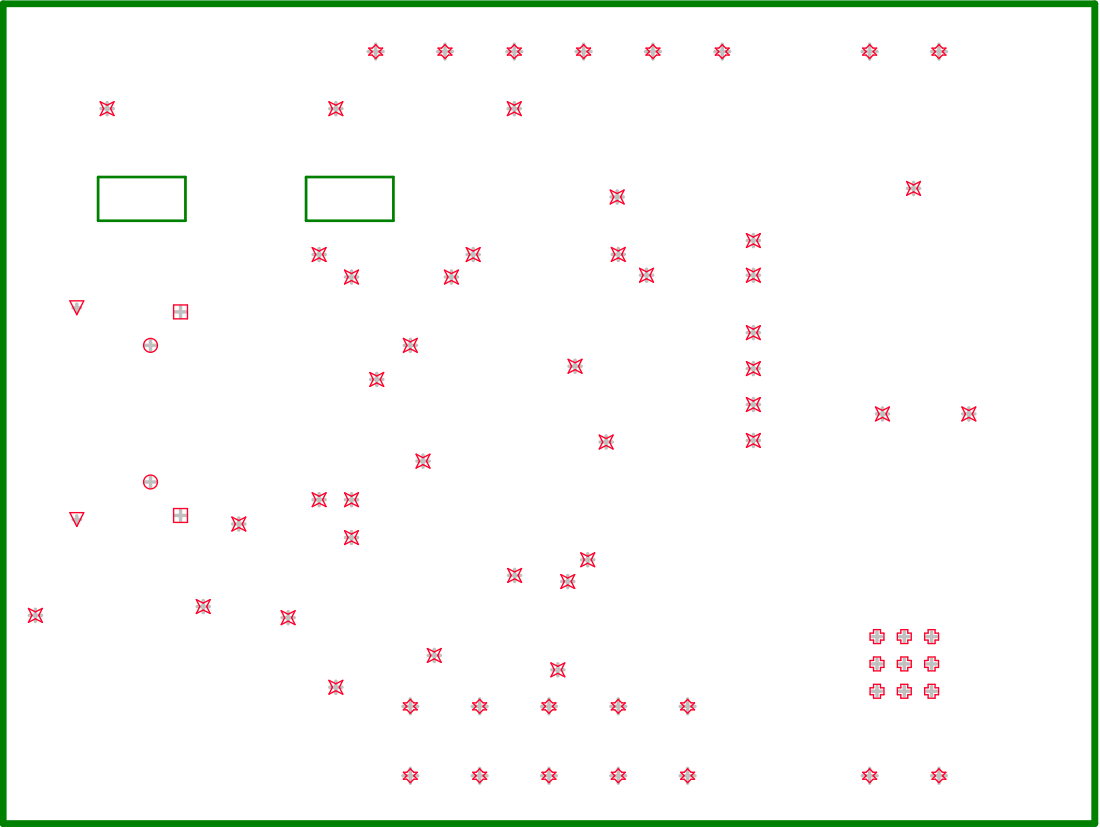
[picture p138: page 1]
