ETML-ES-SLO/PRJ_2126_AffichageMatriciel/hard/2126_A_MainBoard_AffichageMatricielNomEtudiant/Project Outputs for 2126_MainBoard_AffichageMatriciel/DesignDocs/PCB Top-Bottom Assy Dwgs.PDF

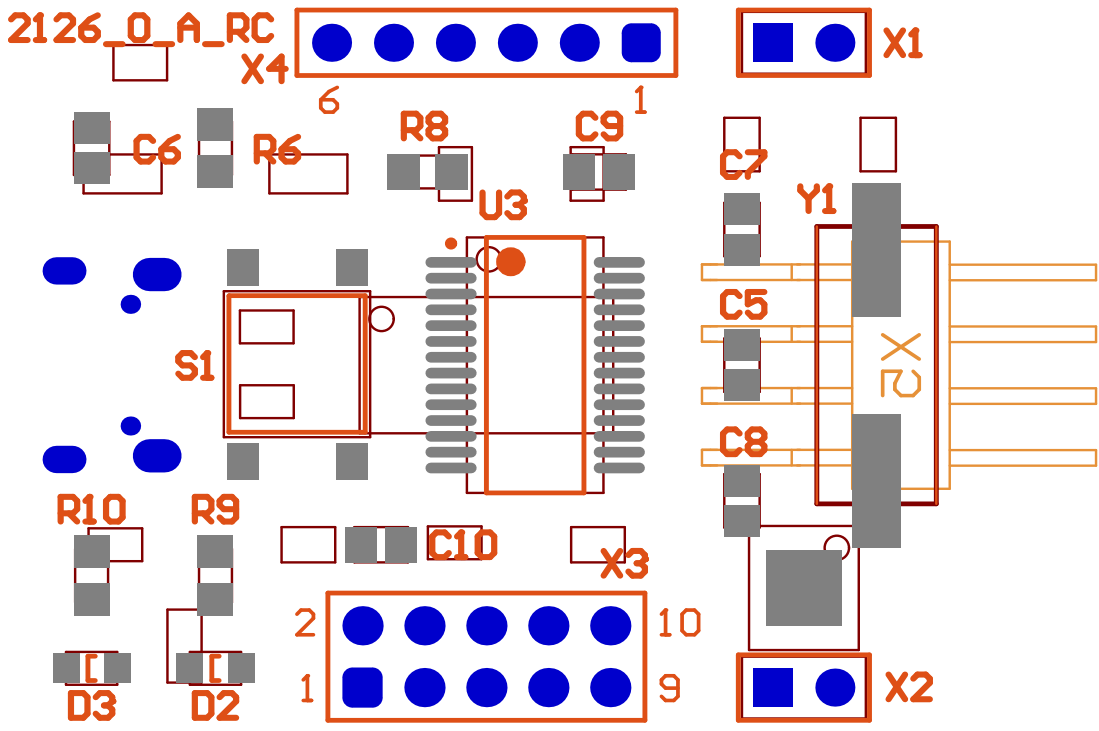
[picture p139: page 1]

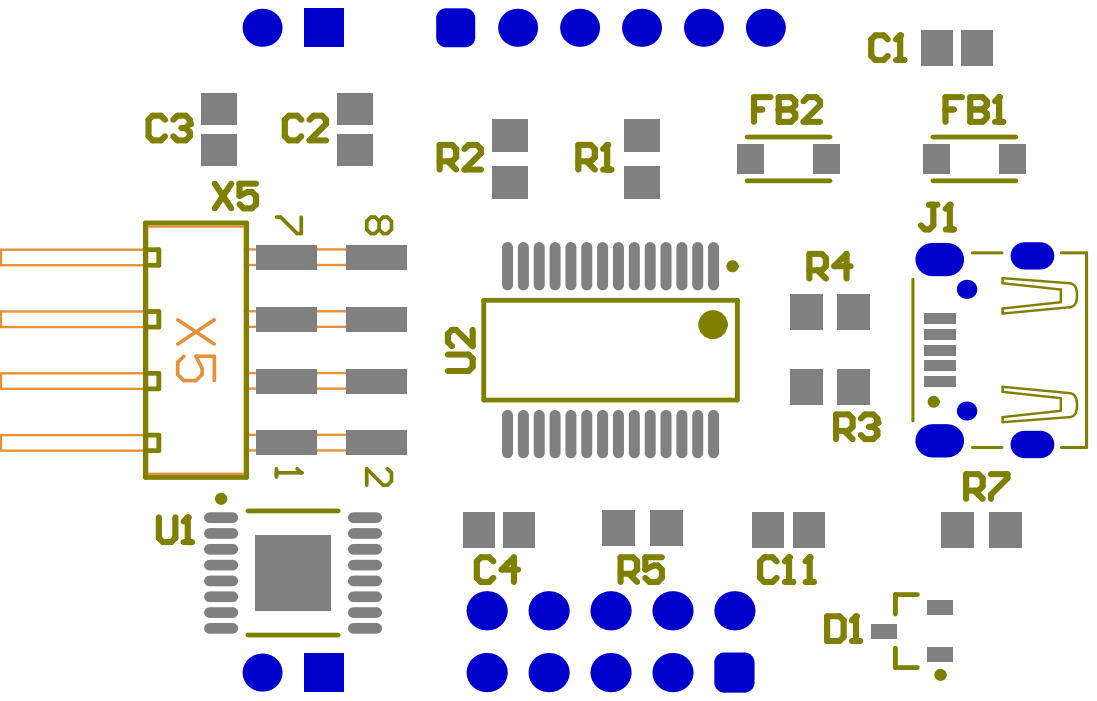
[picture p140: page 2]
