ETML-ES-SLO/PRJ_2126_AffichageMatriciel/hard/2126_A_MatrixBoard_AffichageMatricielNomEtudiant/Project Outputs for 2126_MatrixBoard_AffichageMatricielNomEtudiant/DesignDocs/Dimensional Drawings.PDF

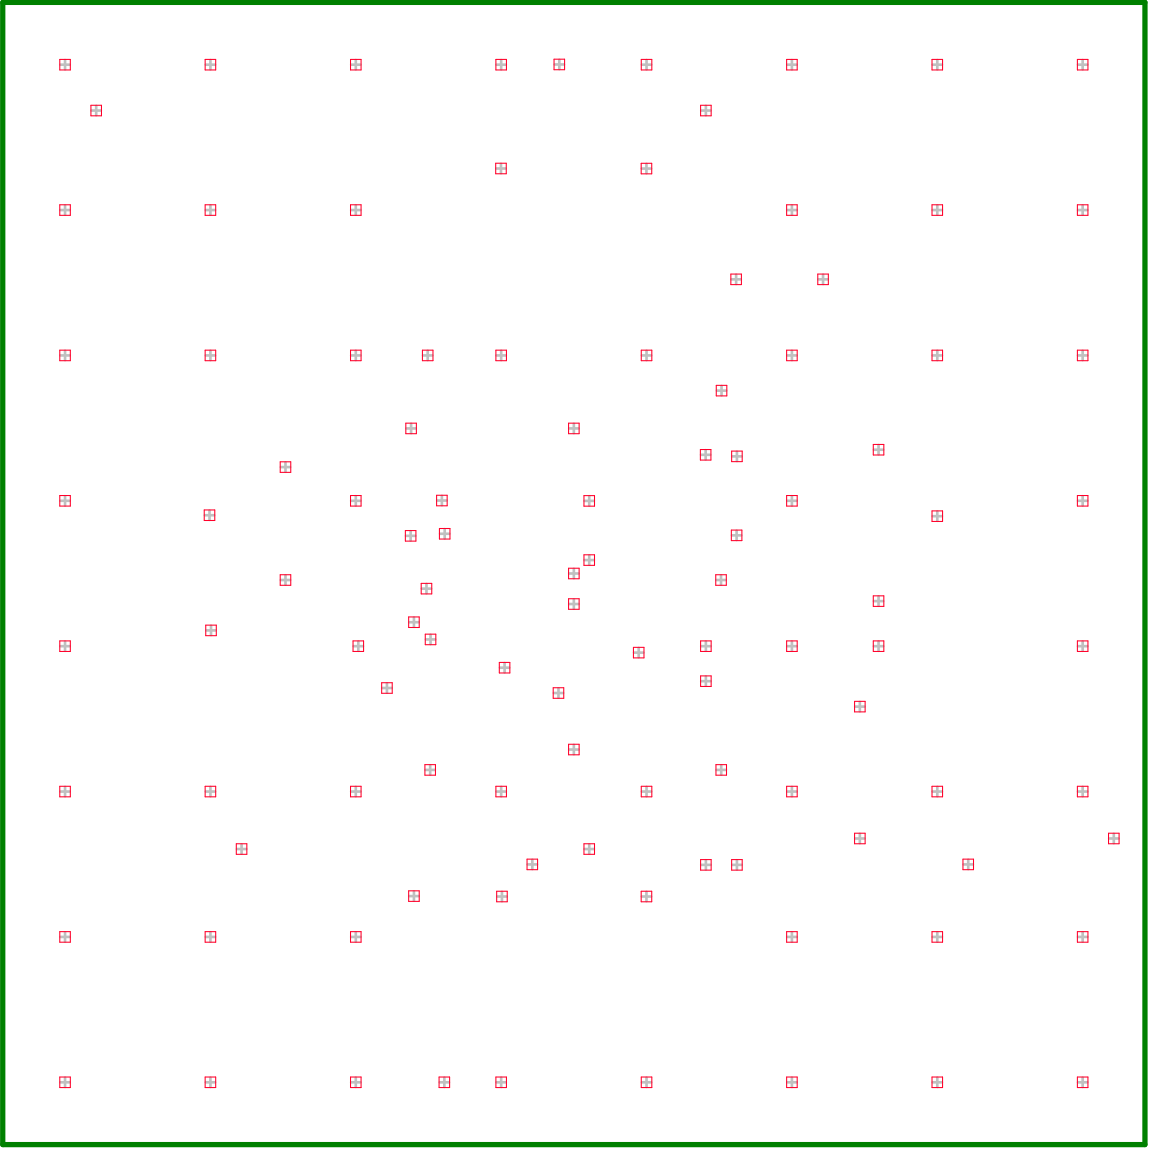
[picture p141: page 1]
