ETML-ES-SLO/PRJ_2126_AffichageMatriciel/hard/2126_A_MatrixBoard_AffichageMatricielNomEtudiant/Project Outputs for 2126_MatrixBoard_AffichageMatricielNomEtudiant/DesignDocs/PCB Top-Bottom Assy Dwgs.PDF

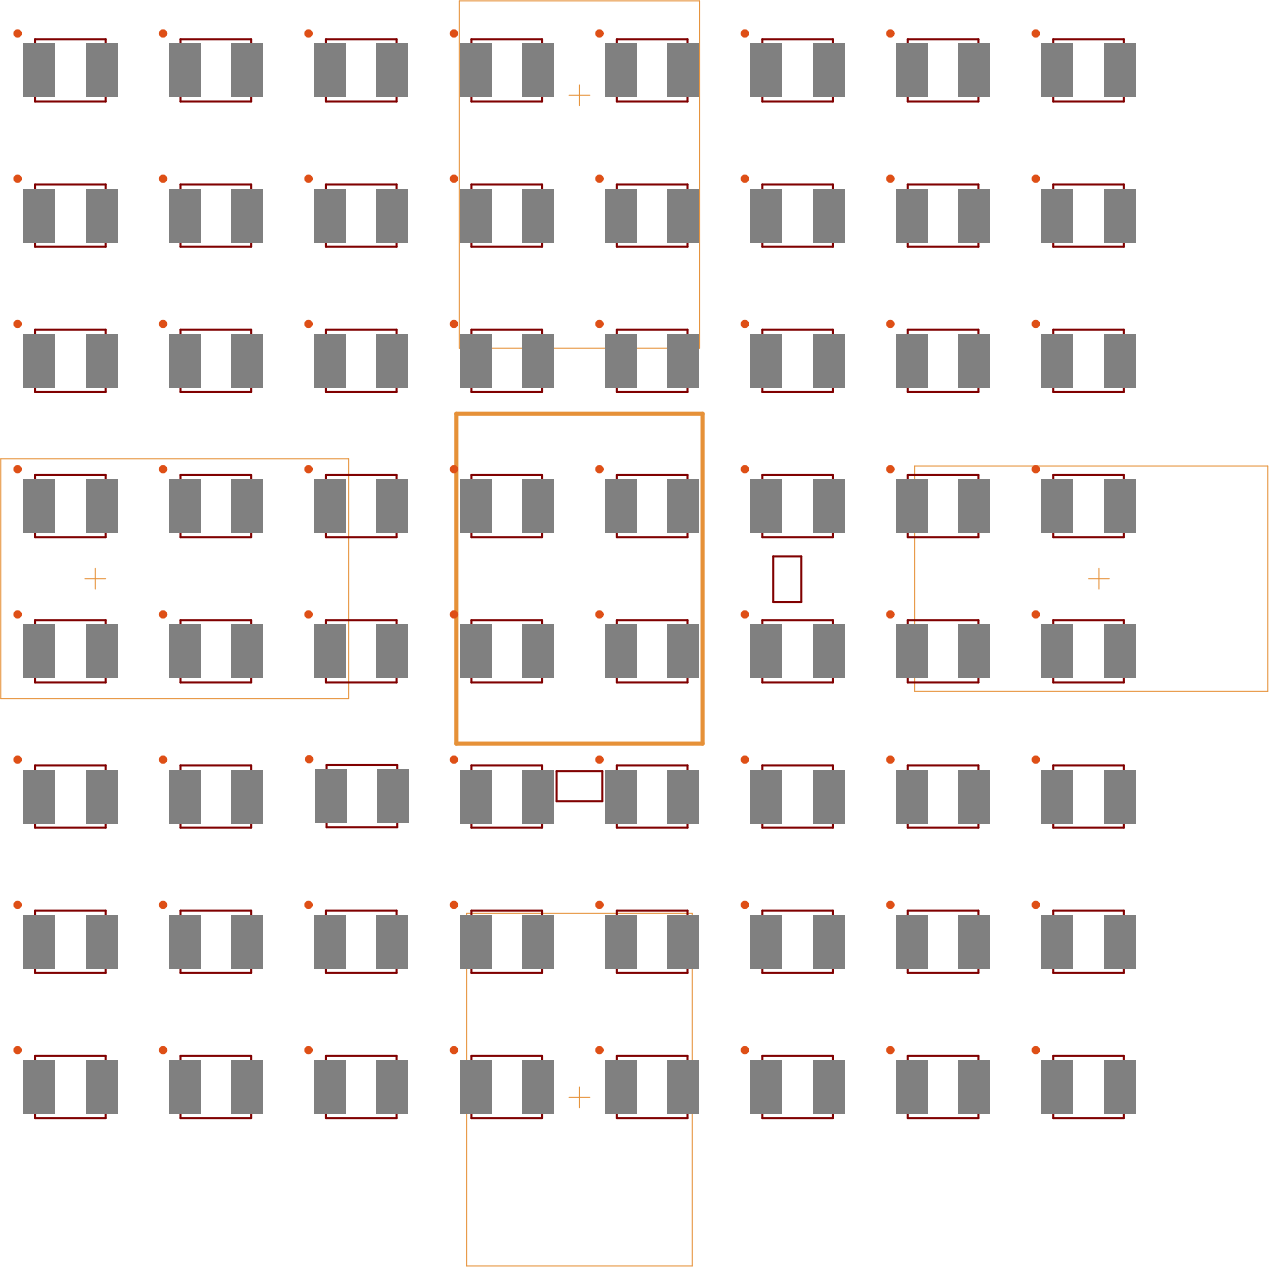
[picture p142: page 1]

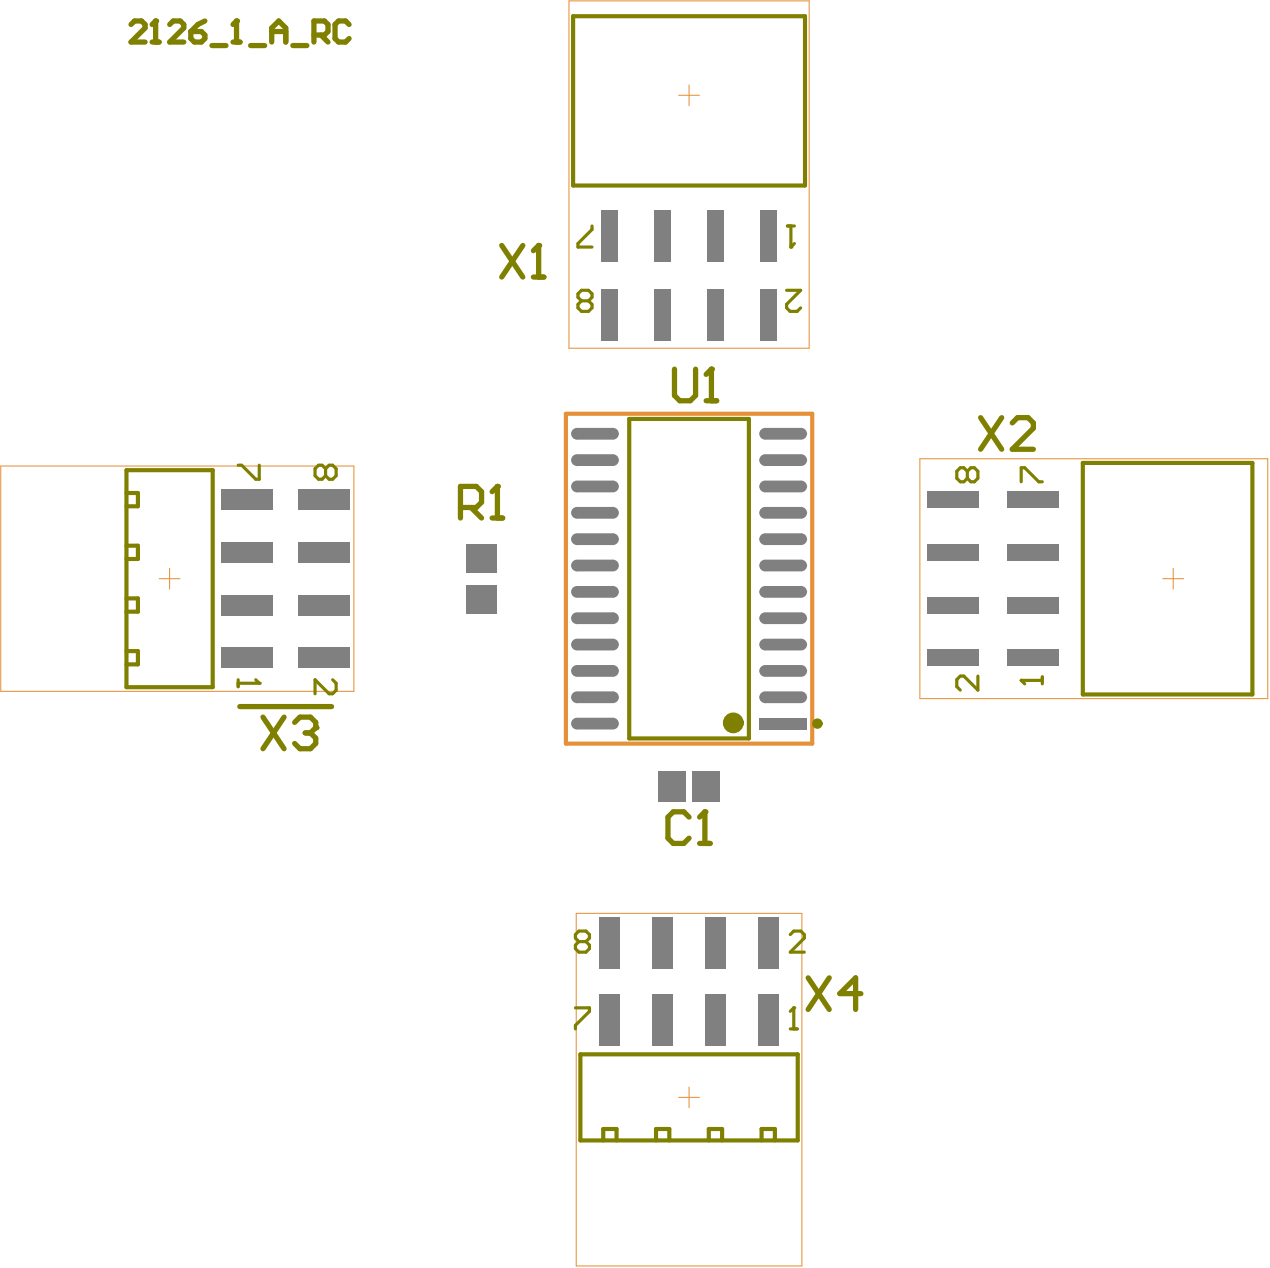
[picture p143: page 2]
