ETML-ES-SLO/PRJ_2126_AffichageMatriciel/hard/2126_A_MatrixBoard_AffichageMatricielNomEtudiant/Project Outputs for 2126_MatrixBoard_AffichageMatricielNomEtudiant/DesignDocs/Schematic Prints.PDF

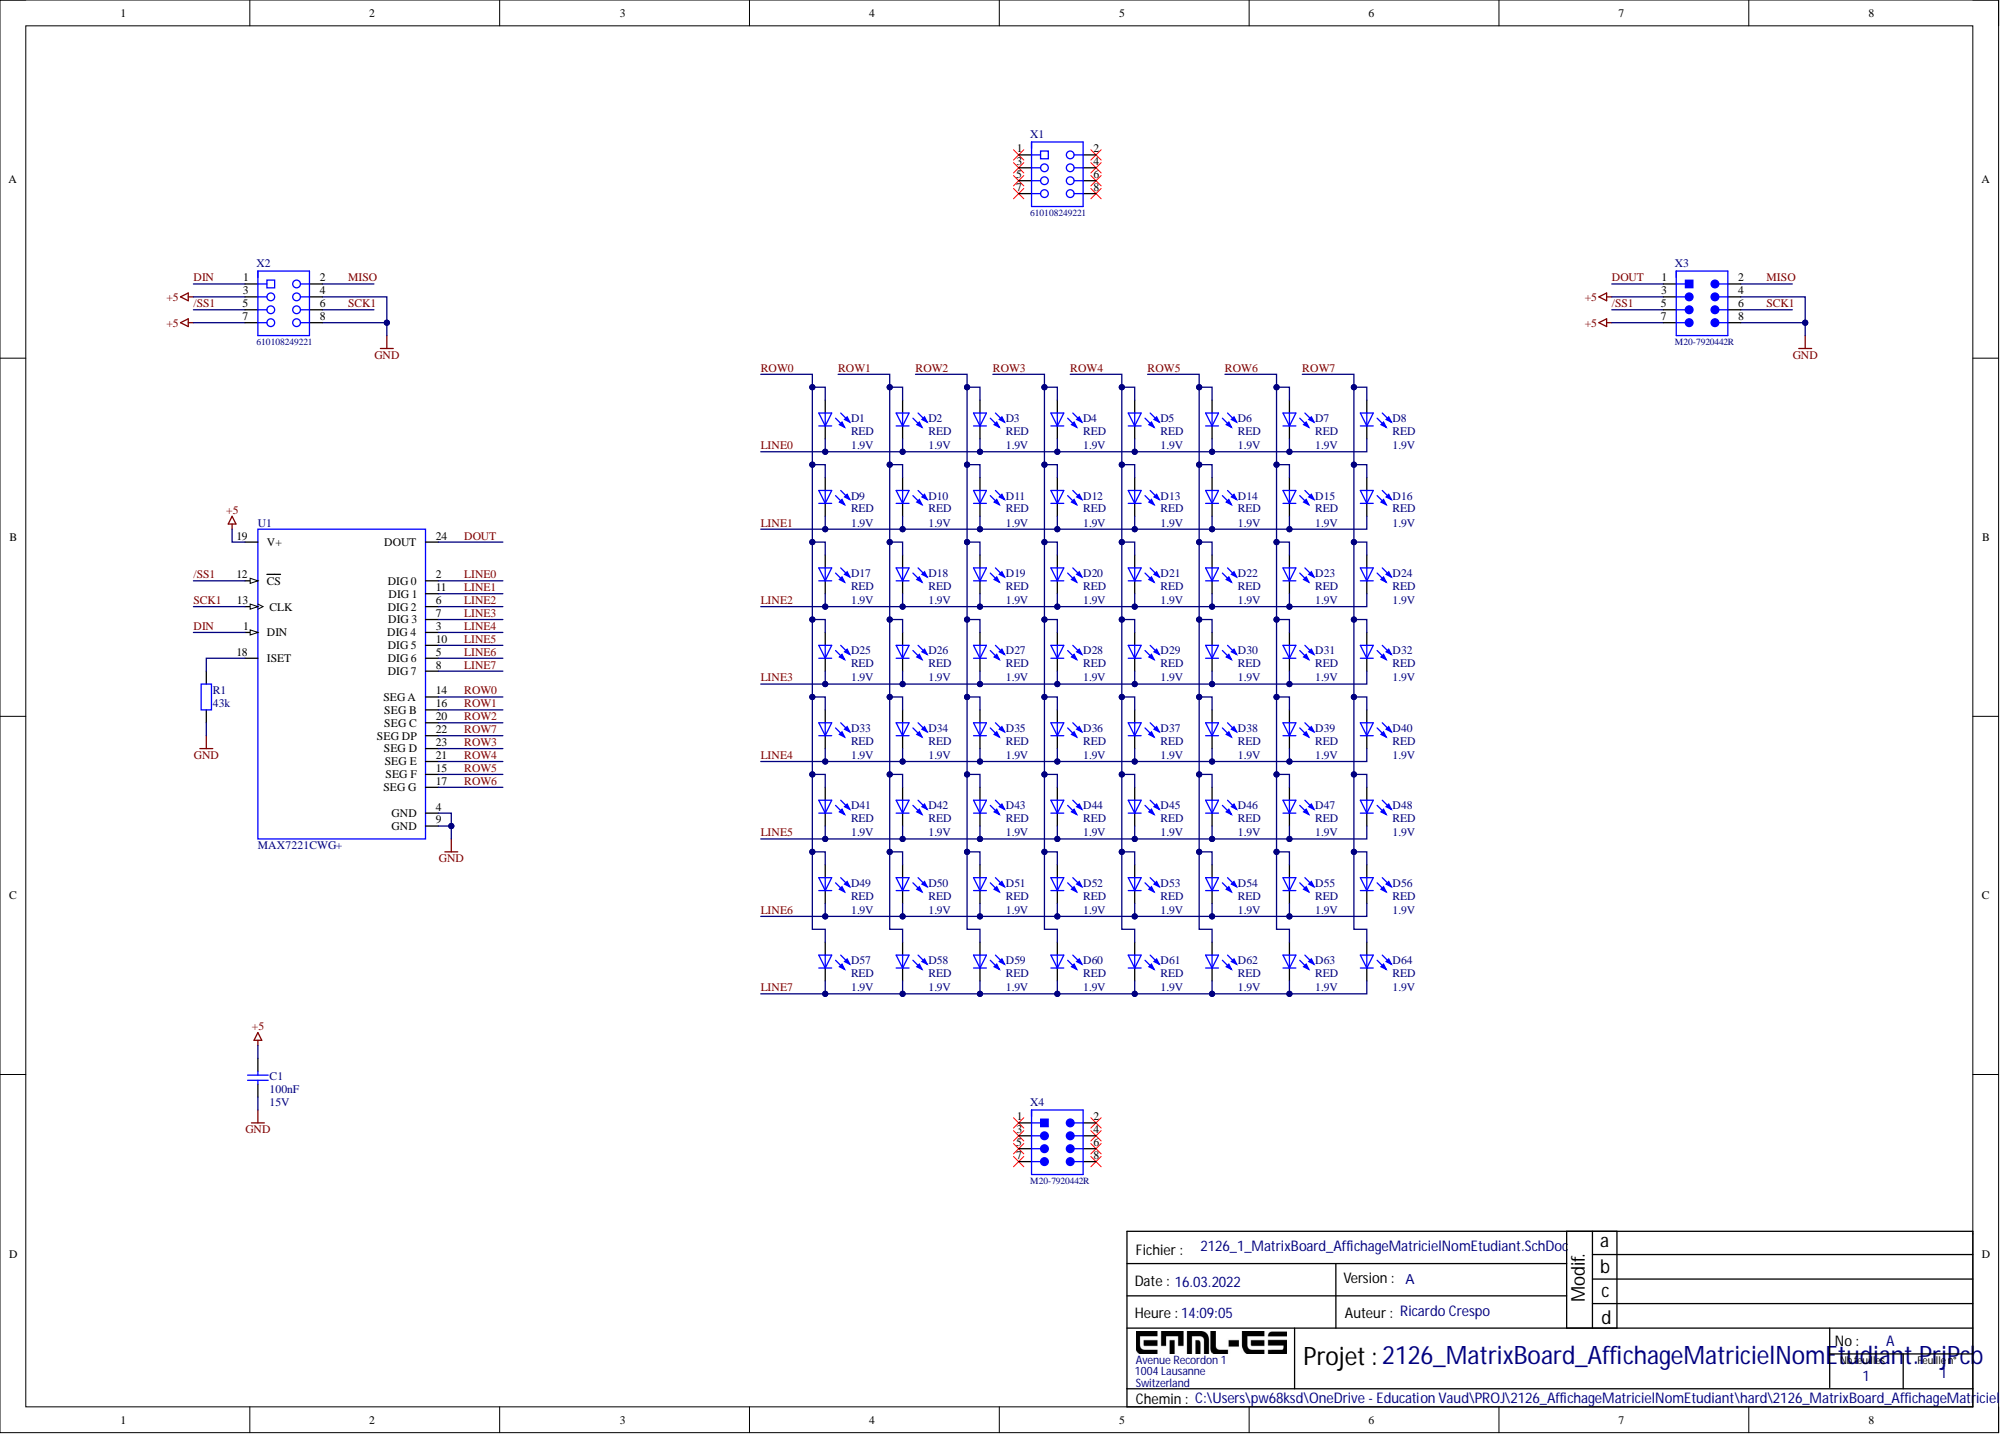
[picture p144: page 1]

2126_1_MatrixBoard_Affi chageMatricielNomE tudiant . SchDoc Fichier :

Date : 16.03.2022 | Version : A

Heure : 14:09:05 | Ricardo Crespo Auteur :
Avenue R e cordon 1 1 004 Lausanne Switzerland | Projet : 2126_MatrixBoard_AffichageMatricielNomEtudiant.Prj | No : A

Nb feuille s 1 | F euille n° 1

Chemin : C:\Users\pw68ksd\OneDrive - Education Vaud\P
