ETML-ES-SLO/PRJ_2126_AffichageMatriciel/hard/2126_B_MatrixBoard_AffichageMatricielNomEtudiant/Project Outputs for 2126_B_MatrixBoard_AffichageMatricielNomEtudiant/DesignDocs/Dimensional Drawings.PDF

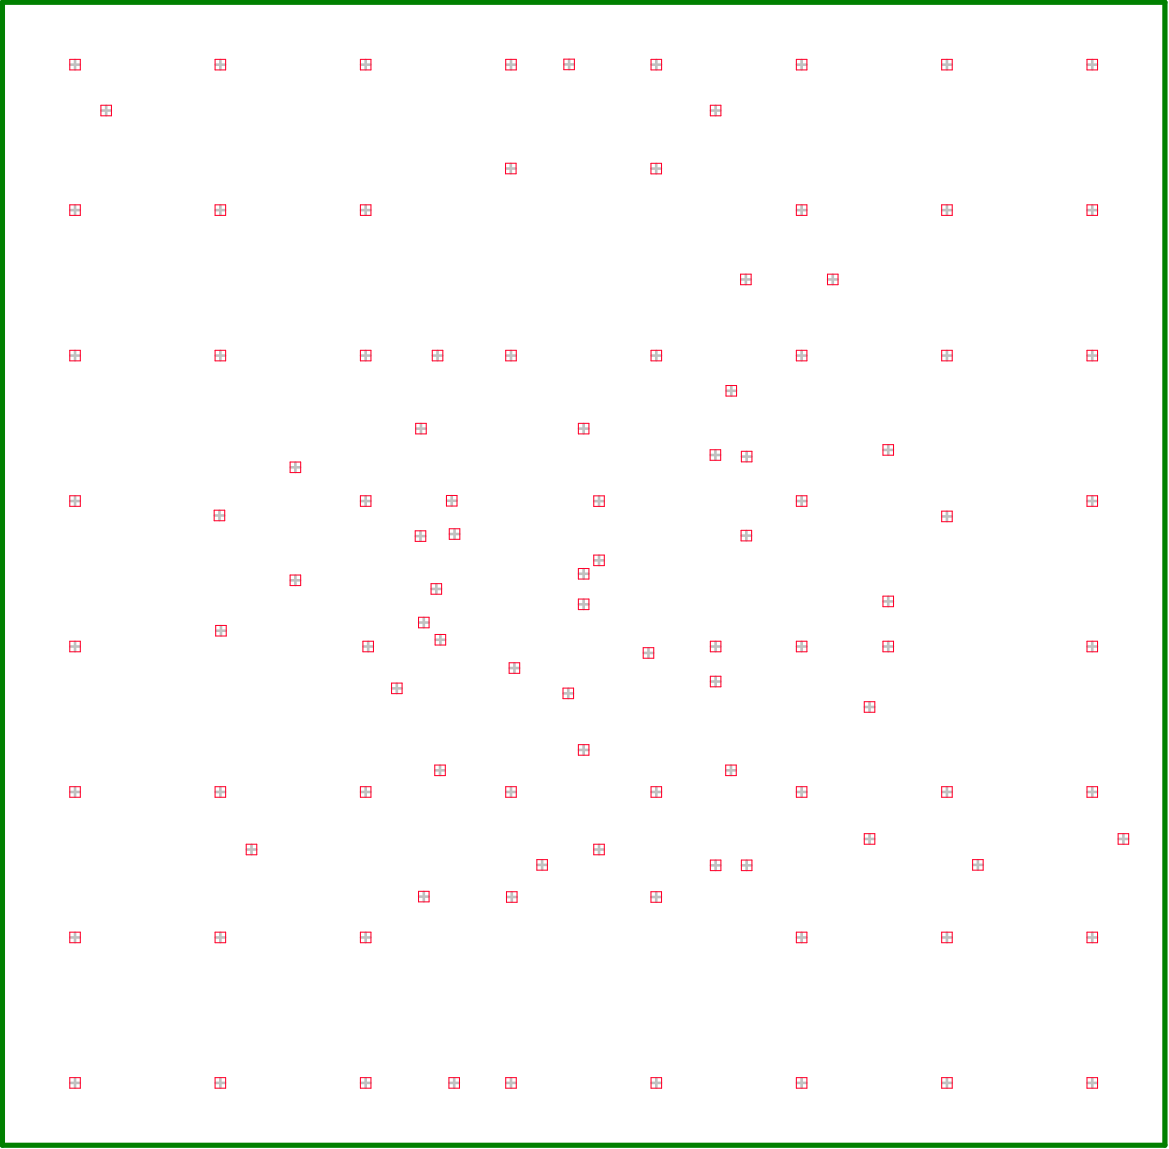
[picture p145: page 1]
