ETML-ES-SLO/PRJ_2126_AffichageMatriciel/hard/2126_B_MatrixBoard_AffichageMatricielNomEtudiant/Project Outputs for 2126_B_MatrixBoard_AffichageMatricielNomEtudiant/DesignDocs/PCB Top-Bottom Assy Dwgs.PDF

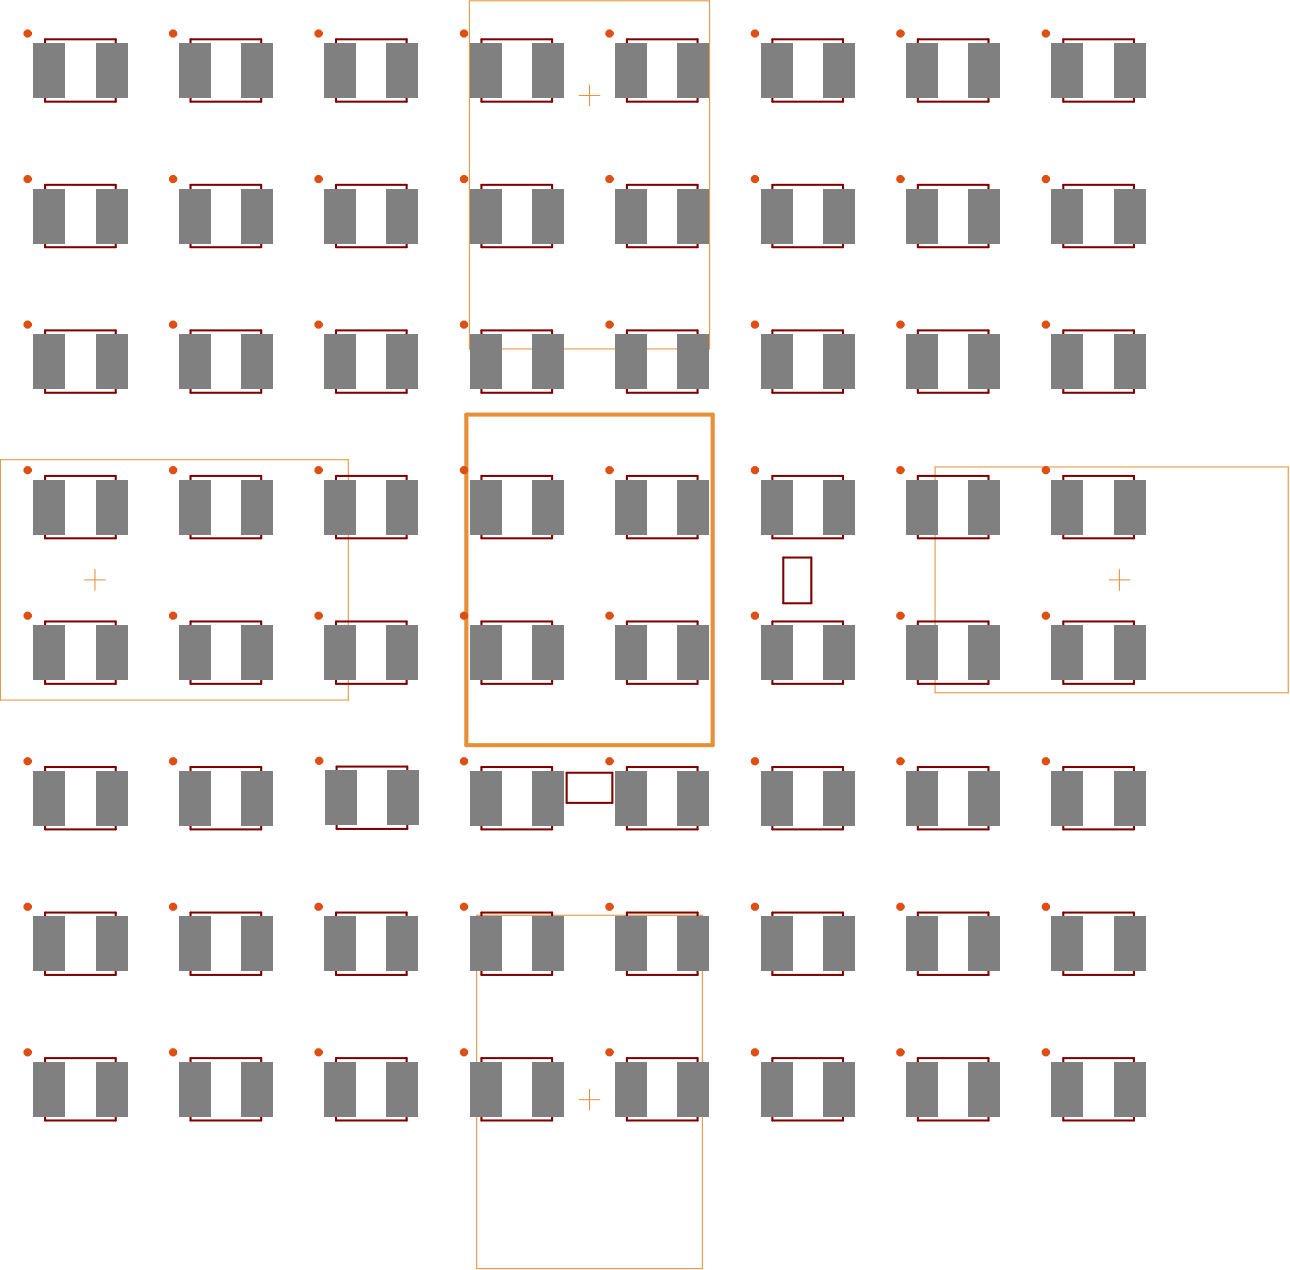
[picture p146: page 1]

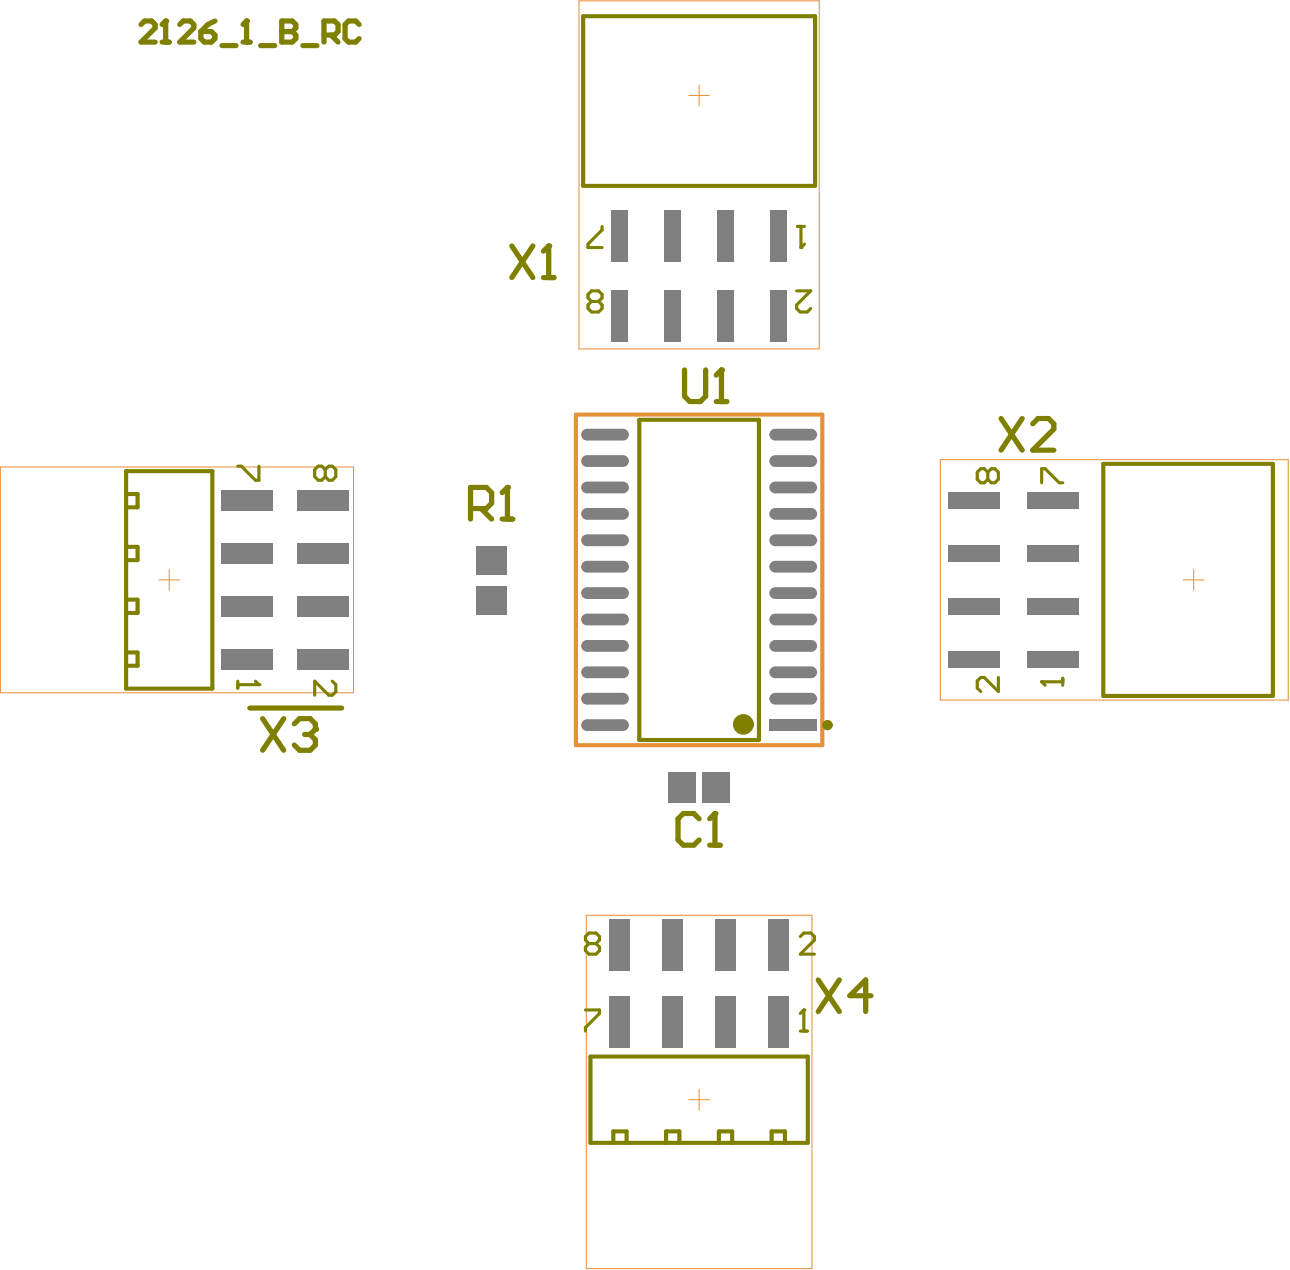
[picture p147: page 2]
