ETML-ES-SLO/PRJ_2126_AffichageMatriciel/doc/Schemas/2126_0_MainBoard_AffichageMatriciel_A.pdf

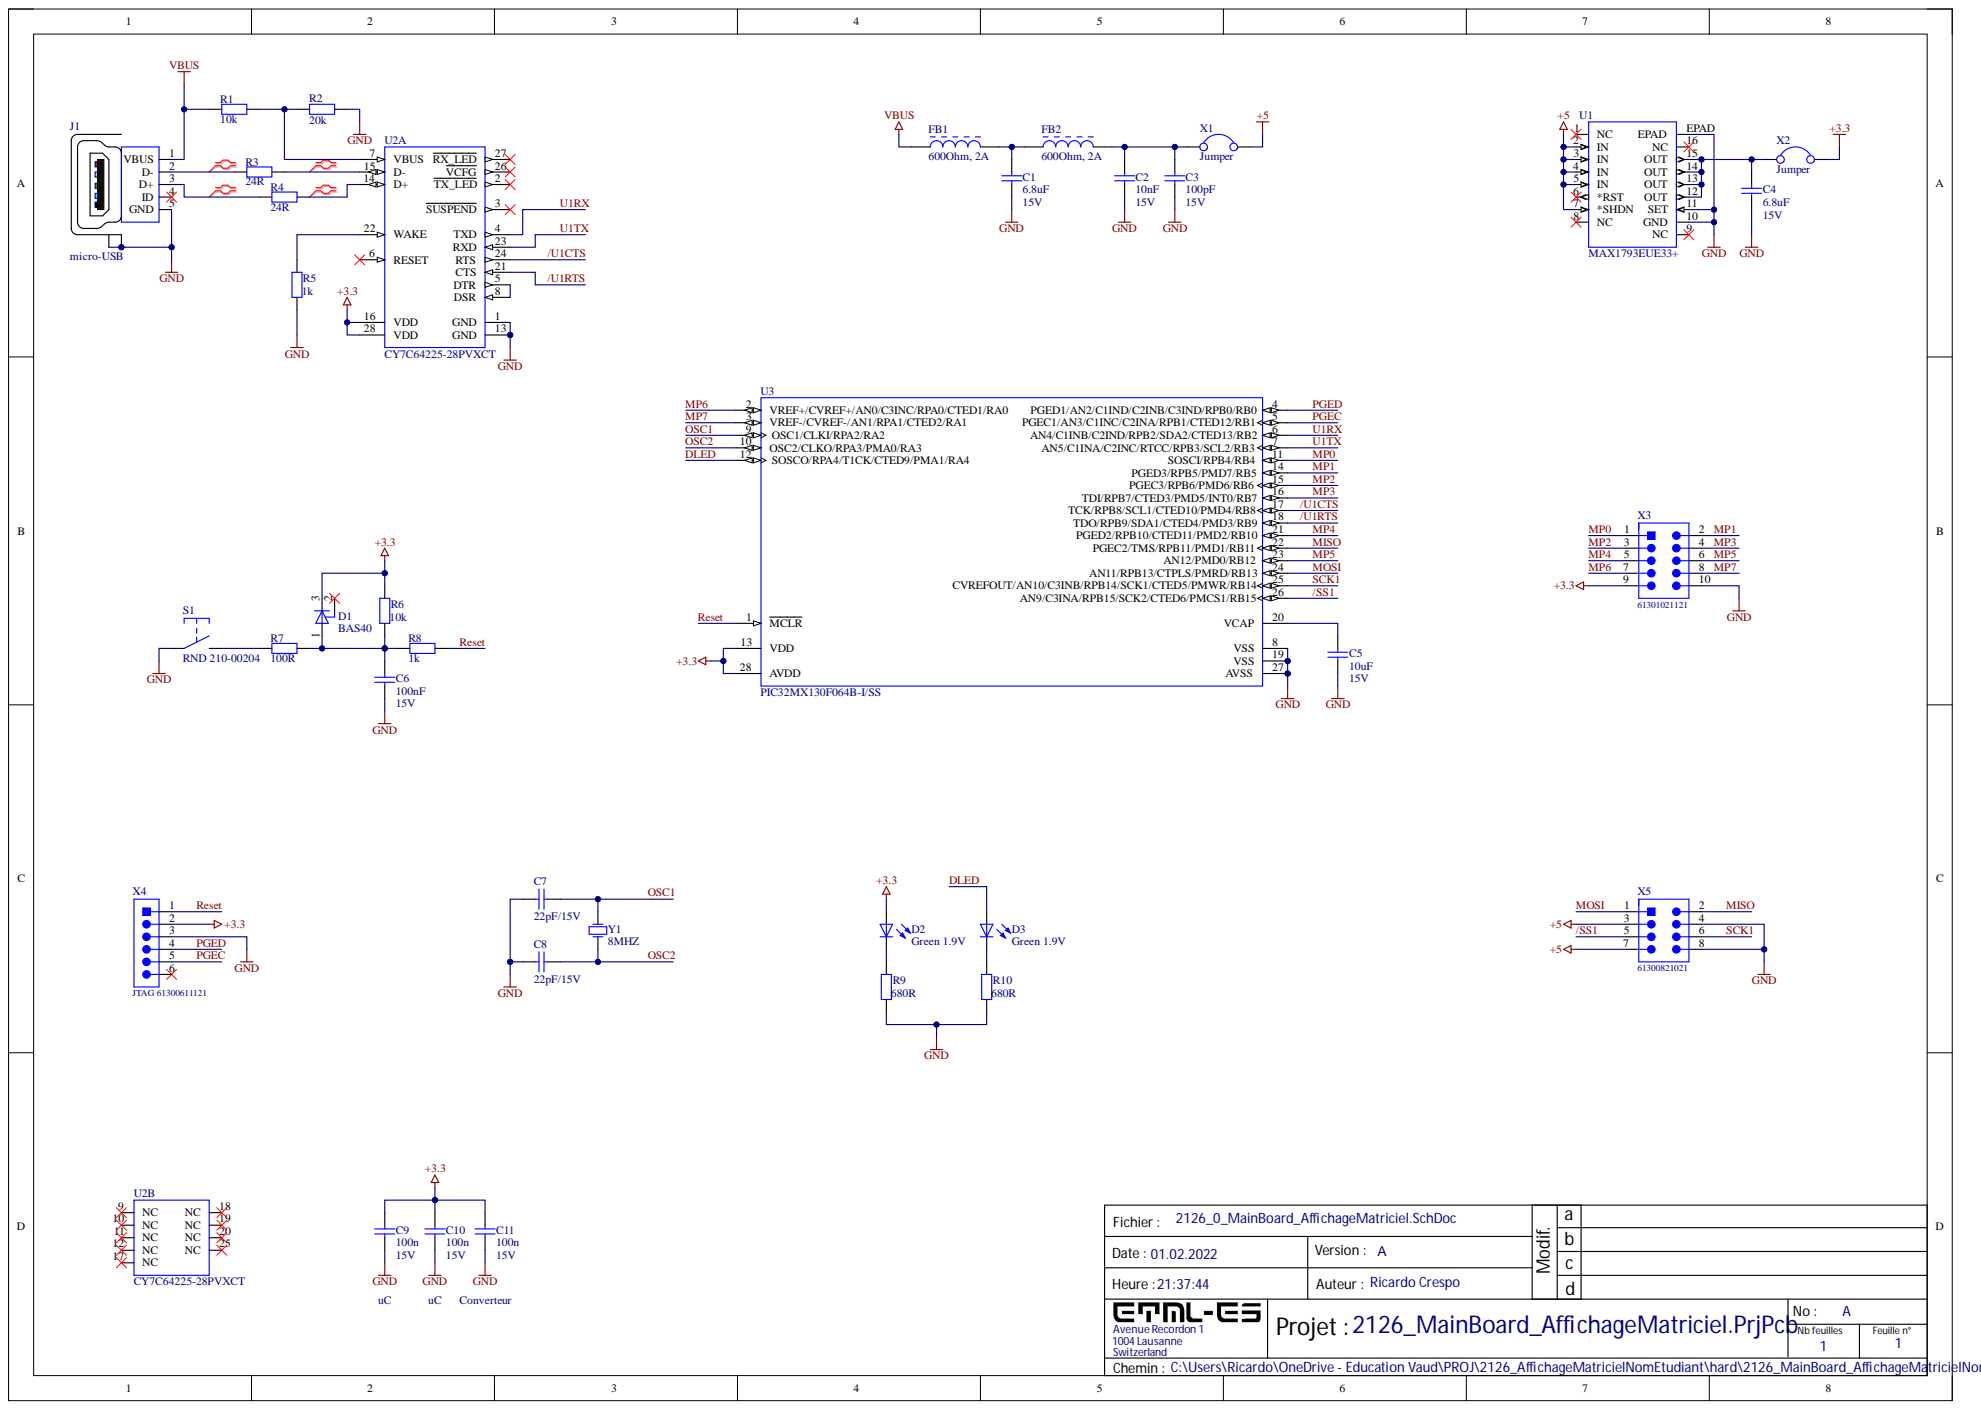
[picture p148: page 1]

Heure : 21:37:44 | Ricardo Crespo Auteur :

Avenue Recordon 1 1004 Lausanne Switzerland | | No : A

Nb feuilles 1 | Feuille n° 1

Chemin : C:\Users\Ricardo\OneDrive - Education Vaud\PROJ\2126_AffichageMatricielNomEtudiant\hard\2126_MainBoard_AffichageMatricielNomEtudiant\2126_0_MainBoard_AffichageMatriciel.SchDoc
