ETML-ES-SLO/PRJ_2126_AffichageMatriciel/doc/Schemas/2126_1_MatrixBoard_AffichageMatricielNomEtudiant_A.pdf

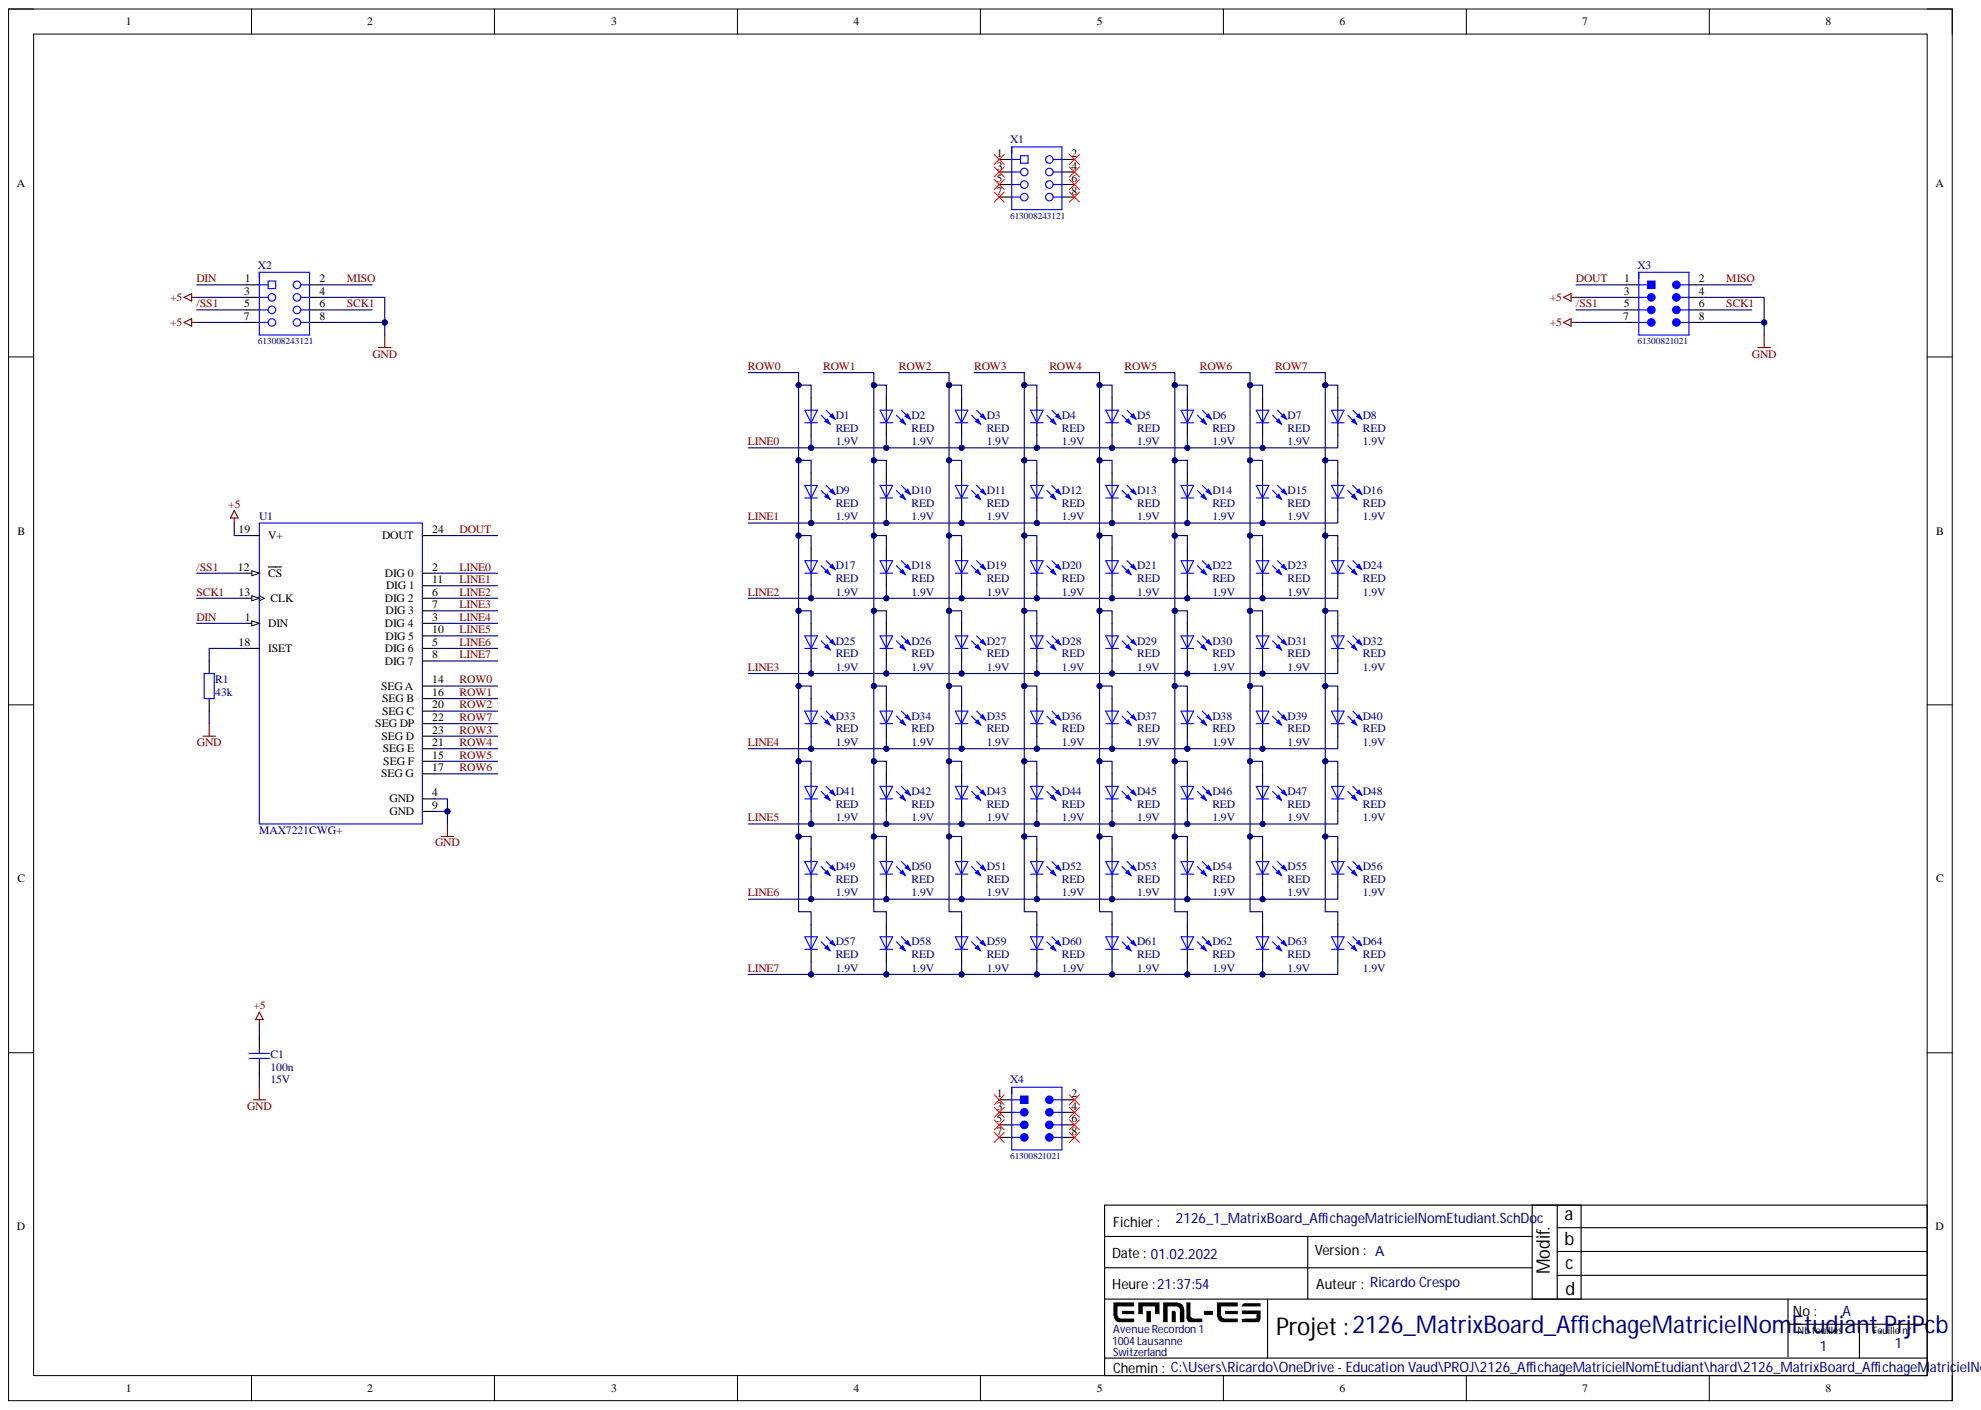
[picture p149: page 1]

2 1 2 6_1 _Mat rixBoard_A ffi chage Mat ricielNomEtudiant . SchDoc Fichie r :

abcd

Date : 01 . 02 . 2022 | Ve rsion : A

H eure : 2 1 : 3 7 : 54 | Auteur :

Projet :2126_MatrixBoard_AffichageMatricielNomEtudiant.PrjPcb Ricardo Crespo

Aven ue Reco rd o n 1 1004 Lausanne Swi tzer l a n d | | No : A

N b feuilles 1 | Feuille n° 1
