ETML-ES-SLO/PRJ_2126_AffichageMatriciel/doc/Schemas/PROJ/PROJ/PROJ.pdf

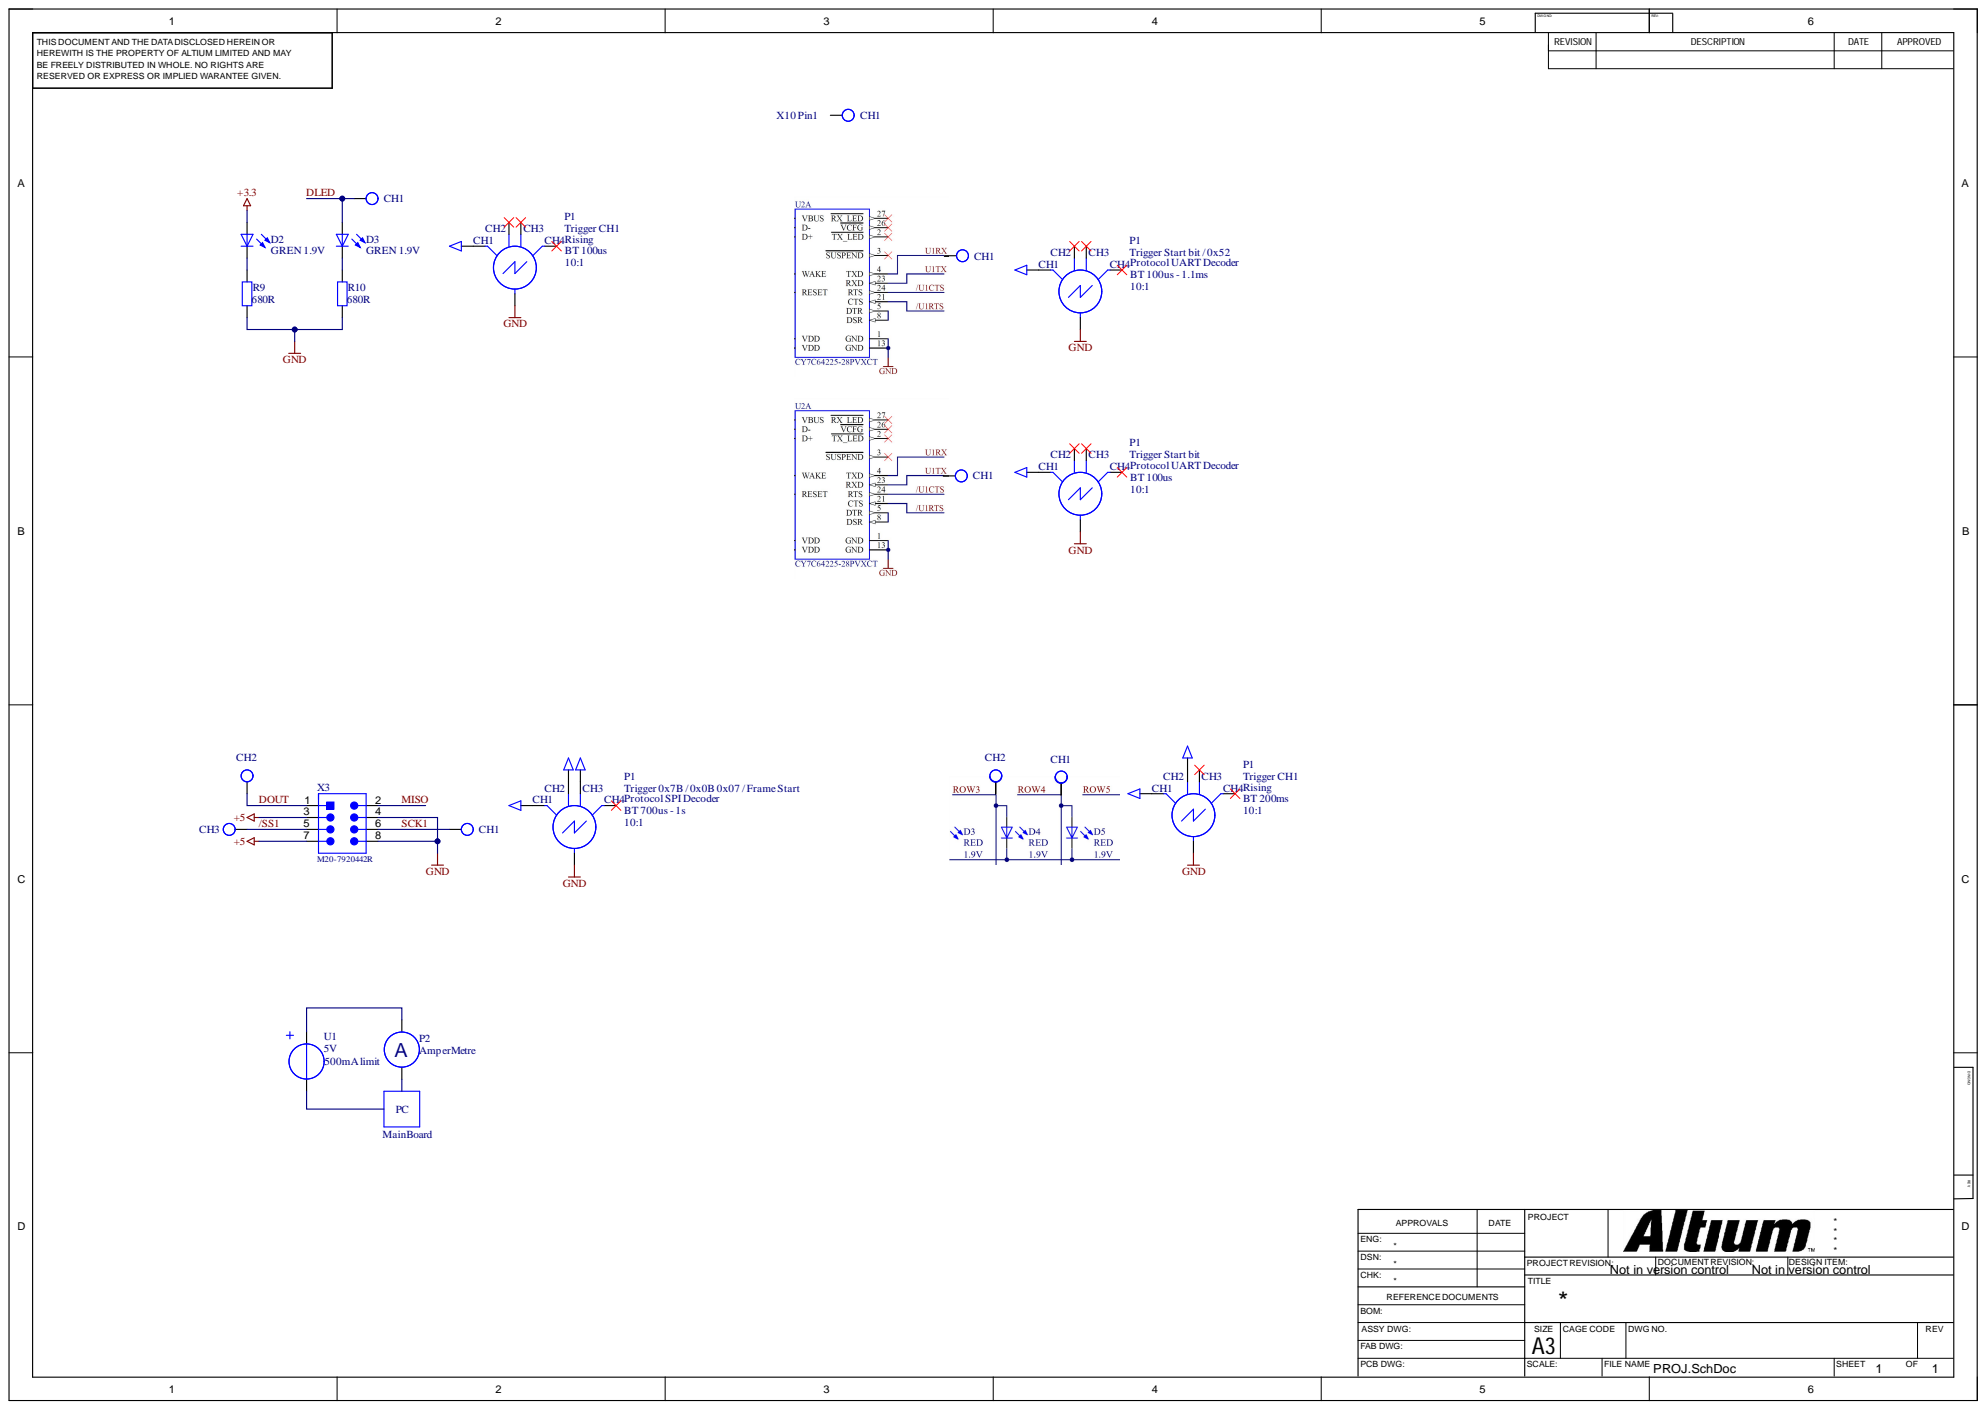
[picture p150: page 1]

1 | 2 | 3 | 4 | 5 | DWG NO: | REV: | 6

THIS DOCUMENT AND THE DATADISCLOSED HEREIN OR HEREWITH IS THE PROPERTY OF ALTIUM LIMITED AND MAY BE FREELY DISTRIBUTED IN WHOLE. NO RIGHTS ARE RESERVED OR EXPRESS OR IMPLIED WARANTEE GIVEN. | | REVISION | DESCRIPTION | DATE | APPROVED

DATE | PROJECT | * * APPROVALS * *

ENG: *
CHK: * | | TITLE *

DSN: *

PROJECTREVISION: Not in version control | DOCUMENTREVISION: Not in version control | DESIGN ITEM:
