ETML-ES-SLO/PRJ_2126_AffichageMatriciel/(list of files, drawings)

Other design files:
doc/Schemas/PROJ/PROJ/ES_Class6C_2L.PcbDoc
doc/Schemas/PROJ/PROJ/PROJ.PrjPcb
doc/Schemas/PROJ/PROJ/PROJ.SchDoc
hard/2126_A_MainBoard_AffichageMatricielNomEtudiant/2126_A_MainBoard_AffichageMatriciel.SchDoc
hard/2126_A_MainBoard_AffichageMatricielNomEtudiant/2126_AffichageMatriciel.PcbLib
hard/2126_A_MainBoard_AffichageMatricielNomEtudiant/2126_AffichageMatriciel.SchLib
hard/2126_A_MainBoard_AffichageMatricielNomEtudiant/2126_MainBoard_AffichageMatriciel.PrjPcb
hard/2126_A_MainBoard_AffichageMatricielNomEtudiant/ES_Class6C_2L.PcbDoc
hard/2126_A_MatrixBoard_AffichageMatricielNomEtudiant/2126_A_MatrixBoard_AffichageMatricielNomEtudiant.PrjPcb
hard/2126_A_MatrixBoard_AffichageMatricielNomEtudiant/2126_A_MatrixBoard_AffichageMatricielNomEtudiant.SchDoc
hard/2126_A_MatrixBoard_AffichageMatricielNomEtudiant/2126_AffichageMatriciel.PcbLib
hard/2126_A_MatrixBoard_AffichageMatricielNomEtudiant/2126_AffichageMatriciel.SchLib
hard/2126_A_MatrixBoard_AffichageMatricielNomEtudiant/ES_Class6C_2L.PcbDoc
hard/2126_B_MatrixBoard_AffichageMatricielNomEtudiant/2126_AffichageMatriciel.PcbLib
hard/2126_B_MatrixBoard_AffichageMatricielNomEtudiant/2126_AffichageMatriciel.SchLib
hard/2126_B_MatrixBoard_AffichageMatricielNomEtudiant/2126_B_MatrixBoard_AffichageMatricielNomEtudiant.PrjPcb
hard/2126_B_MatrixBoard_AffichageMatricielNomEtudiant/2126_B_MatrixBoard_AffichageMatricielNomEtudiant.SchDoc
hard/2126_B_MatrixBoard_AffichageMatricielNomEtudiant/ES_Class6C_2L.PcbDoc
hard/2126_B_MatrixBoard_Panel/Panel2EuroCircuit/ES_Class6C_2L.PcbDoc
hard/2126_B_MatrixBoard_Panel/Panel2EuroCircuit/Penel2EuroCircuit.PrjPcb
