ETML-ES-SLO/PRJ_2126_AffichageMatriciel/soft/FW_PIC/firmware/src/system_config/default/system_config.h

/*******************************************************************************
  MPLAB Harmony System Configuration Header

  File Name:
    system_config.h

  Summary:
    Build-time configuration header for the system defined by this MPLAB Harmony
    project.

  Description:
    An MPLAB Project may have multiple configurations.  This file defines the
    build-time options for a single configuration.

  Remarks:
    This configuration header must not define any prototypes or data
    definitions (or include any files that do).  It only provides macro
    definitions for build-time configuration options that are not instantiated
    until used by another MPLAB Harmony module or application.

    Created with MPLAB Harmony Version 2.06
*******************************************************************************/

// DOM-IGNORE-BEGIN
/*******************************************************************************
Copyright (c) 2013-2015 released Microchip Technology Inc.  All rights reserved.

Microchip licenses to you the right to use, modify, copy and distribute
Software only when embedded on a Microchip microcontroller or digital signal
controller that is integrated into your product or third party product
(pursuant to the sublicense terms in the accompanying license agreement).

You should refer to the license agreement accompanying this Software for
additional information regarding your rights and obligations.

SOFTWARE AND DOCUMENTATION ARE PROVIDED AS IS WITHOUT WARRANTY OF ANY KIND,
EITHER EXPRESS OR IMPLIED, INCLUDING WITHOUT LIMITATION, ANY WARRANTY OF
MERCHANTABILITY, TITLE, NON-INFRINGEMENT AND FITNESS FOR A PARTICULAR PURPOSE.
IN NO EVENT SHALL MICROCHIP OR ITS LICENSORS BE LIABLE OR OBLIGATED UNDER
CONTRACT, NEGLIGENCE, STRICT LIABILITY, CONTRIBUTION, BREACH OF WARRANTY, OR
OTHER LEGAL EQUITABLE THEORY ANY DIRECT OR INDIRECT DAMAGES OR EXPENSES
INCLUDING BUT NOT LIMITED TO ANY INCIDENTAL, SPECIAL, INDIRECT, PUNITIVE OR
CONSEQUENTIAL DAMAGES, LOST PROFITS OR LOST DATA, COST OF PROCUREMENT OF
SUBSTITUTE GOODS, TECHNOLOGY, SERVICES, OR ANY CLAIMS BY THIRD PARTIES
(INCLUDING BUT NOT LIMITED TO ANY DEFENSE THEREOF), OR OTHER SIMILAR COSTS.
*******************************************************************************/
// DOM-IGNORE-END

#ifndef _SYSTEM_CONFIG_H
#define _SYSTEM_CONFIG_H

// *****************************************************************************
// *****************************************************************************
// Section: Included Files
// *****************************************************************************
// *****************************************************************************
/*  This section Includes other configuration headers necessary to completely
    define this configuration.
*/


// DOM-IGNORE-BEGIN
#ifdef __cplusplus  // Provide C++ Compatibility

extern "C" {

#endif
// DOM-IGNORE-END

// *****************************************************************************
// *****************************************************************************
// Section: System Service Configuration
// *****************************************************************************
// *****************************************************************************
// *****************************************************************************
/* Common System Service Configuration Options
*/
#define SYS_VERSION_STR           "2.06"
#define SYS_VERSION               20600

// *****************************************************************************
/* Clock System Service Configuration Options
*/
#define SYS_CLK_FREQ                        40000000ul
#define SYS_CLK_BUS_PERIPHERAL_1            40000000ul
#define SYS_CLK_UPLL_BEFORE_DIV2_FREQ       192000000ul
#define SYS_CLK_CONFIG_PRIMARY_XTAL         8000000ul
#define SYS_CLK_CONFIG_SECONDARY_XTAL       32768ul
   
/*** Ports System Service Configuration ***/
#define SYS_PORT_A_ANSEL        0xFFEC
#define SYS_PORT_A_TRIS         0xFFEF
#define SYS_PORT_A_LAT          0x0000
#define SYS_PORT_A_ODC          0x0000
#define SYS_PORT_A_CNPU         0x0000
#define SYS_PORT_A_CNPD         0x0000
#define SYS_PORT_A_CNEN         0x0000

#define SYS_PORT_B_ANSEL        0x0000
#define SYS_PORT_B_TRIS         0x5FFF
#define SYS_PORT_B_LAT          0x8000
#define SYS_PORT_B_ODC          0x0000
#define SYS_PORT_B_CNPU         0x0000
#define SYS_PORT_B_CNPD         0x0000
#define SYS_PORT_B_CNEN         0x0000


/*** Interrupt System Service Configuration ***/
#define SYS_INT                     true

// *****************************************************************************
// *****************************************************************************
// Section: Driver Configuration
// *****************************************************************************
// *****************************************************************************

/*** SPI Driver Configuration ***/
#define DRV_SPI_NUMBER_OF_MODULES		2
/*** Driver Compilation and static configuration options. ***/
/*** Select SPI compilation units.***/
#define DRV_SPI_POLLED 				1
#define DRV_SPI_ISR 				0
#define DRV_SPI_MASTER 				1
#define DRV_SPI_SLAVE 				0
#define DRV_SPI_RM 					0
#define DRV_SPI_EBM 				1
#define DRV_SPI_8BIT 				1
#define DRV_SPI_16BIT 				0
#define DRV_SPI_32BIT 				0
#define DRV_SPI_DMA 				0

/*** SPI Driver Static Allocation Options ***/
#define DRV_SPI_INSTANCES_NUMBER 		1
#define DRV_SPI_CLIENTS_NUMBER 			1
#define DRV_SPI_ELEMENTS_PER_QUEUE 		10
/*** Timer Driver Configuration ***/
#define DRV_TMR_INTERRUPT_MODE             true

/*** Timer Driver 0 Configuration ***/
#define DRV_TMR_PERIPHERAL_ID_IDX0          TMR_ID_1
#define DRV_TMR_INTERRUPT_SOURCE_IDX0       INT_SOURCE_TIMER_1
#define DRV_TMR_INTERRUPT_VECTOR_IDX0       INT_VECTOR_T1
#define DRV_TMR_ISR_VECTOR_IDX0             _TIMER_1_VECTOR
#define DRV_TMR_INTERRUPT_PRIORITY_IDX0     INT_PRIORITY_LEVEL3
#define DRV_TMR_INTERRUPT_SUB_PRIORITY_IDX0 INT_SUBPRIORITY_LEVEL0
#define DRV_TMR_CLOCK_SOURCE_IDX0           DRV_TMR_CLKSOURCE_INTERNAL
#define DRV_TMR_PRESCALE_IDX0               TMR_PRESCALE_VALUE_1
#define DRV_TMR_OPERATION_MODE_IDX0         DRV_TMR_OPERATION_MODE_16_BIT
#define DRV_TMR_ASYNC_WRITE_ENABLE_IDX0     false
#define DRV_TMR_POWER_STATE_IDX0            


 // *****************************************************************************
/* USART Driver Configuration Options
*/
#define DRV_USART_INSTANCES_NUMBER                  1
#define DRV_USART_CLIENTS_NUMBER                    1
#define DRV_USART_INTERRUPT_MODE                    false
#define DRV_USART_BYTE_MODEL_SUPPORT                true
#define DRV_USART_READ_WRITE_MODEL_SUPPORT          false
#define DRV_USART_BUFFER_QUEUE_SUPPORT              false

// *****************************************************************************
// *****************************************************************************
// Section: Middleware & Other Library Configuration
// *****************************************************************************
// *****************************************************************************



// *****************************************************************************
// *****************************************************************************
// Section: Application Configuration
// *****************************************************************************
// *****************************************************************************
/*** Application Defined Pins ***/

/*** Functions for DLED_ pin ***/
#define DLED_Toggle() PLIB_PORTS_PinToggle(PORTS_ID_0, PORT_CHANNEL_A, PORTS_BIT_POS_4)
#define DLED_On() PLIB_PORTS_PinSet(PORTS_ID_0, PORT_CHANNEL_A, PORTS_BIT_POS_4)
#define DLED_Off() PLIB_PORTS_PinClear(PORTS_ID_0, PORT_CHANNEL_A, PORTS_BIT_POS_4)
#define DLED_StateGet() PLIB_PORTS_PinGetLatched(PORTS_ID_0, PORT_CHANNEL_A, PORTS_BIT_POS_4)
#define DLED_StateSet(Value) PLIB_PORTS_PinWrite(PORTS_ID_0, PORT_CHANNEL_A, PORTS_BIT_POS_4, Value)

/*** Functions for SS1_ pin ***/
#define SS1_Toggle() PLIB_PORTS_PinToggle(PORTS_ID_0, PORT_CHANNEL_B, PORTS_BIT_POS_15)
#define SS1_On() PLIB_PORTS_PinSet(PORTS_ID_0, PORT_CHANNEL_B, PORTS_BIT_POS_15)
#define SS1_Off() PLIB_PORTS_PinClear(PORTS_ID_0, PORT_CHANNEL_B, PORTS_BIT_POS_15)
#define SS1_StateGet() PLIB_PORTS_PinGetLatched(PORTS_ID_0, PORT_CHANNEL_B, PORTS_BIT_POS_15)
#define SS1_StateSet(Value) PLIB_PORTS_PinWrite(PORTS_ID_0, PORT_CHANNEL_B, PORTS_BIT_POS_15, Value)


/*** Application Instance 0 Configuration ***/

//DOM-IGNORE-BEGIN
#ifdef __cplusplus
}
#endif
//DOM-IGNORE-END

#endif // _SYSTEM_CONFIG_H
/*******************************************************************************
 End of File
*/
